orbswarm/orbswarm-svn/media/SWARMtalk/images/shellconstruction.JPG

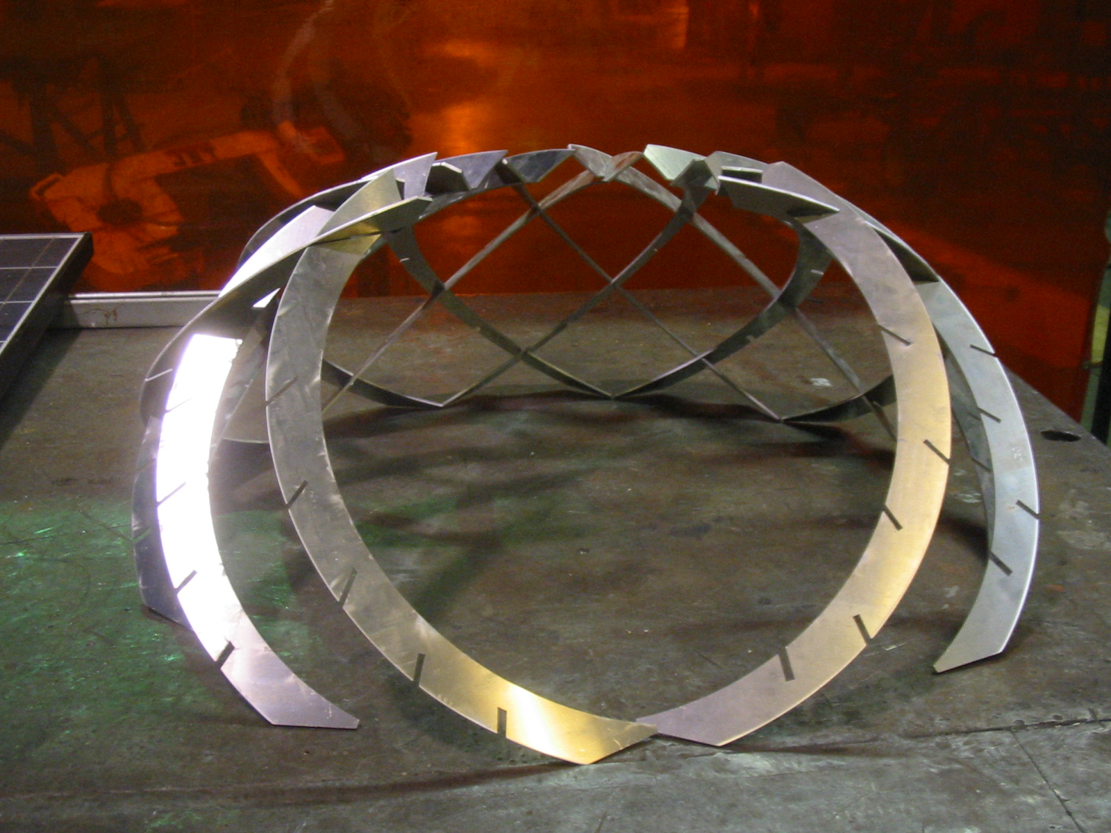
media/SWARMtalk/images/shellconstruction.JPG
