orbswarm/orbswarm-svn/media/SWARMtalk/images/chassis-left.JPG

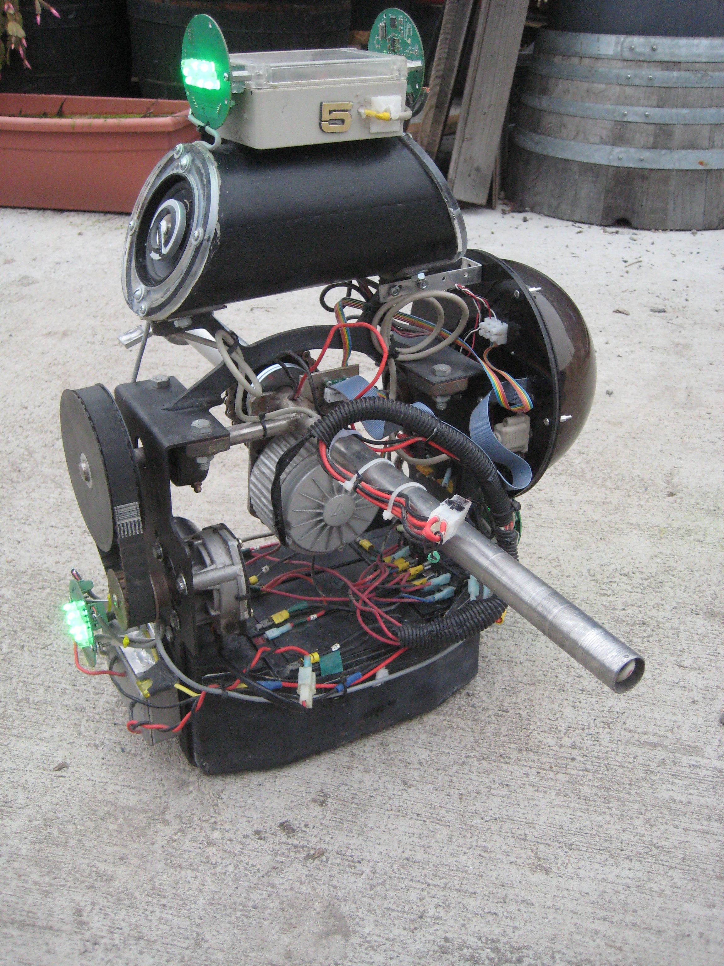
media/SWARMtalk/images/chassis-left.JPG
