orbswarm/orbswarm-svn/README.txt

An import of the Orbswarm subversion repository (http://svn.lee.org/swarm/)
into git, for archival purposes.

                                -- Michael Toren <mct@toren.net>
                                   Thu Oct 23 01:54:14 PDT 2014
