orbswarm/orbswarm-svn/media/readme.txt

This directory contains media files associated with the SWARM project:

SWARMtalk: an Open Office (Powerpoint-like) presentation on SWARM
thankyoucards: Thank-you cards sent out to SWARM supporters
