orbswarm/orbswarm-svn/media/SWARMtalk/readme.txt

In this directory: presentations and images about SWARM

swarm-talk.*: Short 5-slide presentation for Dorkbot
(odp is Open Office powerpoint replacement; I will convert to ppt and rename sometime)

SWARM-ignite.*: more complete 20-slide presentation of O'Reilly Ignite
ppt file is 20MB!

Jon Foote
