orbswarm/orbswarm-svn/media/thankyoucards/readme.txt

This are thank-you cards we sent out in Fall of 2007
It is in Open Office Presenter format: an open-source Powerpoint replacement.

You can get Open Office from here http://www.openoffice.org/

Jon Foote
