orbswarm/orbswarm-svn/Illuminator/DesignFileLocation.txt

All Illuminator design files are located in the PCB/Illuminator directory
