orbswarm/orbswarm-svn/remote/punchlist.txt

For remotes:

Test macro button on all remotes
Test turbo switch and code

To add to remote code:

+ new light modes: hue bloom and brightness modulate (spin)
+ transmit LED
+ set max speed and other modes serially over Zigbee?
