orbswarm/orbswarm-svn/power/OrbRunandChargeCon.pdf

2008/08/12 | OrbRunandChargeCon.odg SWARM
Orb Run & Charge
| Connectors

Notes:
Drawings not to scale
See schematic for wiring details

4

5

6

1

2

3

Red Wire &
Jumper to 2

Black Wire

NC

Run Plug (Fakey)
Male Molex Connector

4

5

6

1

2

3

Jumper to 1

NC

Jumper to 3

Charging Plug
Male Molex Connector

Jumper from 4

NC

Jumper from 6

NC

Red Jumper from 4

NC

Pin View | Pin View
