orbswarm/orbswarm-svn/power/OrbPowerConandBattID.pdf

2008/08/12 | OrbPowerConandBattID.odg SWARM
Orb Power Connector &
Battery Identification

Female Molex Connector
on Orb

(Wire B: 24V for Motor)

(Wire A: Charge Enable)

(Wire D: +12V)

SPU
Dome

Steering
Motor

Batteries in Battery Tray

Notes:
Drawings not to scale
See schematic for wiring details Relays are located above battery 5

5 1

2

3

4

K3

K2

K1

+ | - | + | -

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
(Wire C: +24V)

(Wire F:COM)

(Wire E: +12V for Electr.)

Socket View

Relays
