orbswarm/orbswarm-svn/media/hbroboticsTalk/kalman_estimator.pdf

## Kalman Filters for Robotics:

Getting the Most from your Sensors

Michael Prados
mpradosNOSPAM@gmail.com

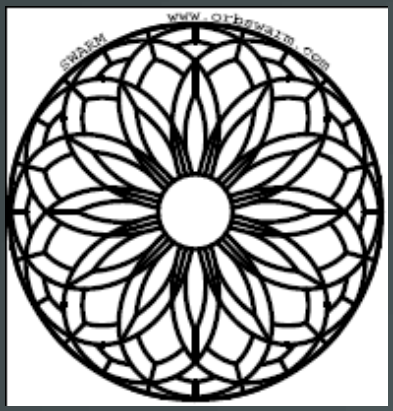
[picture p8: figure]

The SWARM Project
http://orbswarm.com

## What's Wrong With Me?

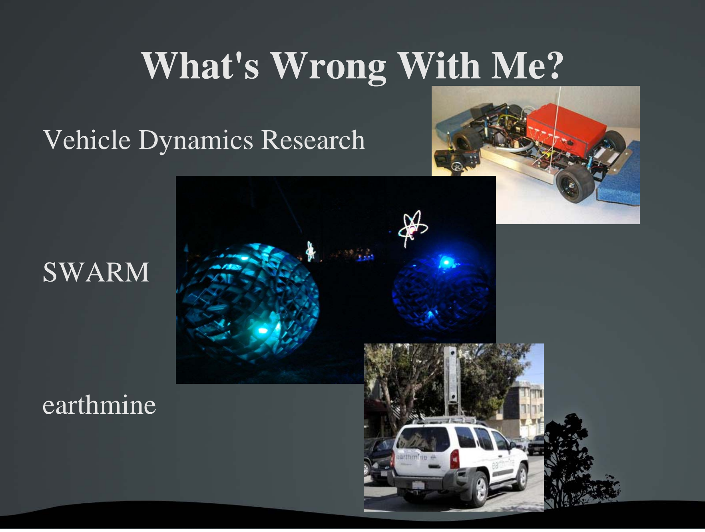
[picture p9: page 2]

Vehicle Dynamics Research

SWARM

earthmine

## SWARM – Positional Robotic Art

- Six Spherical Robots
- 760mm (30in) Diameter, 40kg (90lbs) each
- Consumer Grade GPS- 3m accuracy
- Sparkfun 5-DOF IMU
- ADXL330 3-DOF Accelerometer
- IDG300 2-DOF Rate Gyro
- Wheel Encoder, Kinematic Model
- All Open Source!

## Some Positional Sensors for Robotics

Sensors are a robot's window to the world!
- Inertial sensors
- Accelerometers
- Rate Gyros
- Electrolytic Tilt Sensors
- Position Sensors
- GPS
- Wheel Encoders
- Sonar

## Problems with Positional Sensors

- Inertial sensors – DC Bias, Noise
- Position Sensors
- GPS – outages, low frequency, noise
- Wheel Encoders – relative position, slip
- Sonar – limited range, noise

## What is a Kalman Filter?

(aka Kalman Estimator, Kalman Observer)
- A Kalman filter is an optimal observer
- It will trade off the relative strengths of your sensors, in order to provide an optimal estimate of your system states
- Always applied to a state space model of a system
- Must derive a system model, but can often be simple
- Either discrete time or continuous
- Usually must go to discrete time for implementation

## Octave and Matlab

- Matlab is an expensive commercial product for matrix algebra and numerical processing
- Great estimation and control system support
- Octave is a very similar, free open source alternative
- Almost as good
- Easier to share

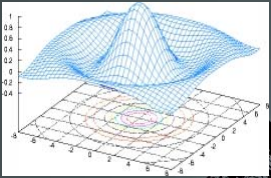
[picture p10: figure]

## What is a State Space Model?

- A model of a dynamic system,
using a system of differential equations
- In general:
- An example:

x˙ =Ax

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
[⁰0 10

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
[countencoder]=[0

k ]

[
v
x

]

## Small Angle Approximation

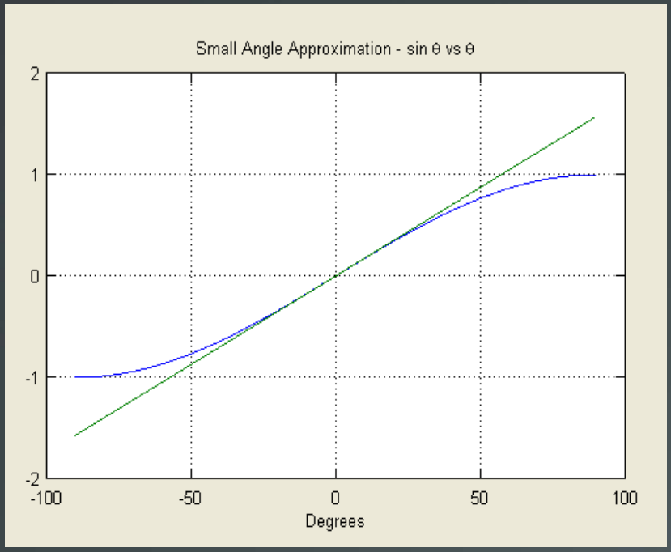
[picture p11: figure]

- Pretty good up to +/- 30 degrees
- Remember to implement using radians!

## Continuous vs Discrete

- Continuous time is a mathematically elegant representation using derivatives
- Relatively hard to code!
- Discrete time representation tells you directly how to get the next step from the current one
- For most systems, octave will do the conversion! discrete_sys = c2d(continuous_sys, T);

x
k
1

=
f
x
k

## The Observer

- For a system-
- We estimate the states like this-

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
## Inverted Pendulum

- Inverted pendulum model
- Rate gyro, and accelerometer tilt sensor

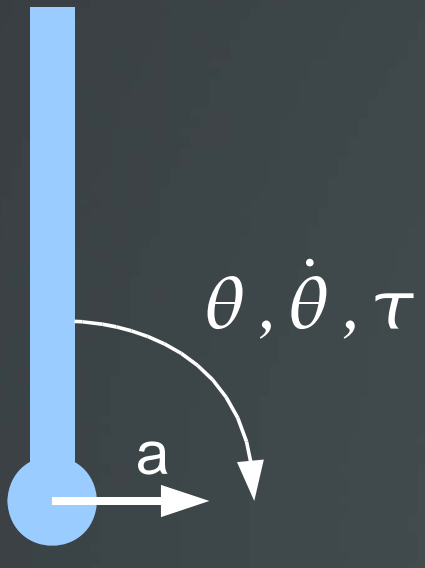
[picture p12: figure]

[
¨

˙]
=

[⁰0 10

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
In Octave...

- Create system
with A,B,C,D
- Use c2d
- Set QW, RV
- Invoke dkalman

### Presto, optimal observer!

### [¨˙]=[⁰0 10][˙][¹/I m 0 ]W

[a ]=[¹0 0 g ][˙]V

A | B

C

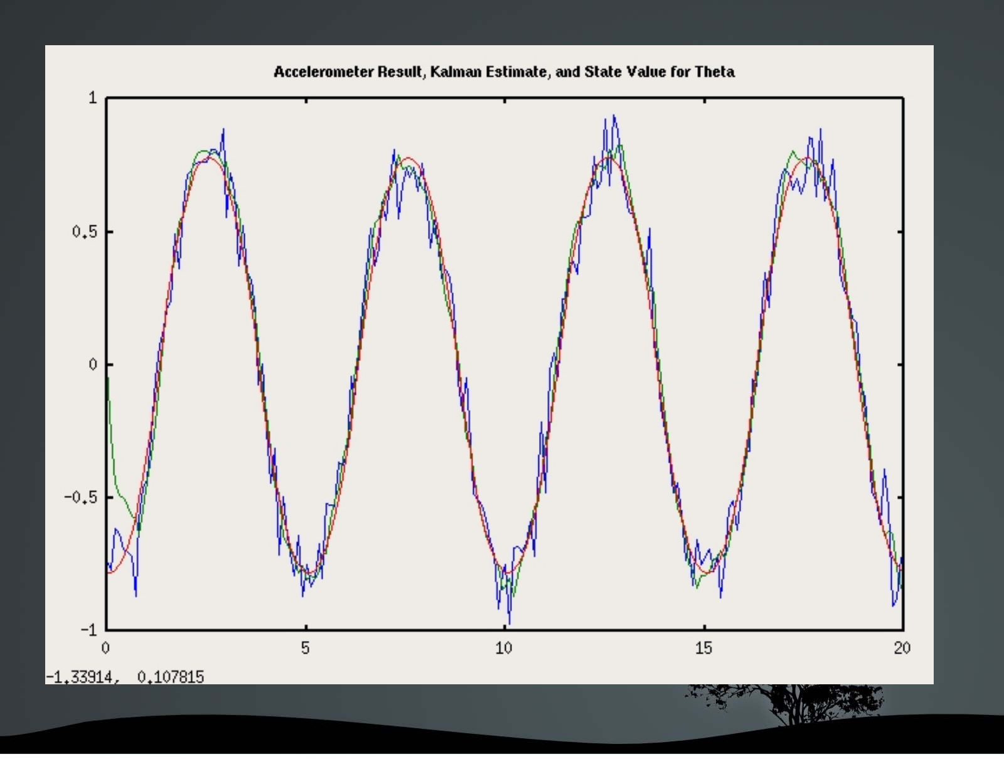
[picture p13: page 14]
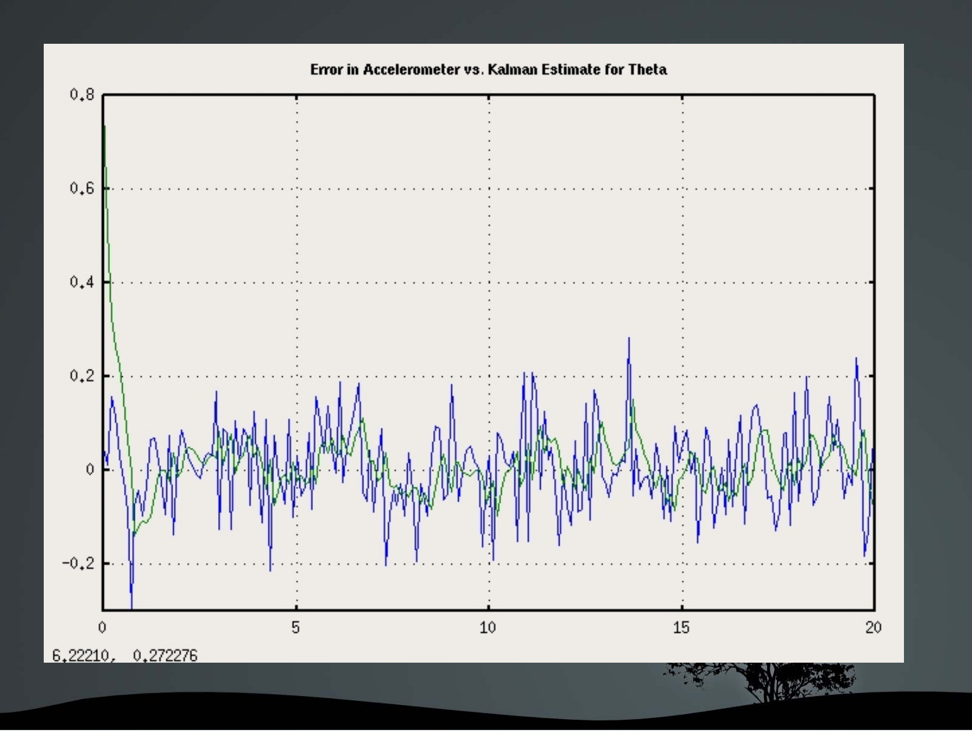
[picture p14: page 15]

## Limitations of the Kalman Filter

- For Good Performance
- No strong nonlinearities
- Definitely no trig with greater than +/- 90 degree motion!
- Zero-mean noise – No DC offset
- Necessary conditions to be optimal, but often less important-
- Noise has gaussian distribution
- Noise is white
- Noise is not auto-correlated

## DC Offset

- Common for inertial sensors
- Rate Gyro's and accelerometers
- Need to debias
- Add state to system-
[ ¨˙ bias˙ gyro]=[⁰⁰⁰ ¹⁰¹ 000][ ˙ biasgyro][¹/I m 00 ]W

[a ]=[¹00 0 g 0][ ˙ biasgyro]V

## Extended Kalman Filter

- Necessary for systems with strong nonlinearity
- Large angle motion- certainly greater that 180 degrees
- Squares, cubes, exponentials

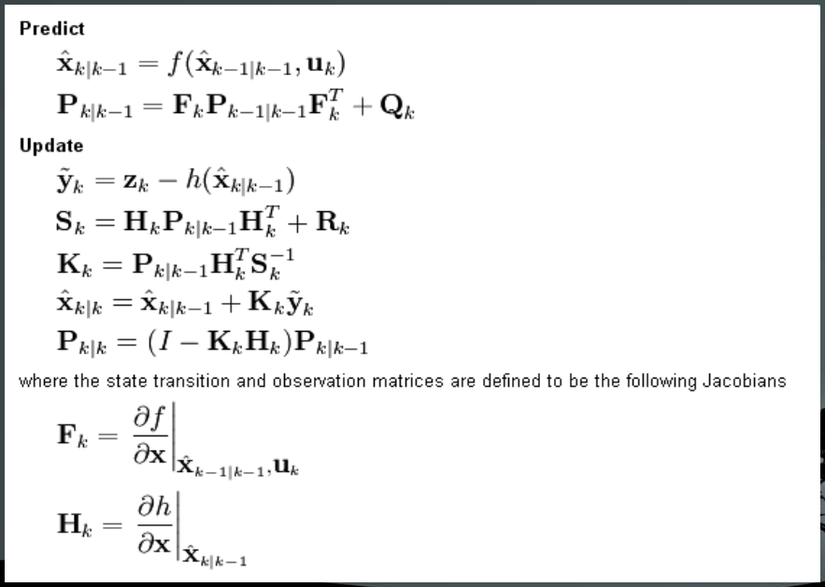
[picture p15: figure]

## SWARM Extended Kalman Filter

- 13 states
- 10 sensors
- Kinematic model – too big for slide.
- Work in progress! | info@orbswarm.com
v,v, ˙ | ˙ ,, ,, x ,y,
xab ,yab ,zab , xrb ,zrb

x

a ,y

| a ,z a , x r ,z r , xgps ,y gps ,gps ,v gps ,

## Implementation

- Translation to C code
- Easier with some matrix manipulation libraries
- Fixed vs floating point
- Usually possible in fixed point, but often quite laborious
- For more than 2-4 states, probably worth floating point
- Emulation – 8 bit micro, ARM
- FPU – x86, PPC, some ARM (caution!)
- DSP – great platform, steep learning curve

## Where to Go

Good Optimization and Control Texts:
- Design of Feedback Control Systems
- Stefani, Shahian, Savant, Hostetter – Oxford University Press
- Digital Control of Dynamic Systems
- Franklin, Powell, and Workman – Addison Wesley
More advanced:
- Applied Optimal Estimation
- Gelb – M.I.T. Press
- Optimal Control and Estimation
- Stengel – Dover Publications

## Thanks!

?
