orbswarm/orbswarm-svn/pcb/aggregator/netlist.txt

Netlist

Exported from swarm-agg1.sch at  6/19/2007 05:56:52a

EAGLE Version 4.16r1 Copyright (c) 1988-2006 CadSoft

Net      Part     Pad      Pin        Sheet

GND      C1       2        2          1
         C10      2        2          1
         C11      2        2          1
         C12      2        2          1
         C13      2        2          1
         C14      2        2          1
         C15      2        2          1
         C19      2        2          1
         C2       2        2          1
         C20      2        2          1
         C24      2        2          1
         C25      2        2          1
         C27      2        2          1
         C3       2        2          1
         C4       2        2          1
         C5       2        2          1
         C6       2        2          1
         C7       2        2          1
         C8       2        2          1
         C9       2        2          1
         IC3      GND      GND        1
         J1       1        1          1
         J2       2        S          1
         J3       1        1          1
         J3       5        5          1
         J4       6        6          1
         U1       11       GND        1
         U1       32       GND1       1
         U1       62       GND2       1
         U1       81       GND3       1
         U1       99       AGND       1
         U2       15       GND        1
         U3       15       GND        1
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
         U1       10       VCC        1
         U1       31       VCC1       1
         U1       61       VCC2       1
         U1       80       VCC3       1
         U2       16       VCC        1
         U3       16       VCC        1
         XB1      1        VCC        1
