orbswarm/orbswarm-svn/media/SWARMtalk/swarm-talk.odp

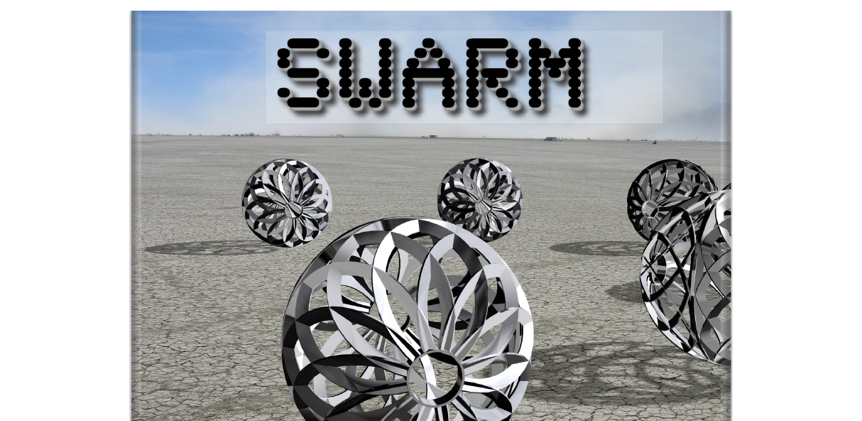
[picture p16: figure]

## Slide 2

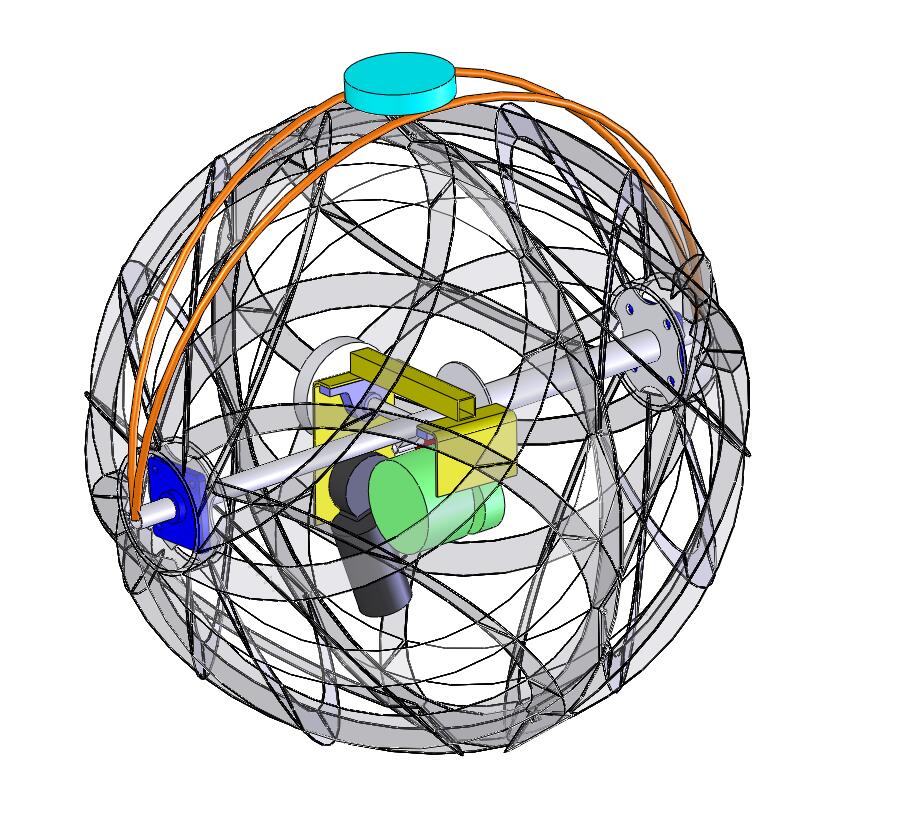
[picture p17: figure]
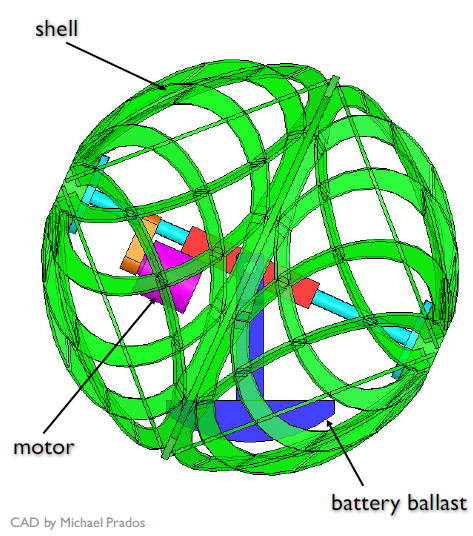
[picture p18: figure]

## Slide 3

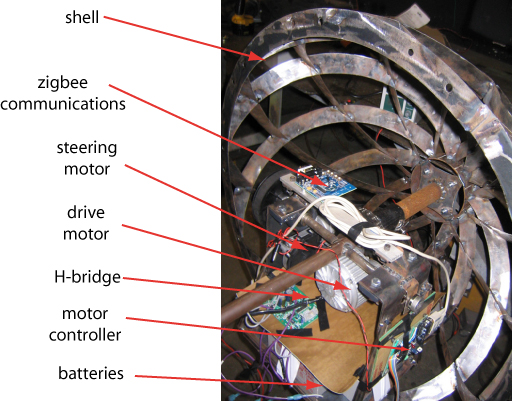
[picture p19: figure]
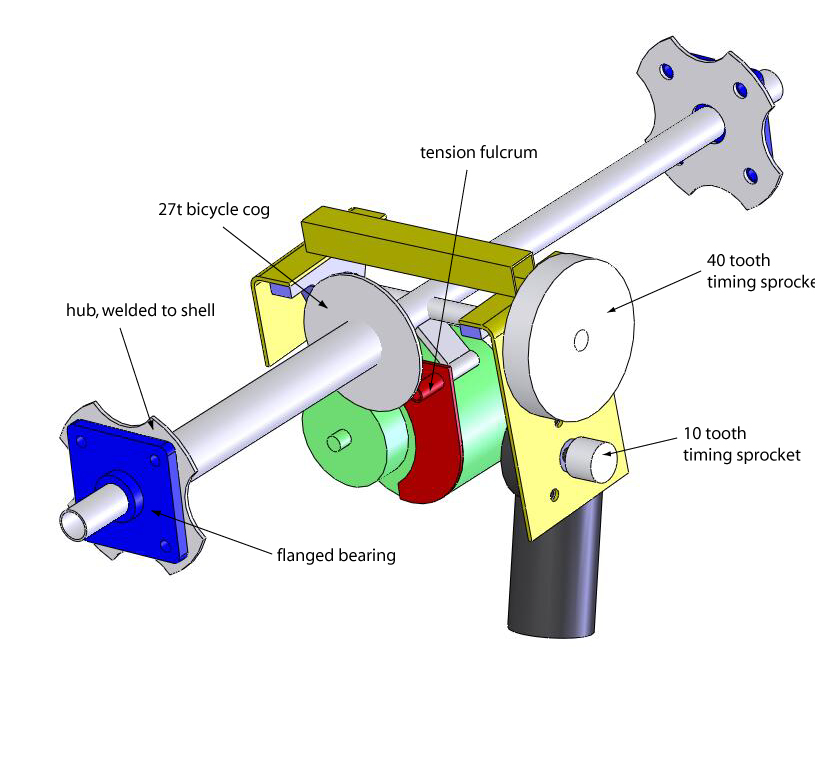
[picture p20: figure]

## Slide 4

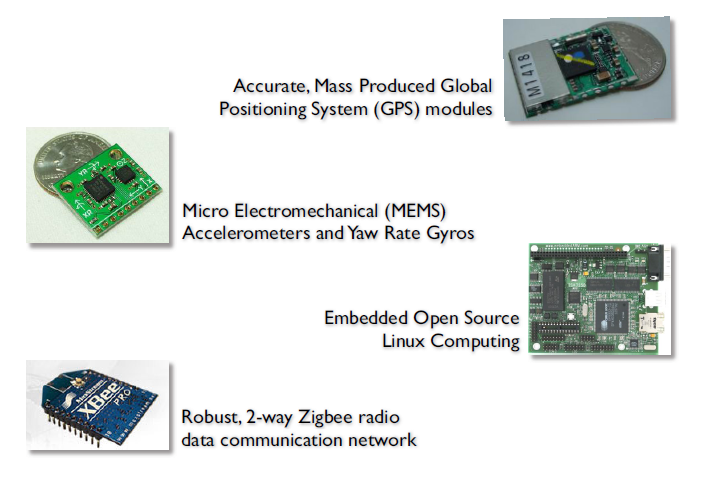
[picture p21: figure]

## Slide 5

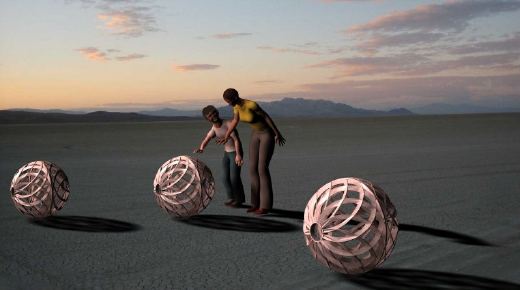
[picture p22: figure]

## Slide 6

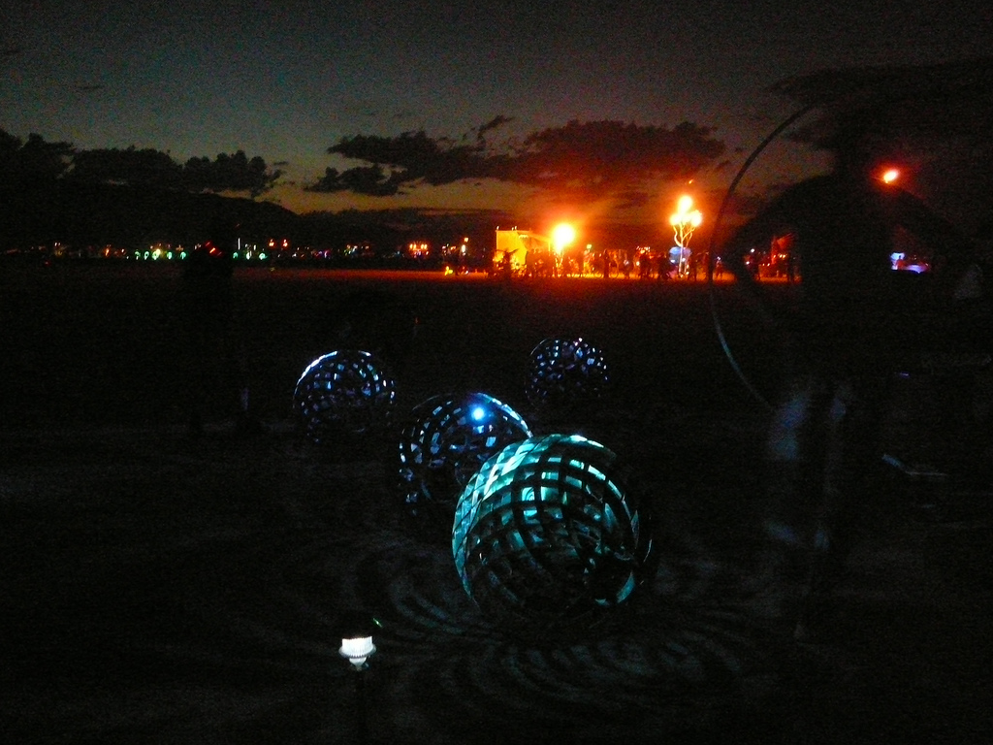
[picture p23: figure]
