orbswarm/orbswarm-svn/media/thankyoucards/thankyou.pdf

# SWARM thanks you

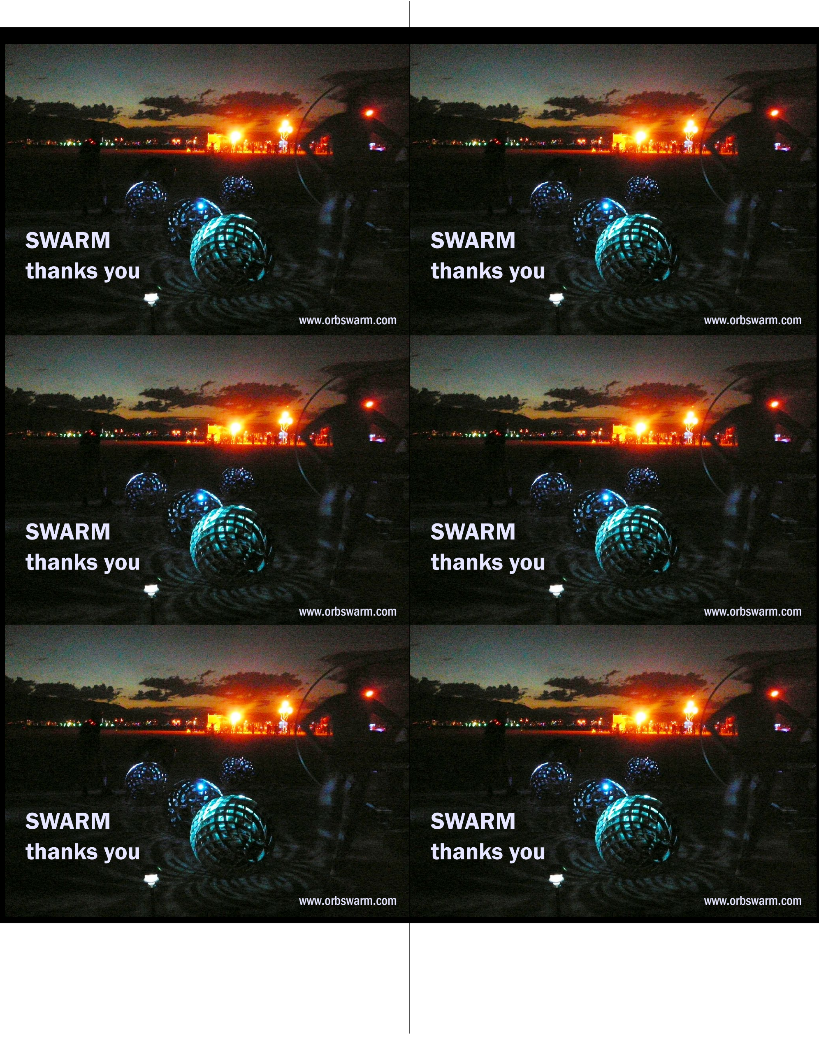
[picture p24: page 1]

www.orbswarm.com

www.orbswarm.com

# SWARM thanks you

www.orbswarm.com

# SWARM thanks you

www.orbswarm.com

# SWARM thanks you

www.orbswarm.com

# SWARM thanks you

www.orbswarm.com

# SWARM thanks you
