orbswarm/orbswarm-svn/media/cards/SWARM_businesscard.jpg

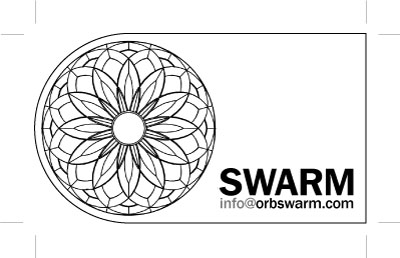
media/cards/SWARM_businesscard.jpg
