orbswarm/orbswarm-svn/media/cards/SWARM_personalcard.jpg

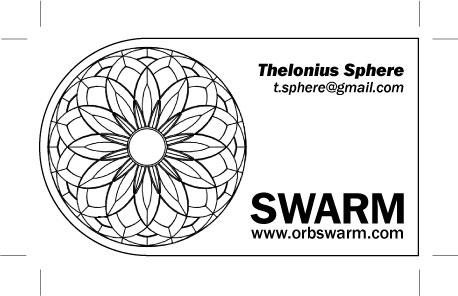
media/cards/SWARM_personalcard.jpg
