orbswarm/orbswarm-svn/media/stickers/SWARM_sticker_design_600px.jpg

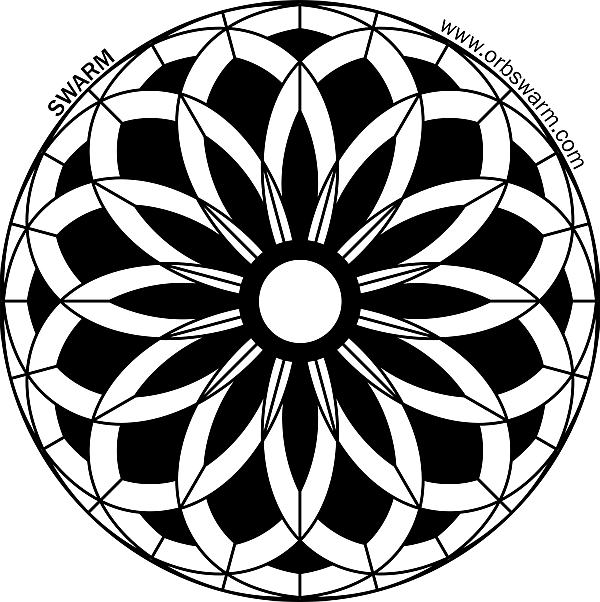
media/stickers/SWARM_sticker_design_600px.jpg
