orbswarm/orbswarm-svn/media/SWARMtalk/images/2007man.jpg

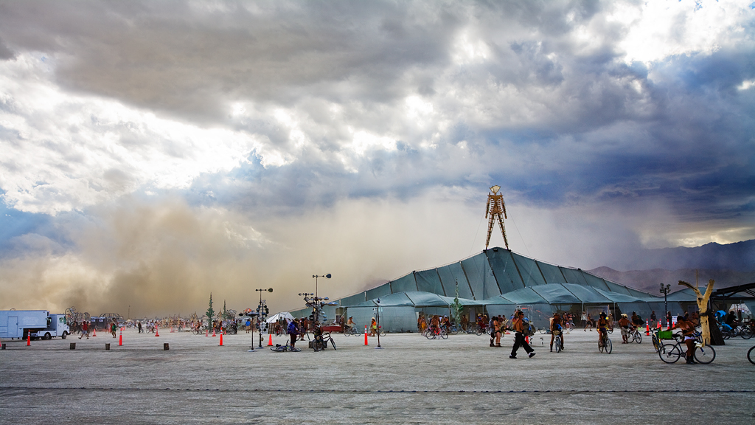
media/SWARMtalk/images/2007man.jpg
