orbswarm/orbswarm-svn/media/SWARMtalk/images/Burningcam-picture-49.jpg

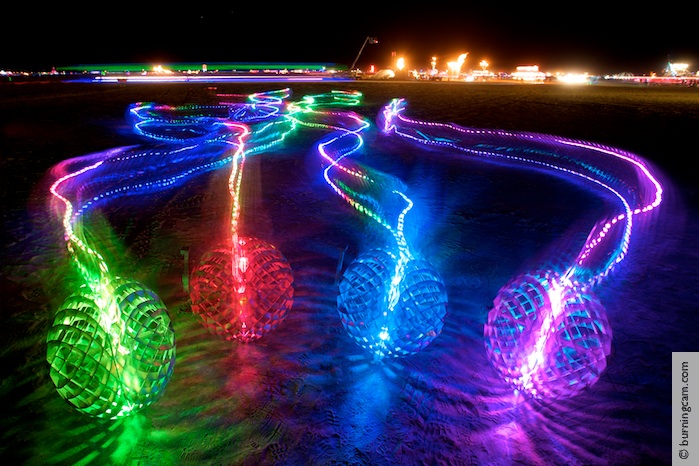
media/SWARMtalk/images/Burningcam-picture-49.jpg
