orbswarm/orbswarm-svn/media/SWARMtalk/images/California-Academy-Nightlife.jpg

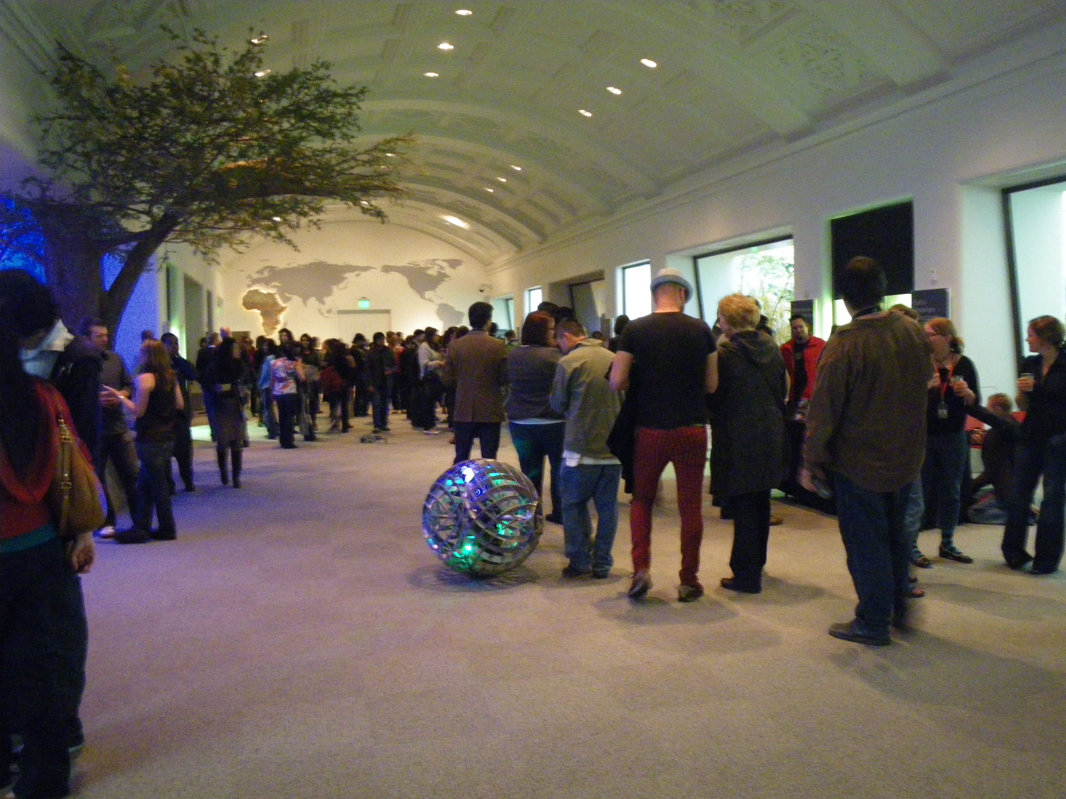
media/SWARMtalk/images/California-Academy-Nightlife.jpg
