orbswarm/orbswarm-svn/media/SWARMtalk/images/chassis-right.JPG

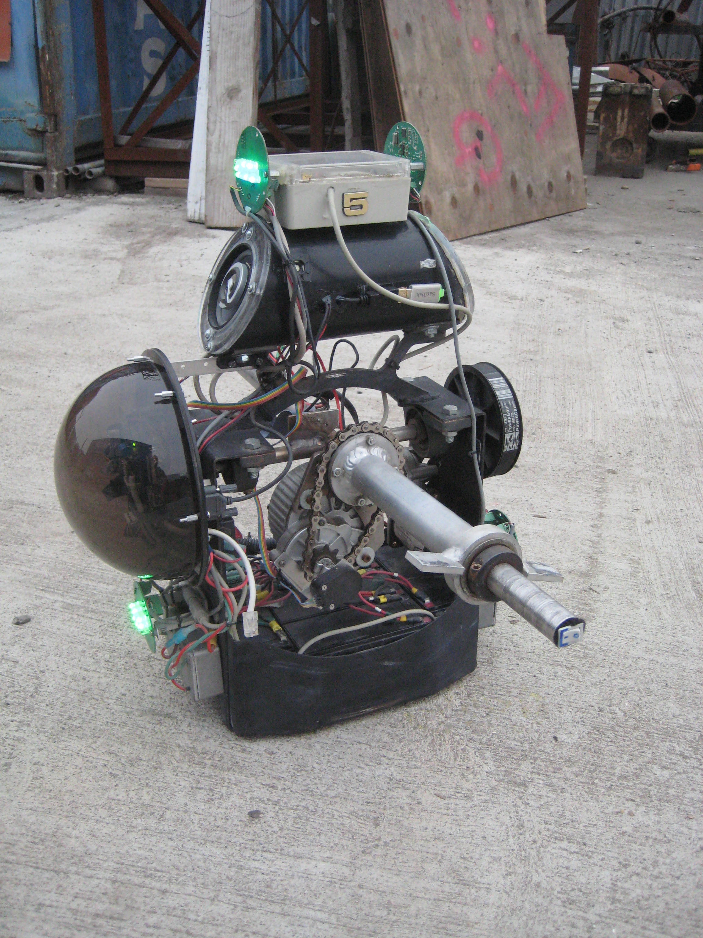
media/SWARMtalk/images/chassis-right.JPG
