orbswarm/orbswarm-svn/media/SWARMtalk/images/dust+man.jpg

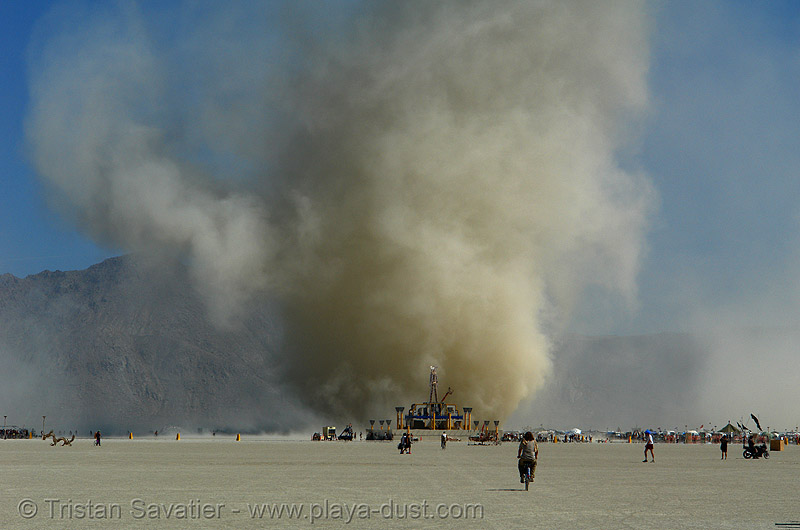
media/SWARMtalk/images/dust+man.jpg
