orbswarm/orbswarm-svn/media/SWARMtalk/images/Frederic_Larson_Crash_and_Burn.png

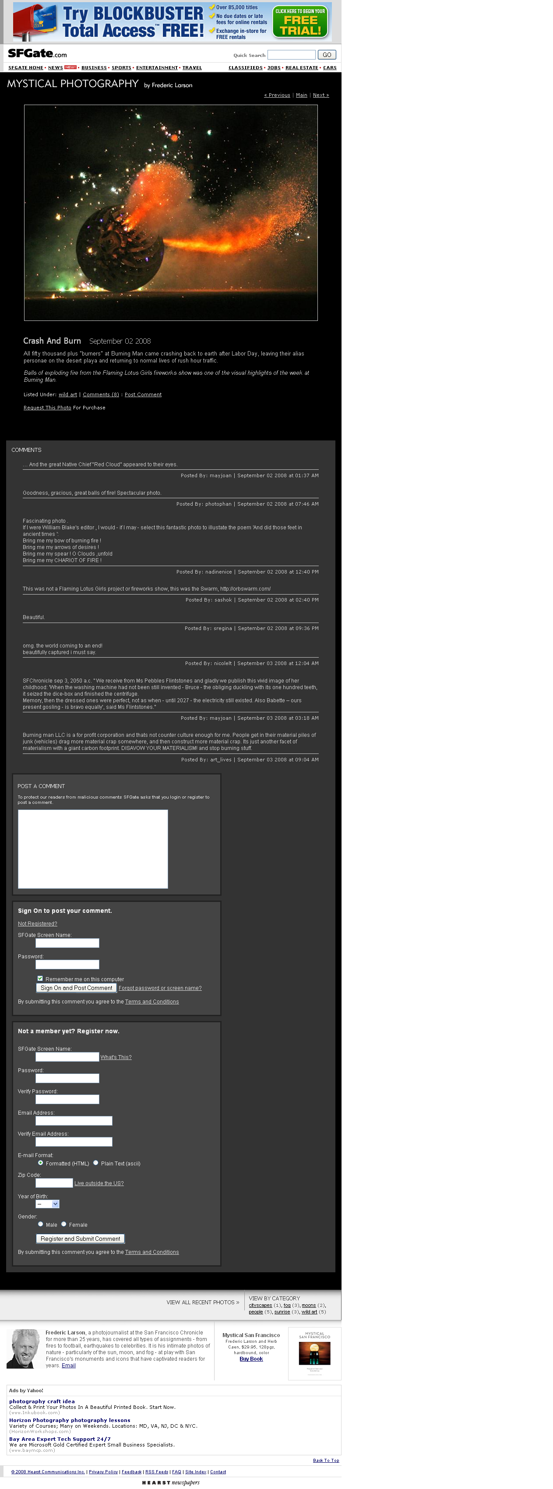
media/SWARMtalk/images/Frederic_Larson_Crash_and_Burn.png
