orbswarm/orbswarm-svn/media/SWARMtalk/images/GlamourLee+erik.JPG

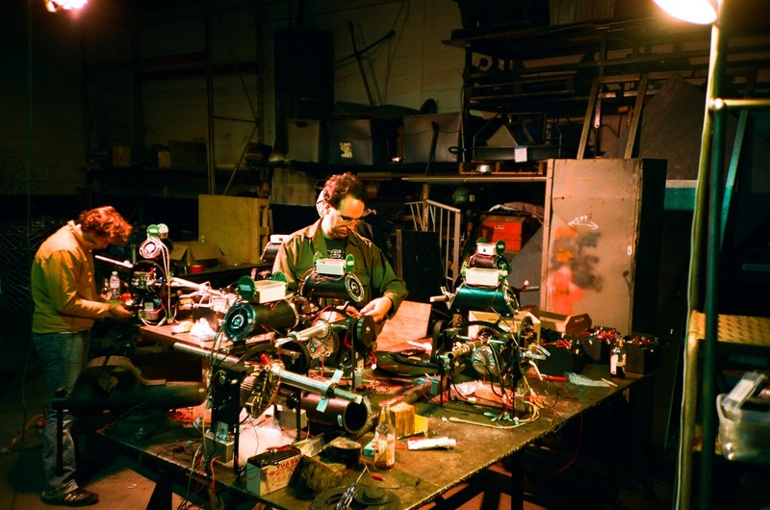
media/SWARMtalk/images/GlamourLee+erik.JPG
