orbswarm/orbswarm-svn/media/SWARMtalk/images/img_9218.jpg

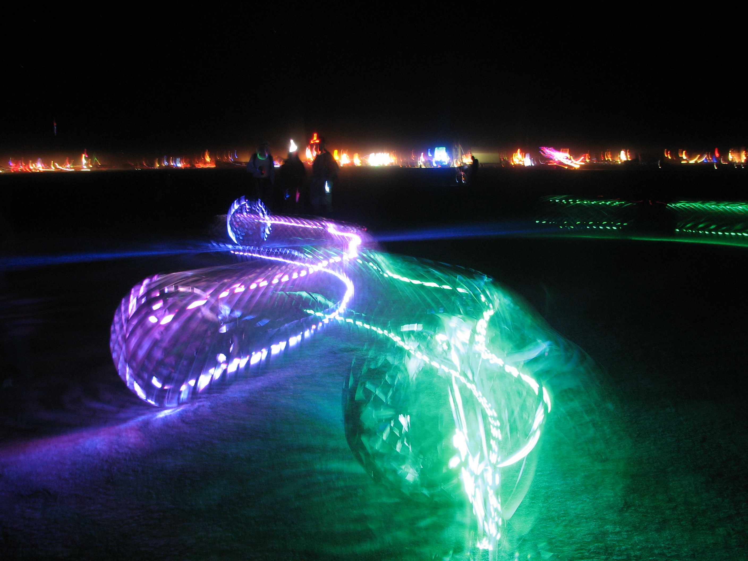
media/SWARMtalk/images/img_9218.jpg
