orbswarm/orbswarm-svn/media/SWARMtalk/images/Mechanical_annot.jpg

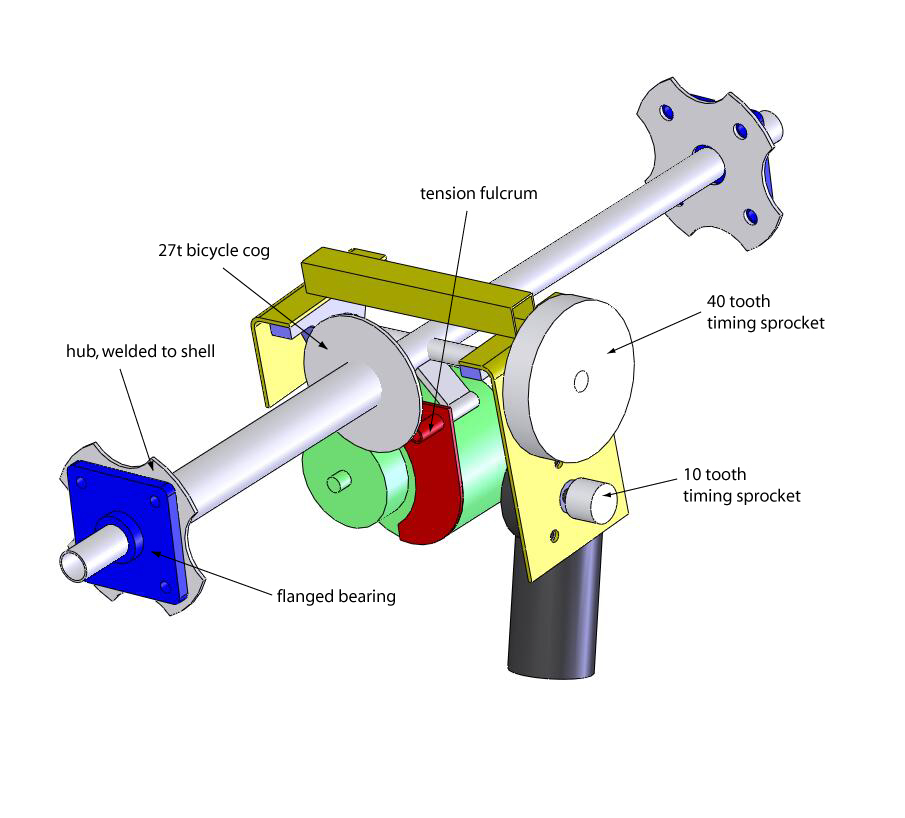
media/SWARMtalk/images/Mechanical_annot.jpg
