orbswarm/orbswarm-svn/media/SWARMtalk/images/mothership-night.jpg

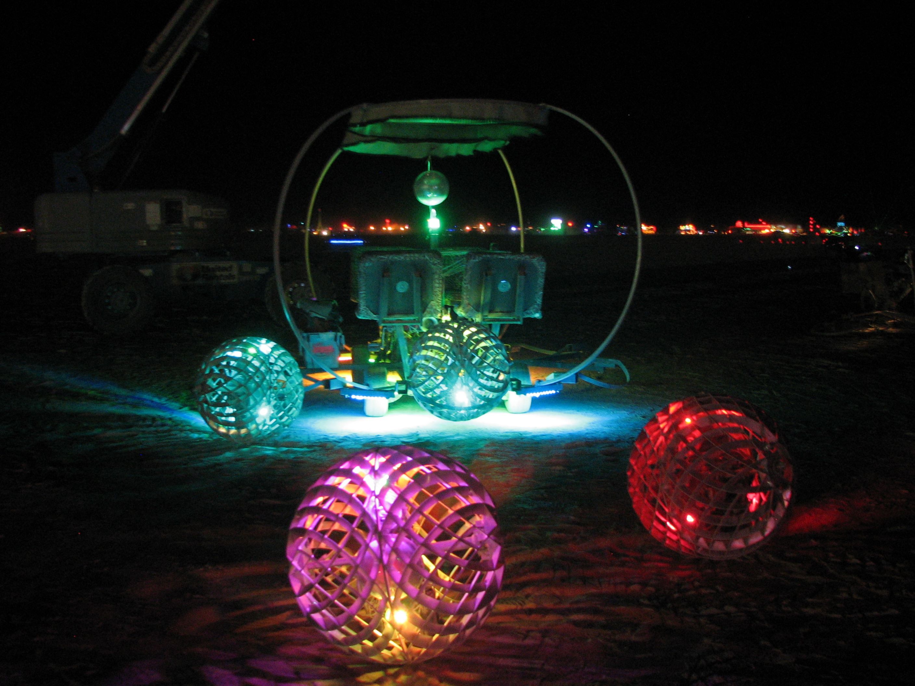
media/SWARMtalk/images/mothership-night.jpg
