orbswarm/orbswarm-svn/media/SWARMtalk/images/orbs2.jpg

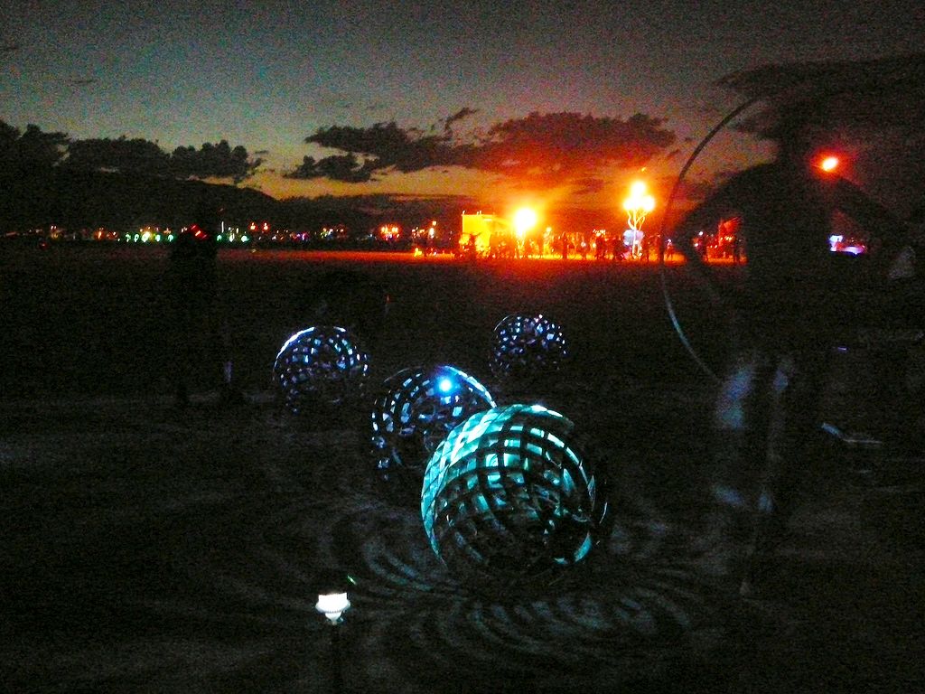
media/SWARMtalk/images/orbs2.jpg
