orbswarm/orbswarm-svn/media/SWARMtalk/images/OrbsAtSomArts.jpg

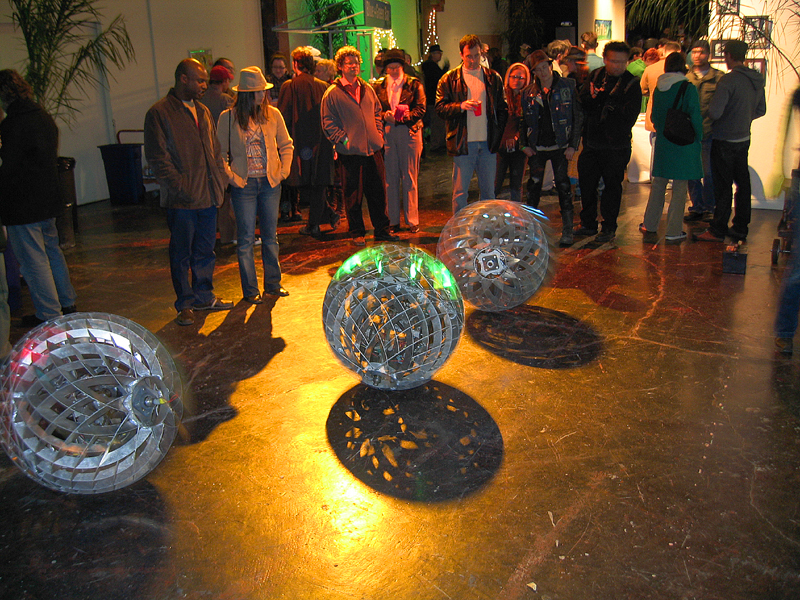
media/SWARMtalk/images/OrbsAtSomArts.jpg
