orbswarm/orbswarm-svn/media/SWARMtalk/images/playa-night.jpg

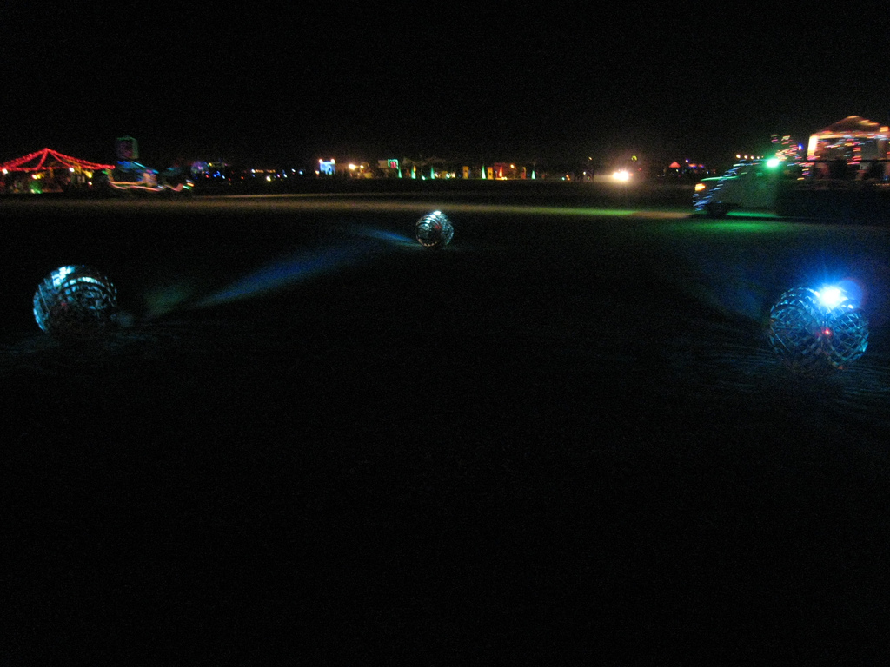
media/SWARMtalk/images/playa-night.jpg
