orbswarm/orbswarm-svn/media/SWARMtalk/images/playaline.JPG

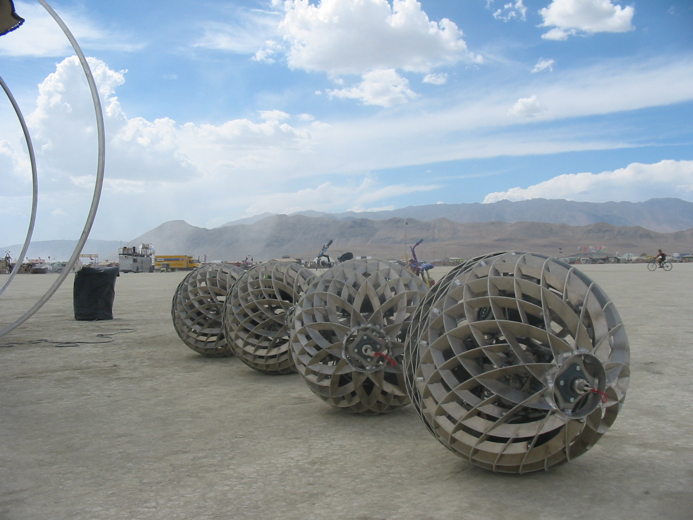
media/SWARMtalk/images/playaline.JPG
