orbswarm/orbswarm-svn/media/SWARMtalk/images/playavacuum.jpg

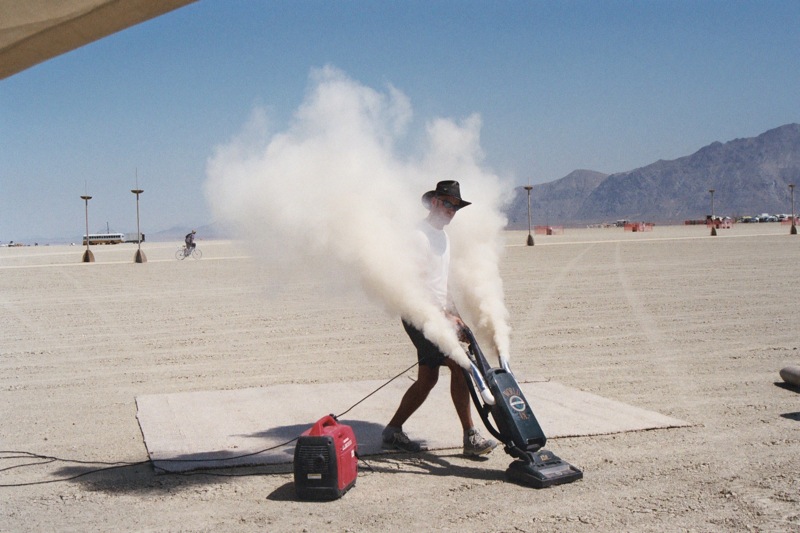
media/SWARMtalk/images/playavacuum.jpg
