orbswarm/orbswarm-svn/media/SWARMtalk/images/shell.JPG

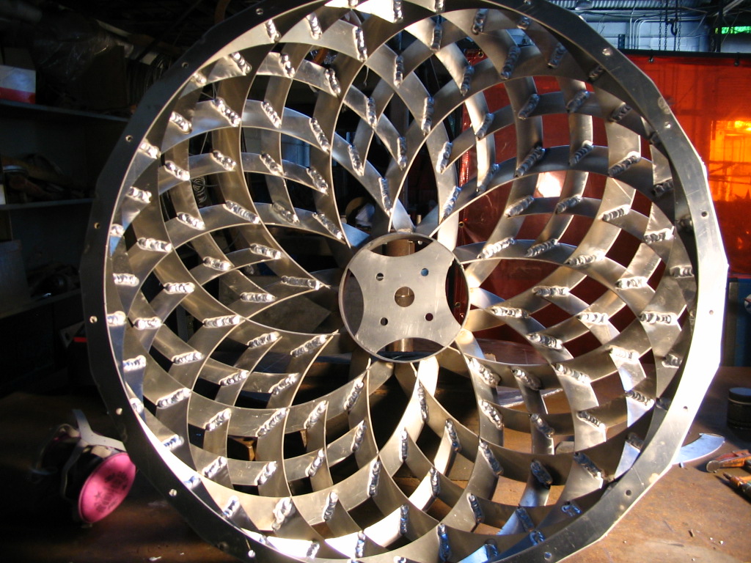
media/SWARMtalk/images/shell.JPG
