orbswarm/orbswarm-svn/media/SWARMtalk/images/shellrender45.png

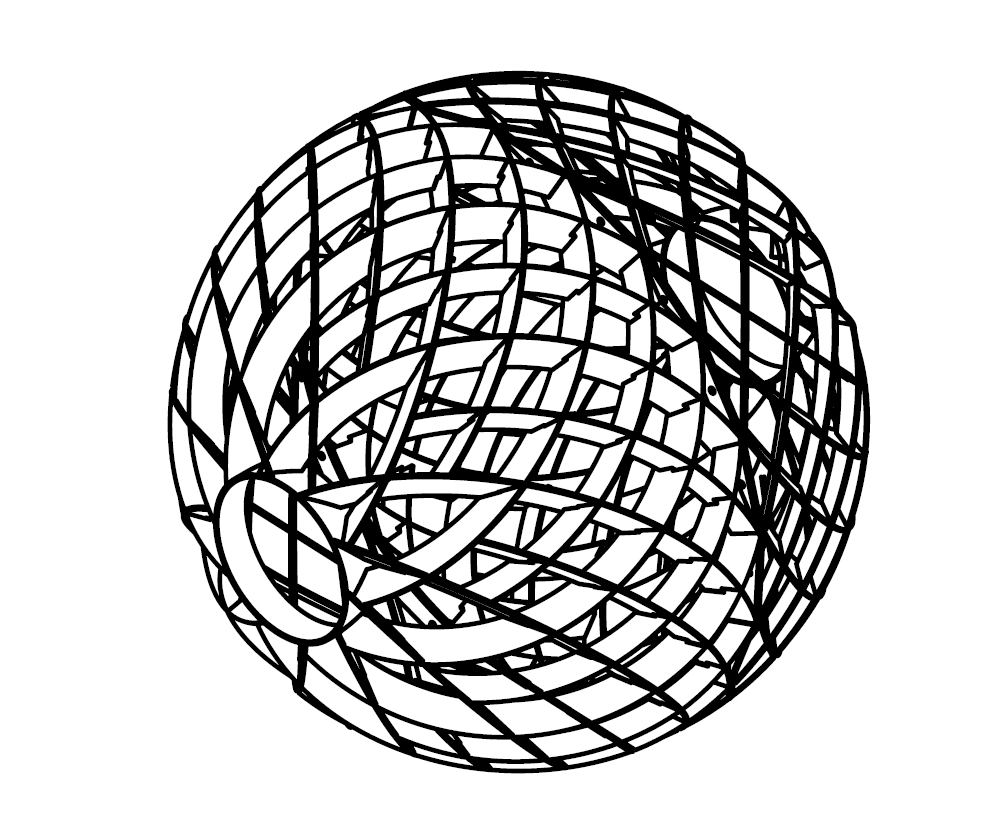
media/SWARMtalk/images/shellrender45.png
