orbswarm/orbswarm-svn/media/SWARMtalk/images/shellrender90.png

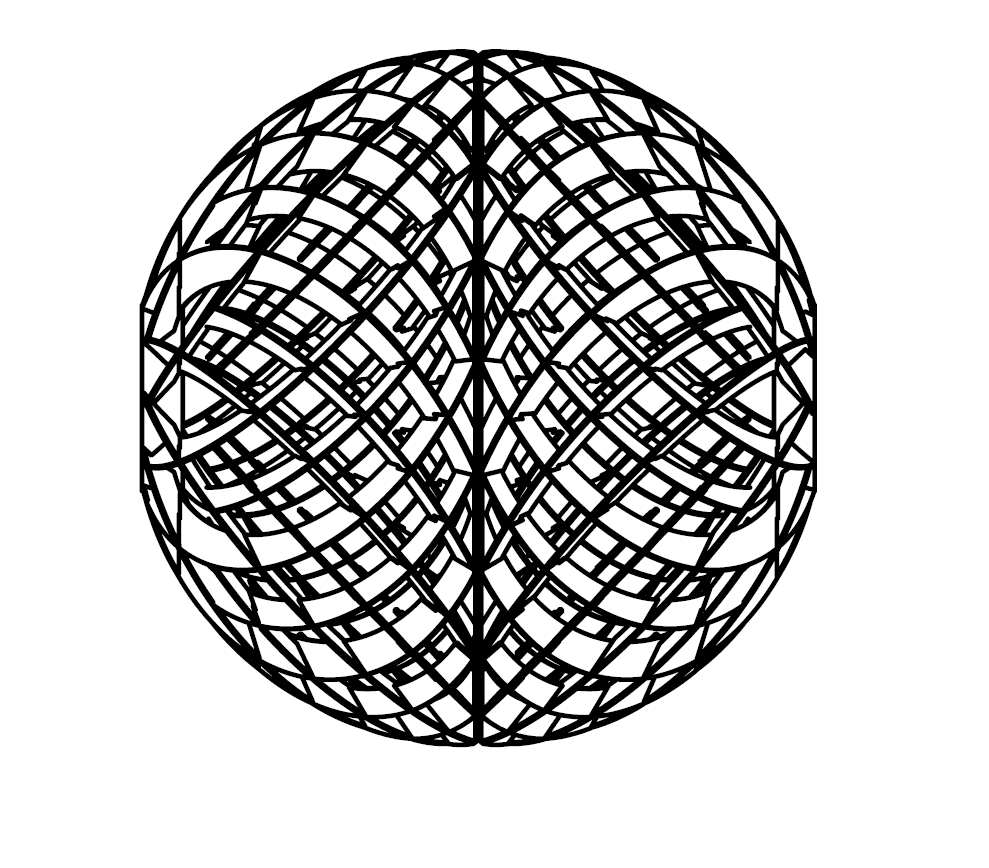
media/SWARMtalk/images/shellrender90.png
