orbswarm/orbswarm-svn/media/SWARMtalk/images/shopfloor.JPG

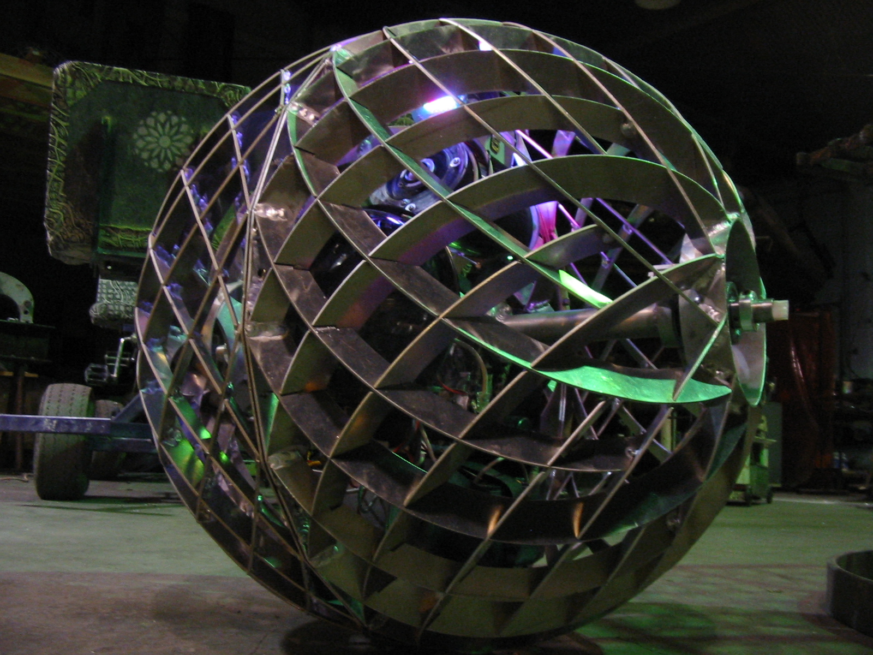
media/SWARMtalk/images/shopfloor.JPG
