orbswarm/orbswarm-svn/media/SWARMtalk/images/soccer.jpg

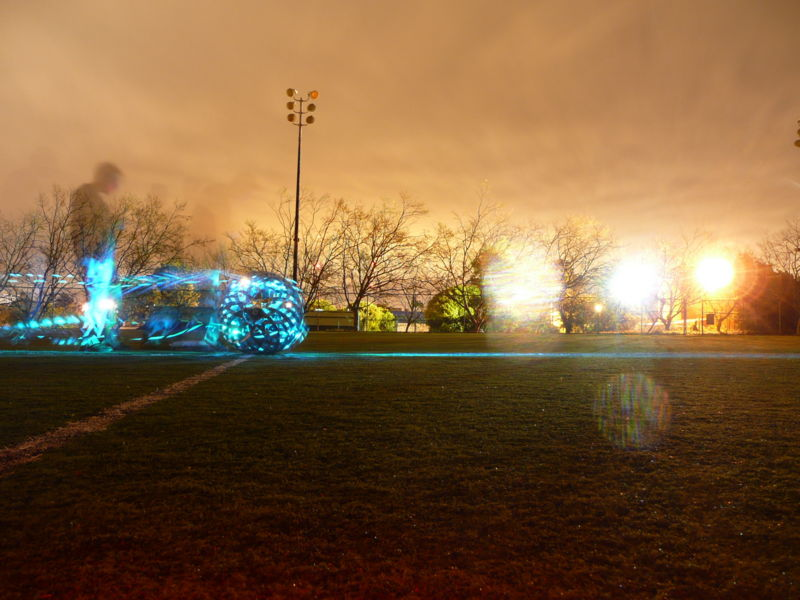
media/SWARMtalk/images/soccer.jpg
