orbswarm/orbswarm-svn/media/SWARMtalk/images/Temple.jpg

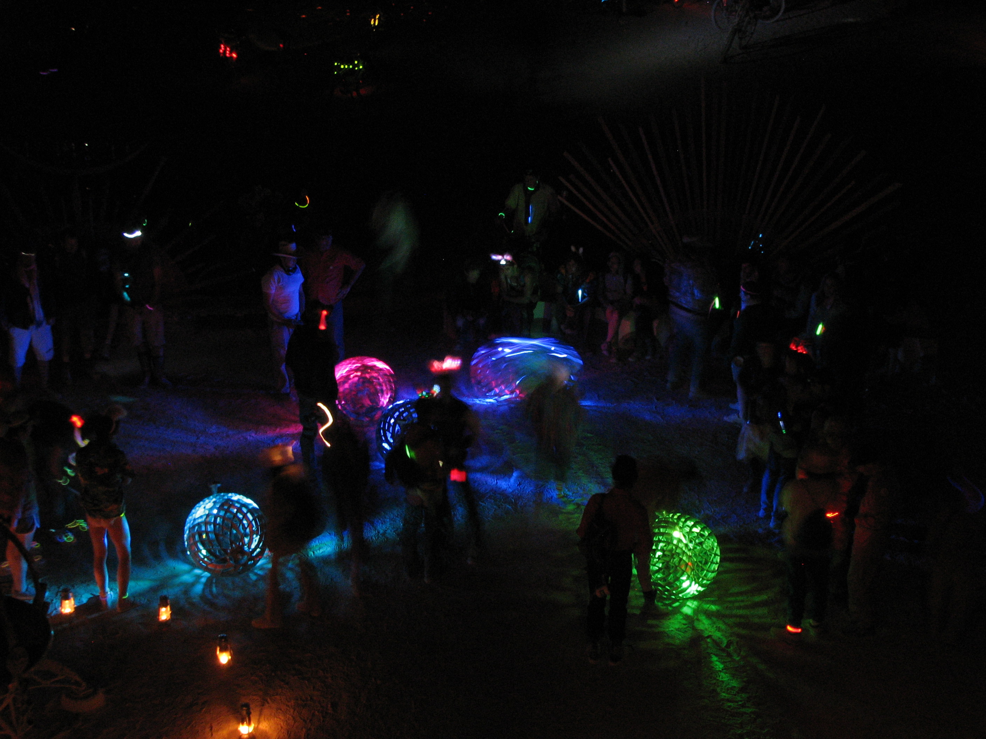
media/SWARMtalk/images/Temple.jpg
