orbswarm/orbswarm-svn/media/SWARMtalk/images/tshirt.jpg

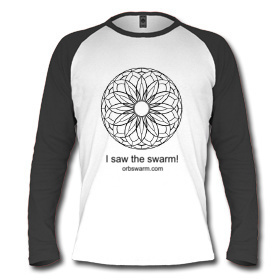
media/SWARMtalk/images/tshirt.jpg
