orbswarm/orbswarm-svn/mothernode/java/resources/documents/orbmodel.png

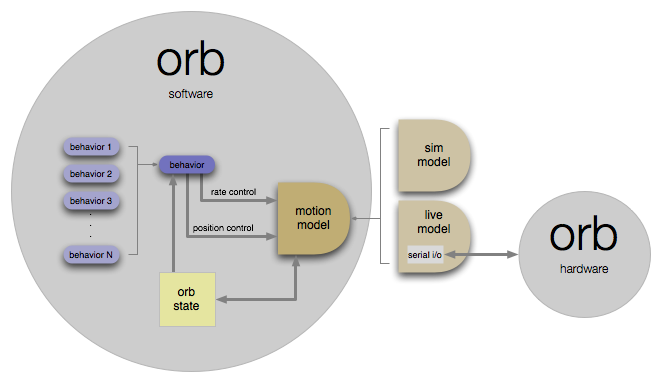
mothernode/java/resources/documents/orbmodel.png
