orbswarm/orbswarm-svn/power/OrbPowerConandBattID.jpg

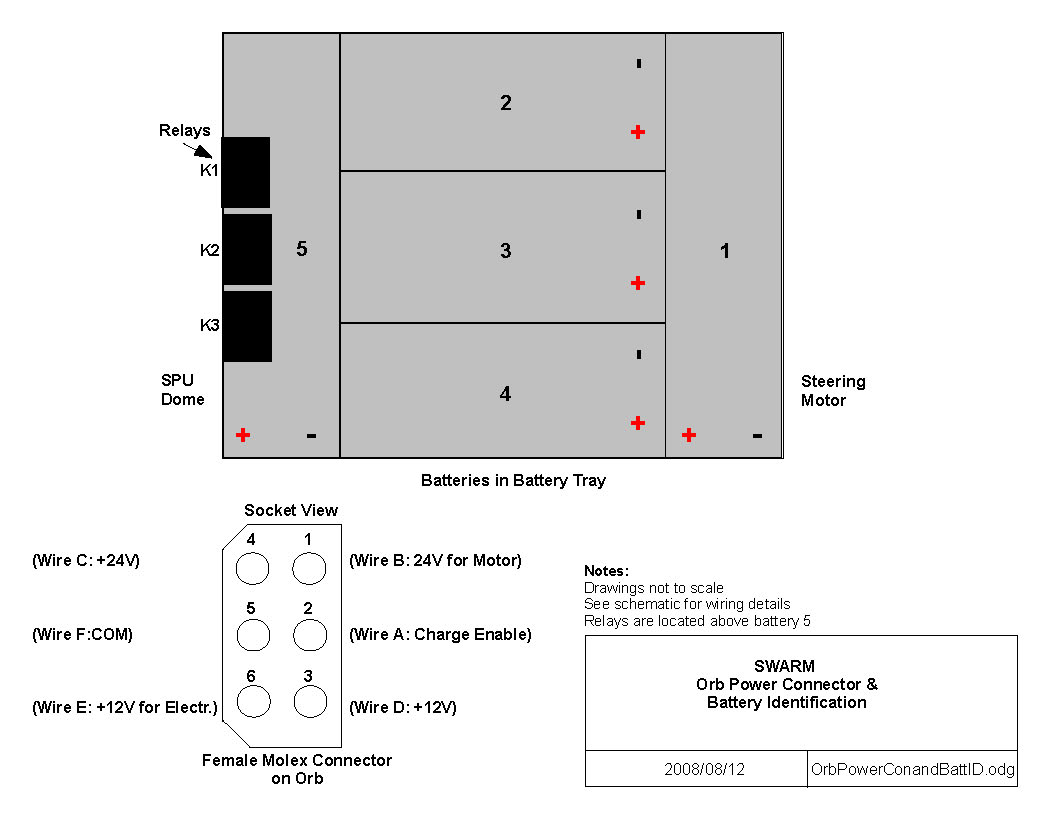
power/OrbPowerConandBattID.jpg
