orbswarm/orbswarm-svn/power/OrbRunandChargeCon.jpg

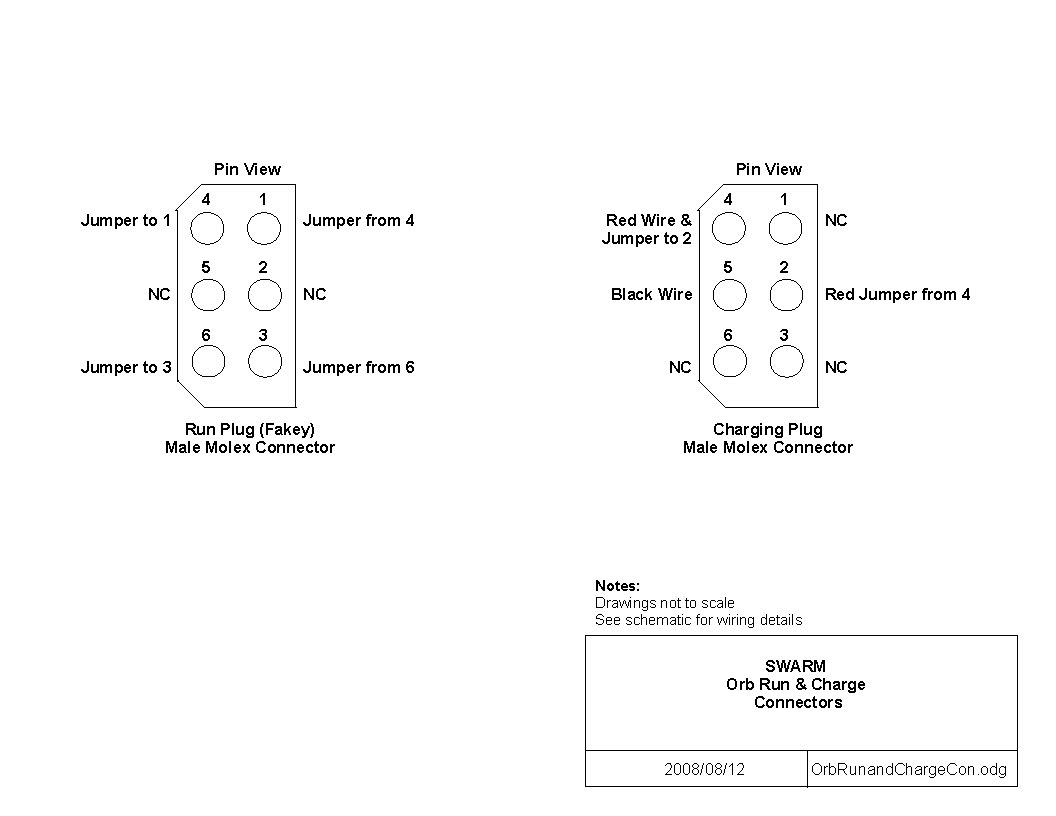
power/OrbRunandChargeCon.jpg
