orbswarm/orbswarm-svn/spu/data/20080727/kalmanoverhead.jpg

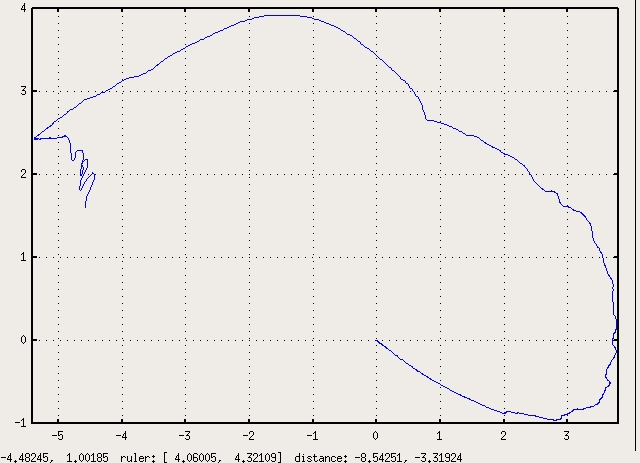
spu/data/20080727/kalmanoverhead.jpg
