orbswarm/orbswarm-svn/spu/data/20080729/circle_newgps/overhead_cmyk.jpg

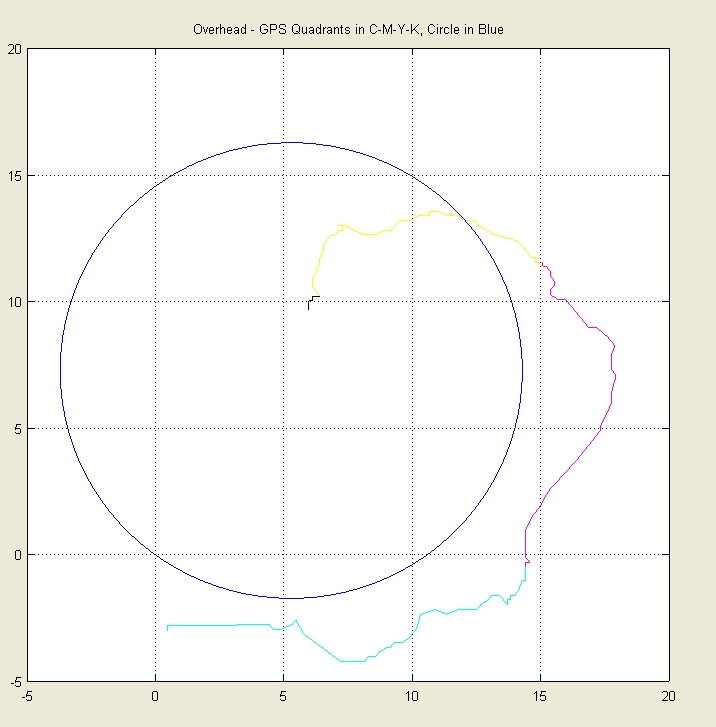
spu/data/20080729/circle_newgps/overhead_cmyk.jpg
