orbswarm/orbswarm-svn/spu/data/20080729/circle_newgps/speed.jpg

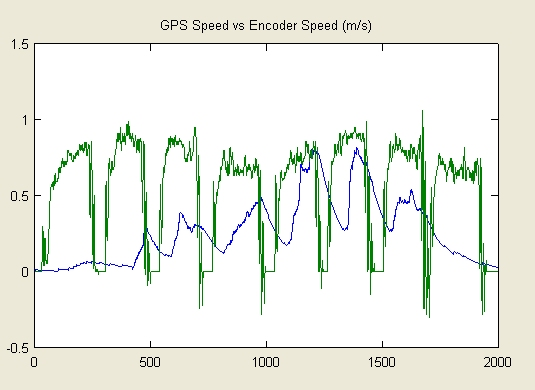
spu/data/20080729/circle_newgps/speed.jpg
