orbswarm/orbswarm-svn/spu/data/20080729/circle_oldgps/speed.jpg

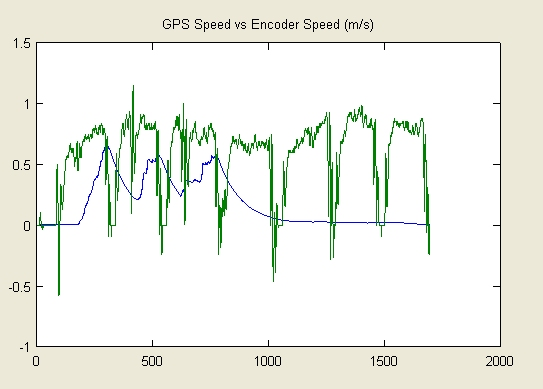
spu/data/20080729/circle_oldgps/speed.jpg
