orbswarm/orbswarm-svn/spu/data/20080815/auto4/overhead.jpg

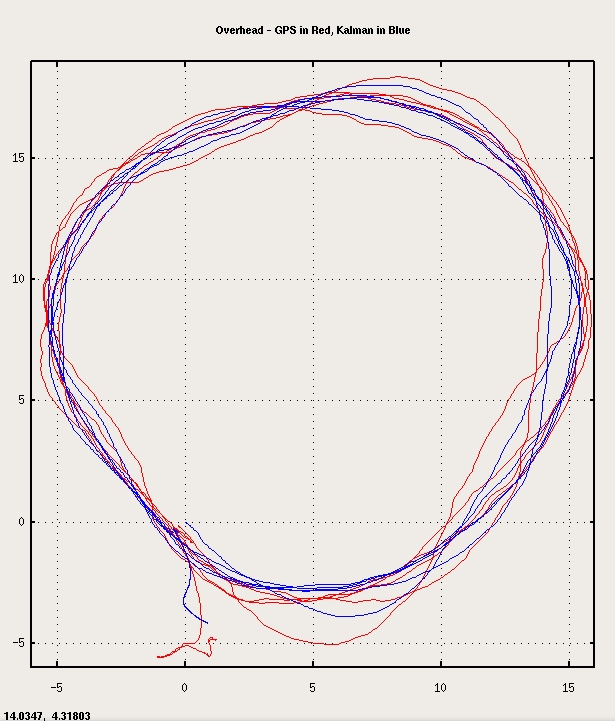
spu/data/20080815/auto4/overhead.jpg
