orbswarm/orbswarm-svn/spu/data/20080817/synchrocircle/overhead.jpg

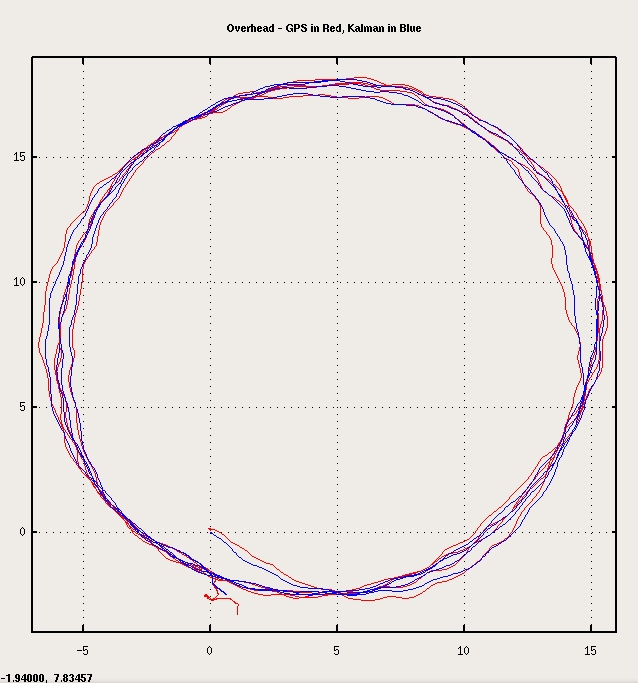
spu/data/20080817/synchrocircle/overhead.jpg
