orbswarm/orbswarm-svn/spu/data/20080826/circle1/overhead.jpg

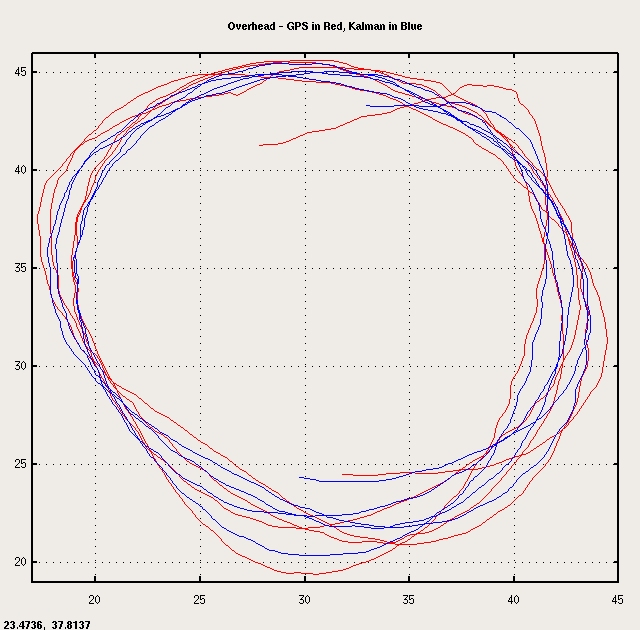
spu/data/20080826/circle1/overhead.jpg
