orbswarm/orbswarm-svn/Illuminator/RevABOM/OrbIlluminatorBOM.xls

Orb Illuminator | BOM
Electronic Parts |  |  |  |  |  | For
 |  |  |  |  |  | 4 boards
Item | Quantity | Reference | Part Desc. | Source | Source P/N | Order | Price ea. | Tot. Price | Notes
1 | 1 | C1 | CAP, CER, 0.1uF, 25V, 1206 | Digikey | PCC104BCT-ND | 10 | $0.040 | $0.396
2 | 1 | C2 | CAP TANT 10UF 35V 20% SMD | Digikey | 718-1046-1-ND | 4 | $0.440 | $1.760
3 | 1 | C3 | CAP TANT 100UF 16V 10% SMD | Digikey | 718-1057-1-ND | 4 | $0.700 | $2.800
4 | 5 | C4:C7,C10 | CAP 1UF 25V CERAMIC X7R 1206 | Digikey | PCC1893CT-ND | 20 | $0.250 | $5.000
5 | 2 | C8,C9 | CAP CERAMIC 18PF 50V NP0 1206 | Digikey | 399-1195-1-ND | 10 | $0.171 | $1.710
6 | 6 | D1:D6 | RED LED 1300MCD 30DEG 660NM | SuperBrightLEDs | RL5-R1330 | 24 | $0.490 | $11.760
7 | 6 | D7:D12 | GRN LED 7500MCD 32DEG 525NM | SuperBrightLEDs | RL5-G7532 | 24 | $0.390 | $9.360
8 | 6 | D13:D18 | BLU LED 4600MCD 30DEG 472NM | SuperBrightLEDs | RL5-B4630 | 24 | $0.660 | $15.840
9 | 4 | J1,J2 | 2-POS PCB TERM. BLOCK 5MM GRN | All Electronics | TER-202 | 16 | $0.450 | $7.200
10 | 3 | Q1:Q3 | MOSFET N-CH 30V 1.2A SOT-23 | Digikey | IRLML2803PBFCT-ND | 10 | $0.670 | $6.700
11 | 1 | R1 | RES 10K OHM 1/4W 5% 1206 SMD | Digikey | 311-10KECT-ND | 10 | $0.078 | $0.780
12 | 2 | R2,R4 | RES 270 OHM 1/4W 5% 1206 SMD | Digikey | 311-270ERCT-ND | 10 | $0.078 | $0.780 | For 12v supply
13 | 1 | R3 | RES 560 OHM 1/2W 5% 2010 SMD | Digikey | 541-560WCT-ND | 4 | $0.120 | $0.480 | For 24v supply
14 | 4 | R5,R7,R8,R10 | RES 82 OHM 1/4W 5% 1206 SMD | Digikey | 541-82ECT-ND | 20 | $0.039 | $0.780 | For 12v supply
15 | 3 | R6,R9,R11 | RES 150 OHM 1/4W 5% 1206 SMD | Digikey | 541-150ECT-ND | 20 | $0.039 | $0.780 | For 24v supply
16 | 1 | SW1 | SWITCH TACT 160GF H=3.4MM SMT | Digikey | EG2530CT-ND | 4 | $0.810 | $3.240 | Optional
17 | 1 | U1 | IC MCU AVR 2K FLASH 20SOIC | Digikey | ATTINY2313-20SU-ND | 4 | $2.150 | $8.600
18 | 1 | U2 | IC DUAL EIA-232 DRVR/RCVR 16SOIC | Digikey | 296-6936-5-ND | 4 | $0.900 | $3.600
19 | 1 | U3 | IC VOLT REG 5V 100MA SOT-89 | Digikey | 296-11118-1-ND | 4 | $0.480 | $1.920
20 | 1 | Y1 | CRYSTAL 7.3728MHZ 18PF FUND SMD | Digikey | 535-9088-1-ND | 4 | $1.100 | $4.400
21 |  |  |  |  |  |  |  | $0.000
22 |  |  |  |  |  |  |  | $0.000
 |  |  |  |  |  |  |  | $0.000
*** |  |  |  |  |  |  |  | $0.000
 |  |  |  |  |  |  |  | $0.000
 |  |  |  |  |  | Section | Total: | $87.886
 |  |  |  |  |  | Section | Total: | $0.000
