orbswarm/orbswarm-svn/pcb/SoundModule/rev2/BOM.xls

Item | RefDes | Description | Mfgr Part Number | Supplier | Catalog Number | Qty | Qty for 8 boards | Qty on-hand | Qty needed | Ordered 8-7-2007 | Still needed
1 | C1, C2 | 18 pF 50 V C0G Radial | RPE5C1H180J2K1Z03B | Digikey | 490-3698-ND | 2 | 16 | 9 | 7 | 8 | -1
2 | C3, C4, C7, C8, C9 | 1 uF 25 V X7R Radial | FK24X7R1E105K | Digikey | 445-2857-ND | 5 | 40 | 25 | 15 | 15 | 0
3 | C5 | 10 uF 35 V Mini Alum Elect | ECE-A1VKA100 | Digikey | P818-ND | 1 | 8 | 9 | -1 |  | -1
4 | C6 | 100 uF 16 V Mini Alum Elect | ECE-A1CKA101 | Digikey | P833-ND | 1 | 8 | 9 | -1 |  | -1
5 | R1, R2 | 1 K 1/4W |  |  |  | 2 | 16 | 16 | 0 |  | 0
6 | R3 | 10 K 1/4W |  | Digikey | 10KQBK-ND | 1 | 8 | 0 | 8 | 10 | -2
7 | IC2 | 78M05 | uA78M05CKCs | Digikey | 296-14000-5-ND (http://rocky.digikey.com/scripts/ProductInfo.dll?Site=US&V=296&M=UA78M05CKCS) | 1 | 8 | 0 | 8 | 8 | 0
8 | IC3 | RS232 Translator | ST232CN | Digikey | 497-3017-5-ND | 1 | 8 | 4 | 4 | 4 | 0
9 | IC4 | AVR ATTiny2313 | ATTINY2313-20PU | Digikey | ATTINY2313-20PU-ND | 1 | 8 | 9 | -1 |  | -1
10 | X1, X2, X3, X4, X5 | Screw Terminal Block |  | All Electronics | TER-202 | 5 | 40 | 40 | 0 |  | 0
11 | Q1 | 7.3728 MHz Crystal | HC49US7.3728MABJ-UB | Digikey | 300-8481-ND | 1 | 8 | 4 | 4 | 5 | -1
12 | SV1 | ISP Header |  | Digikey | A26525-40-ND | 0.125 | 1 | 0 | 1 | 1 | 0
13 | Other | 6-pin 2mm Header Receptacle for MP3 |  | Digikey | S5752-06-ND | 1 | 8 | 0 | 8 | 8 | 0
