orbswarm/orbswarm-svn/Illuminator/RevDBOM/OrbIlluminatorBOMRevD.xls

Orb Illuminator | BOM
Electronic Parts |  |  |  |  |  | RevD
 |  |  |  |  |  | Order
Item | Quantity | Reference | Part Desc. | Source | Source P/N | Order | Price ea. | Tot. Price | Notes
1 | 1 | C1 | CAP, CER, 0.1uF, 25V, 1206 | Digikey | PCC104BCT-ND | 20 | $0.040 | $0.792
2 | 1 | C2 | CAP TANT 10UF 35V 20% SMD | Digikey | 718-1046-1-ND | 12 | $0.440 | $5.280
3 | 1 | C3 | CAP TANT 100UF 16V 10% SMD | Digikey | 718-1057-1-ND | 12 | $0.700 | $8.400
4 | 5 | C4:C7,C10 | CAP 1UF 25V CERAMIC X7R 1206 | Digikey | PCC1893CT-ND | 70 | $0.250 | $17.500
5 | 2 | C8,C9 | CAP CERAMIC 18PF 50V NP0 1206 | Digikey | 399-1195-1-ND | 30 | $0.171 | $5.130
6 | 6 | D1:D6 | RED LED 8000MCD 30DEG 660NM | SuperBrightLEDs | RL5-R8030 | 72 | $0.540 | $38.880
7 | 6 | D7:D12 | GRN LED 7500MCD 32DEG 525NM | SuperBrightLEDs | RL5-G7532 | 72 | $0.490 | $35.280
8 | 6 | D13:D18 | BLU LED 4600MCD 30DEG 472NM | SuperBrightLEDs | RL5-B4630 | 72 | $0.660 | $47.520
9 | 1 | D19 | DIODE SCHOTTKY 50V 3A SMB | Digikey | B350B-FDICT-ND | 12 | $1.170 | $14.040
10 | 1 | D20 | LED GREEN CLEAR 1206 SMD | Digikey | 160-1169-1-ND | 12 | $0.070 | $0.840
11 | 2 | J1,J2 | CONN TERM BLOCK 2.54MM 4POS | Digikey | 277-1275-ND | 24 | $1.960 | $47.040 | Smaller Part 9/07
12 | 3 | Q1:Q3 | MOSFET N-CH 30V 1.2A SOT-23 | Digikey | IRLML2803PBFCT-ND | 40 | $0.670 | $26.800
13 | 1 | R1 | RES 10K OHM 1/4W 5% 1206 SMD | Digikey | 311-10KECT-ND | 20 | $0.078 | $1.560
14 | 2 | R2,R4 | RES 270 OHM 1/4W 5% 1206 SMD | Digikey | 311-270ERCT-ND | 0 | $0.078 | $0.000 | For 12v supply
15 | 1 | R3 | RES 560 OHM 1/2W 5% 2010 SMD | Digikey | 541-560WCT-ND | 20 | $0.120 | $2.400 | For 24v supply
16 | 4 | R5,R7,R8,R10 | RES 82 OHM 1/4W 5% 1206 SMD | Digikey | 541-82ECT-ND | 0 | $0.039 | $0.000 | For 12v supply
17 | 3 | R6,R9,R11 | RES 150 OHM 1/4W 5% 1206 SMD | Digikey | 541-150ECT-ND | 40 | $0.039 | $1.560 | For 24v supply
18 | 1 | R12 | RES 220 OHM 1/4W 5% 1206 SMD | Digikey | P220ECT-ND | 20 | $0.094 | $1.880
19 | 1 | SW1 | SWITCH TACT 160GF H=3.4MM SMT | Digikey | EG2530CT-ND | 0 | $0.810 | $0.000 | Optional
20 | 1 | U1 | IC AVR MCU 8K 16MHZ 5V 32TQFP | Digikey | ATMEGA8-16AU-ND | 12 | $3.550 | $42.600
21 | 1 | U2 | IC DUAL EIA-232 DRVR/RCVR 16SOIC | Digikey | 296-6936-5-ND | 12 | $0.900 | $10.800
22 | 1 | U3 | IC VOLT REG 5V 100MA SOT-89 | Digikey | 296-11118-1-ND | 12 | $0.480 | $5.760
23 | 1 | Y1 | CRYSTAL 7.3728MHZ 18PF FUND SMD | Digikey | 300-8538-1-ND | 12 | $0.780 | $9.360
 |  |  |  |  |  |  |  | $0.000
 |  |  |  |  |  |  |  | $0.000
 |  |  |  |  |  |  |  | $0.000
 |  |  |  |  |  |  |  | $0.000
 |  |  |  |  |  |  |  | $0.000
 |  |  | Note: Ceramic caps and resistors are |  |  | Section | Total: | $323.422
 |  |  | sold in quantities of ten. Odd quantities
 |  |  | have been rounded up to the nearest
 |  |  | ten.
 |  |  |  |  |  | Section | Total: | $0.000
