orbswarm/orbswarm-svn/mechanical/v0_7/battery_module.SLDASM

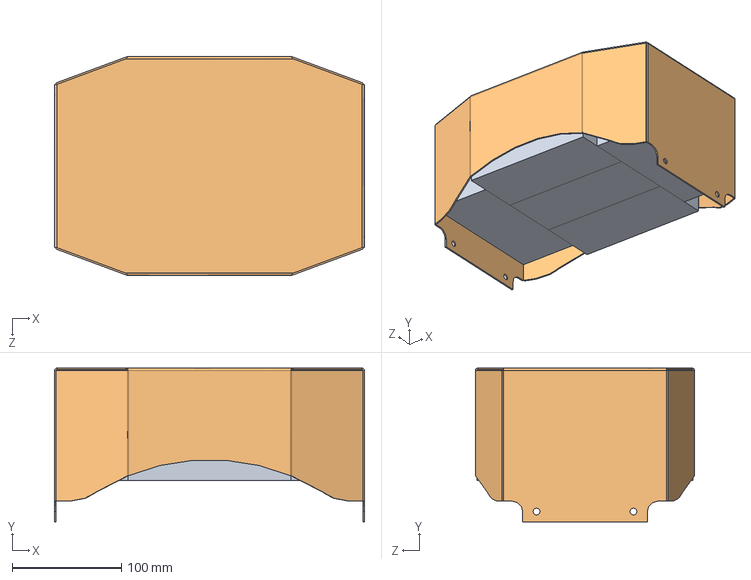
[picture p60: CAD file, 2007-09-23]
mechanical/v0_7/battery_module.SLDASM
284.4 x 141.2 x 201.2 mm
battery x 5
battery_tray
