orbswarm/orbswarm-svn/mechanical/v0_7/integrated.SLDASM

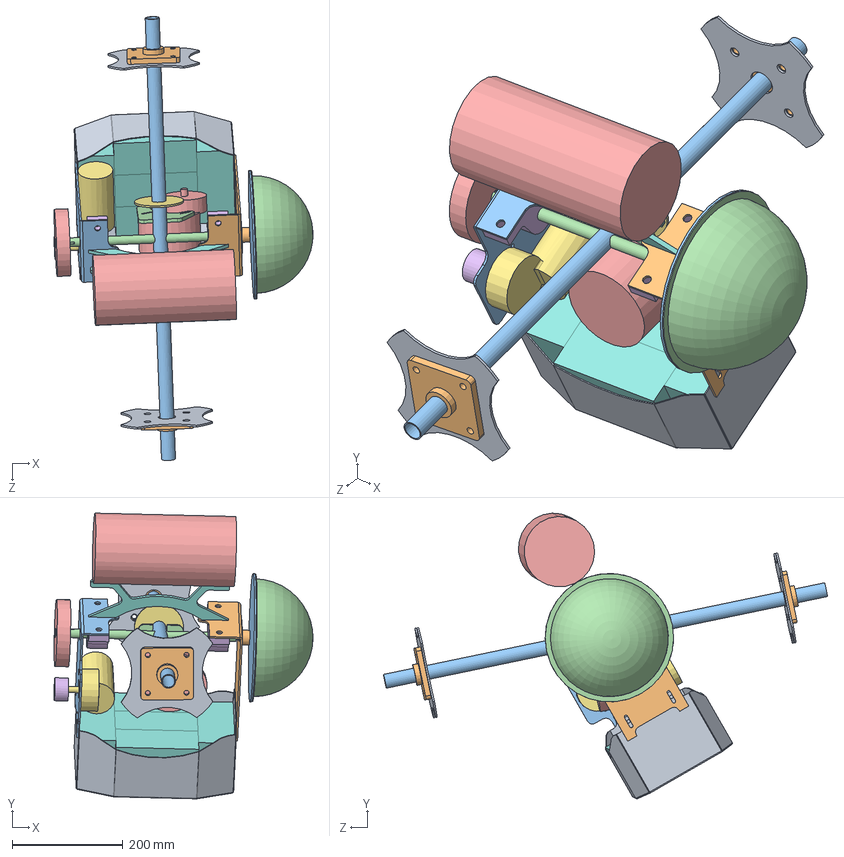
[picture p61: CAD file, 2007-09-23]
mechanical/v0_7/integrated.SLDASM
466.9 x 515.2 x 800.5 mm
hub_flange x 2
flange_bearing x 2
axle
small_axle
drive_motor
pillow_block x 2
steering_motor
battery x 5
battery_tray
tray_bracket
steering_bracket
motor_plate
tsprock_40
tsprock_10
cog_27t
crossmember
pot_holder
potentiometer
acetal
dome
speakertube
