orbswarm/orbswarm-svn/mechanical/v0_7/frame1.SLDASM

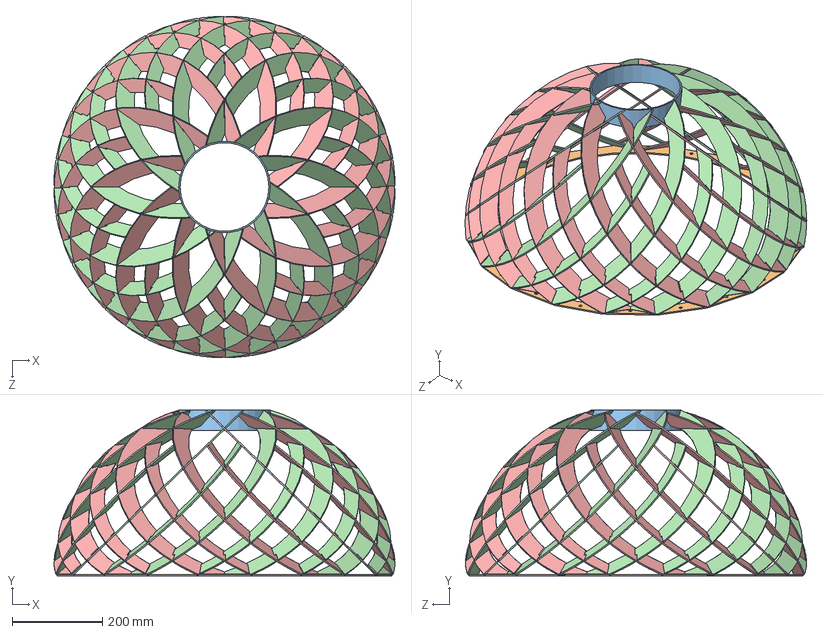
[picture p62: CAD file, 2007-08-01]
mechanical/v0_7/frame1.SLDASM
756.3 x 367.2 x 756.4 mm
rib
waist
axle_frame
inside_rib x 20
outside_rib x 20
