orbswarm/orbswarm-svn/mechanical/v0_7/whole_shell.SLDASM

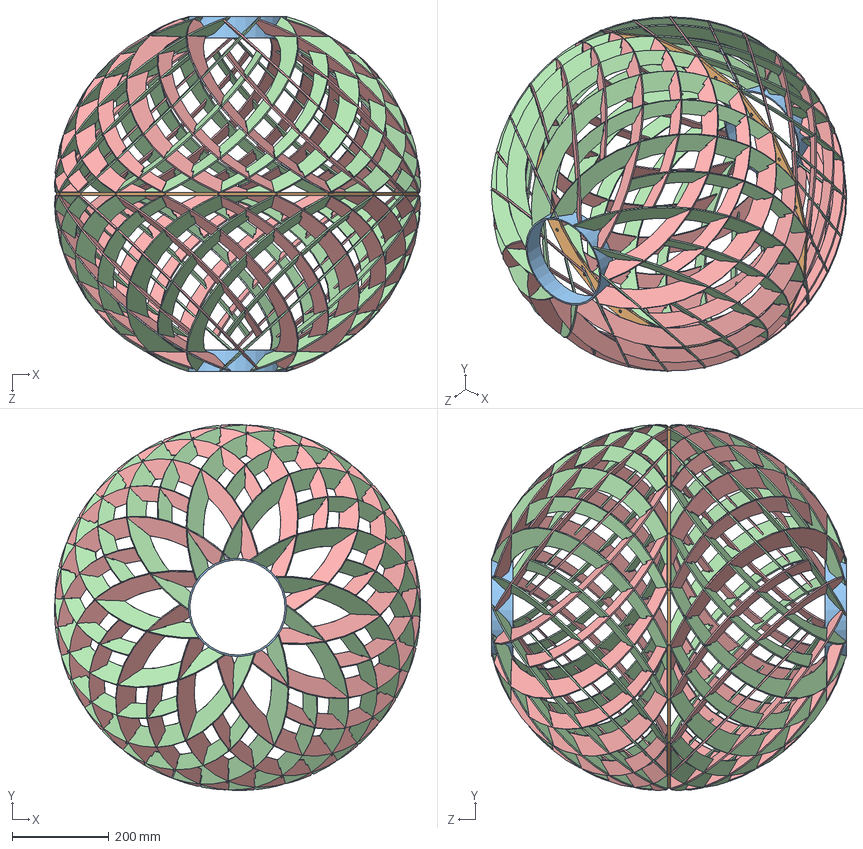
[picture p63: CAD file, 2007-08-01]
mechanical/v0_7/whole_shell.SLDASM
757.2 x 757.3 x 734.4 mm
rib x 2
waist x 2
axle_frame x 2
inside_rib x 40
outside_rib x 40
