orbswarm/orbswarm-svn/mechanical/v0_7/battery.SLDASM

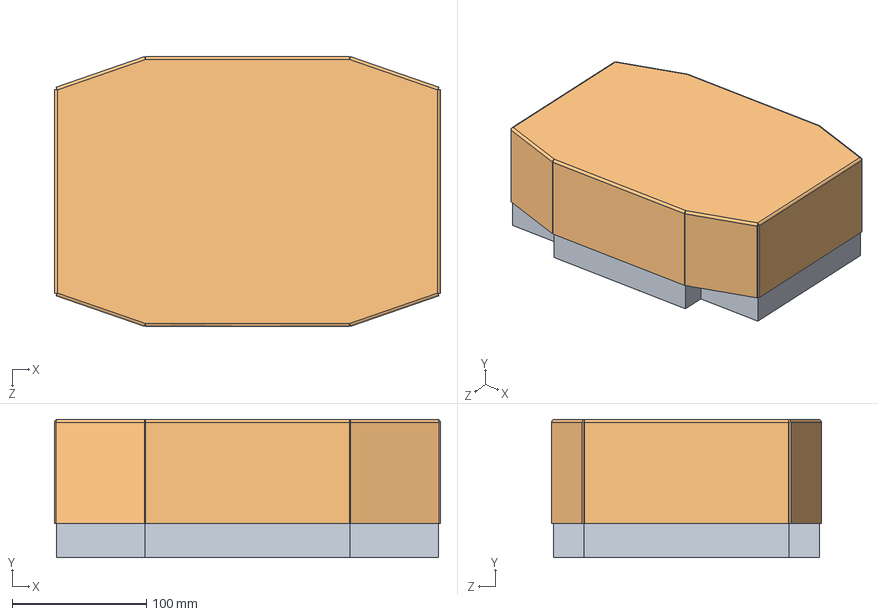
[picture p64: CAD file, 2007-08-01]
mechanical/v0_7/battery.SLDASM
287.5 x 103.1 x 201.2 mm
battery x 5
battery_tray
