orbswarm/orbswarm-svn/architecture/orb_architecture_20080122.dxf

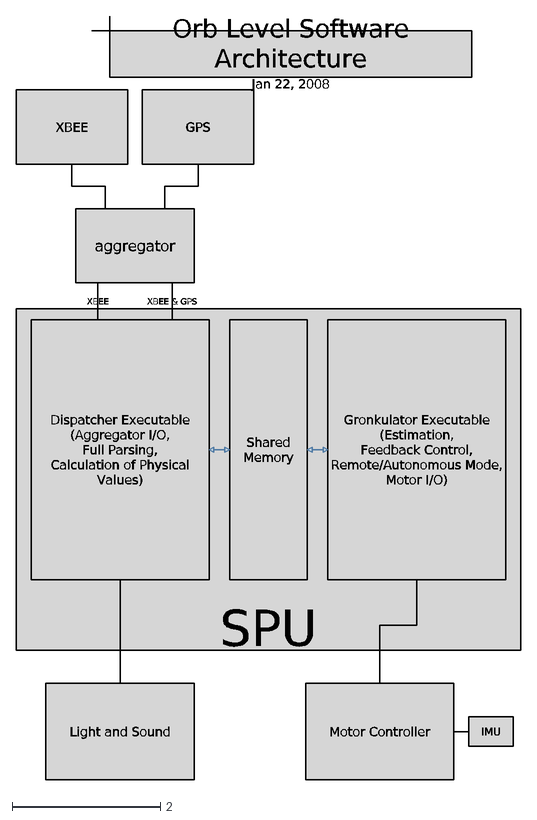
[picture p65: CAD file, 2008-01-23]
architecture/orb_architecture_20080122.dxf
SPU
aggregator
XBEE
GPS
IMU
Light and Sound
Orb Level Software Architecture Jan 22, 2008
XBEE & GPS
Dispatcher Executable (Aggregator I/O, Full Parsing, Calculation of Physical Values)
Motor Controller
Shared Memory
Gronkulator Executable (Estimation, Feedback Control, Remote/Autonomous Mode, Motor I/O)
