orbswarm/orbswarm-svn/mechanical/SPUbulkhead/SPUbulkhead.dxf

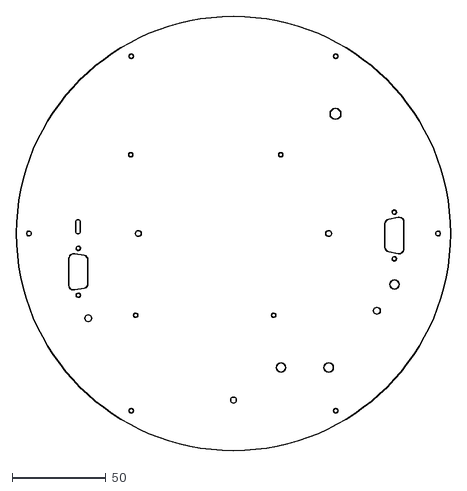
[picture p66: CAD file, 2007-08-16]
mechanical/SPUbulkhead/SPUbulkhead.dxf
231.8 x 231.8
