orbswarm/orbswarm-svn/mechanical/v0_7/battery_tray.SLDPRT

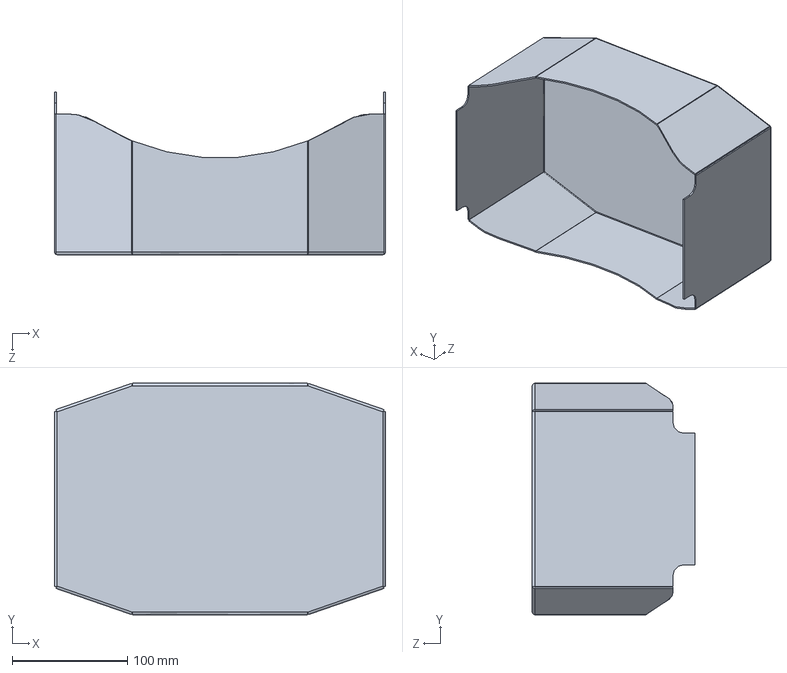
[picture p67: CAD file, 2007-09-23]
mechanical/v0_7/battery_tray.SLDPRT
287.5 x 201.2 x 141.2 mm
