orbswarm/orbswarm-svn/mechanical/SPUbulkhead/SPUbulkhead18x24.dxf

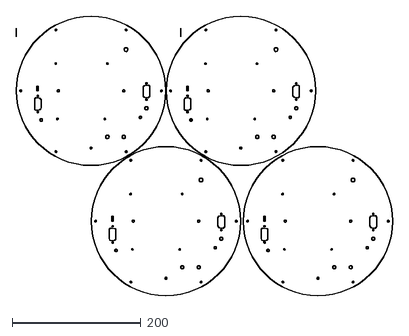
[picture p68: CAD file, 2007-08-16]
mechanical/SPUbulkhead/SPUbulkhead18x24.dxf
584.2 x 434.3
