orbswarm/orbswarm-svn/mechanical/v0_7/battery_tray_20070810.DXF

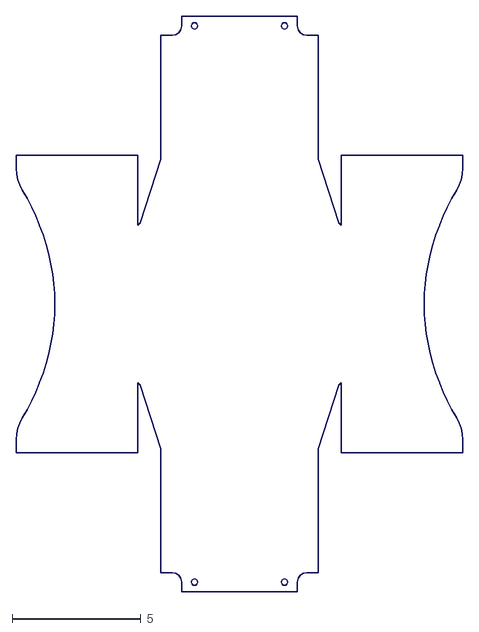
[picture p69: CAD file, 2007-09-23]
mechanical/v0_7/battery_tray_20070810.DXF
17.4 x 22.4
