orbswarm/orbswarm-svn/mechanical/v0_7/steering_bracket.SLDPRT

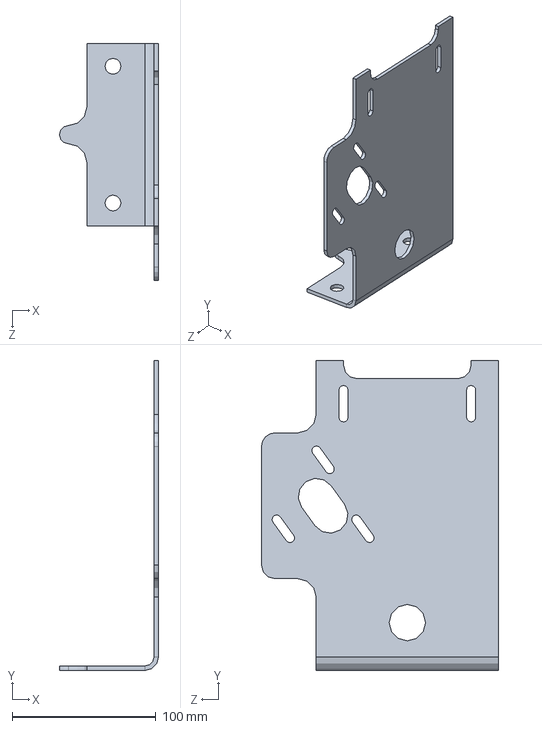
[picture p70: CAD file, 2007-08-07]
mechanical/v0_7/steering_bracket.SLDPRT
69.1 x 215.9 x 165.1 mm
