orbswarm/orbswarm-svn/mechanical/v0_7/speakertube.SLDPRT

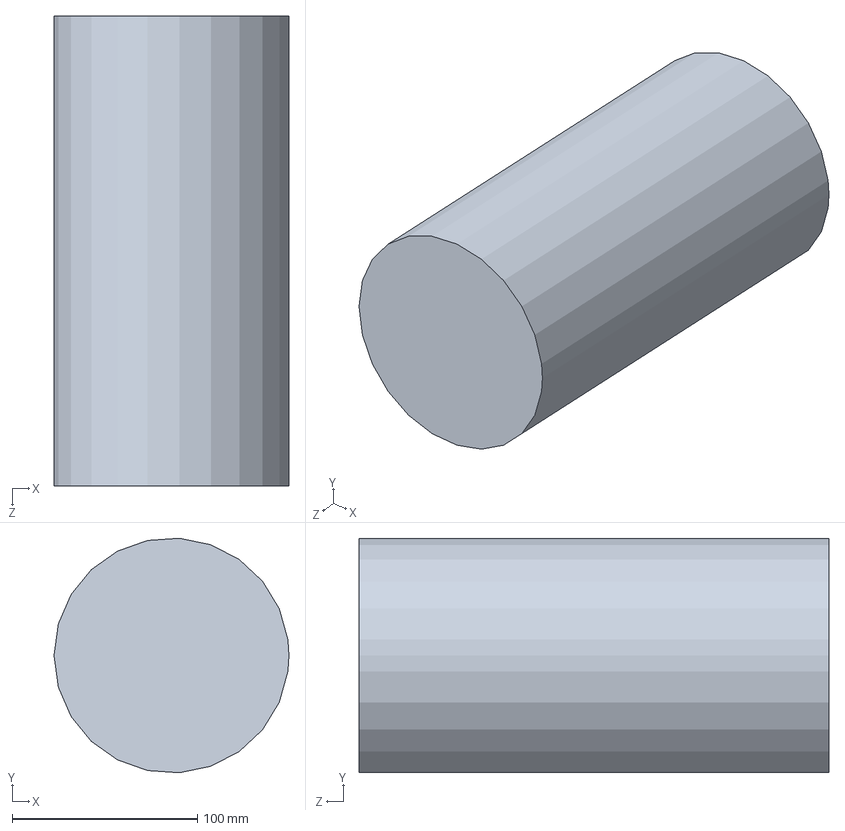
[picture p71: CAD file, 2007-08-07]
mechanical/v0_7/speakertube.SLDPRT
127.0 x 126.7 x 254.0 mm
