orbswarm/orbswarm-svn/mechanical/v0_7/tray_bracket.SLDPRT

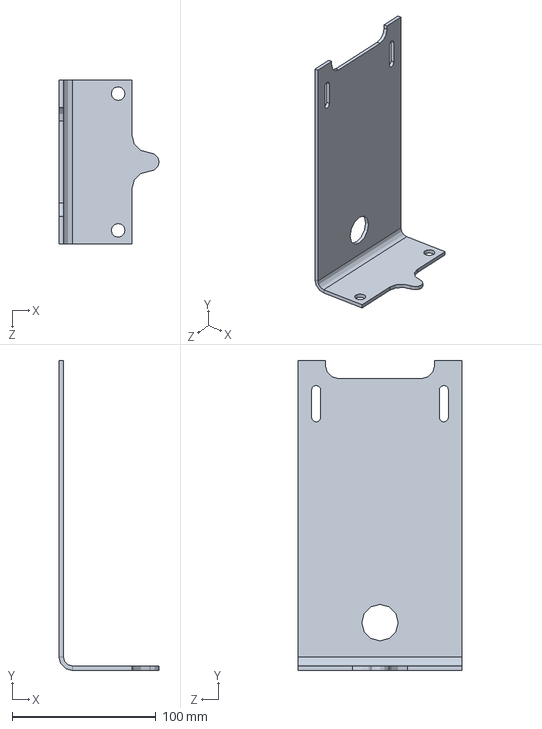
[picture p72: CAD file, 2007-08-07]
mechanical/v0_7/tray_bracket.SLDPRT
69.8 x 215.9 x 114.3 mm
