orbswarm/orbswarm-svn/mechanical/v0_7/small_axle.SLDPRT

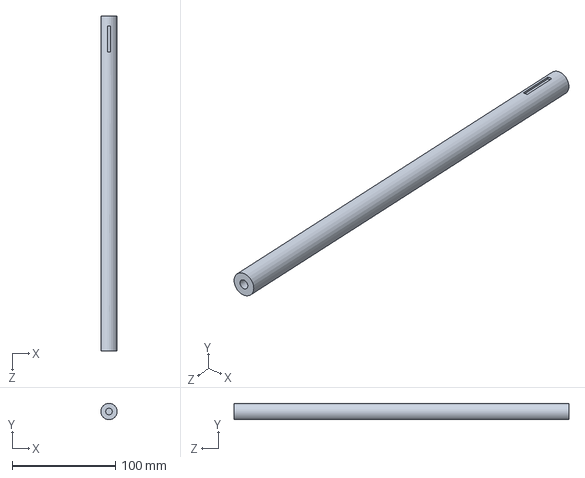
[picture p73: CAD file, 2007-08-07]
mechanical/v0_7/small_axle.SLDPRT
15.9 x 15.9 x 323.9 mm
