orbswarm/orbswarm-svn/mechanical/v0_7/shaft_extension.SLDPRT

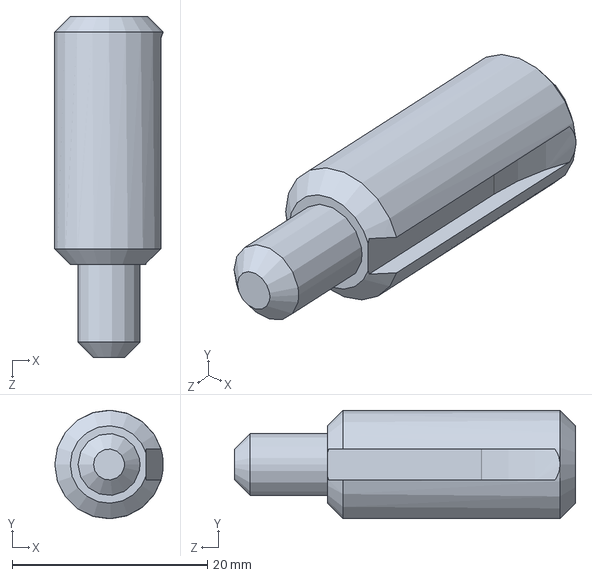
[picture p74: CAD file, 2007-08-07]
mechanical/v0_7/shaft_extension.SLDPRT
11.1 x 11.1 x 34.9 mm
