orbswarm/orbswarm-svn/mechanical/v0_7/motor_plate2.DXF

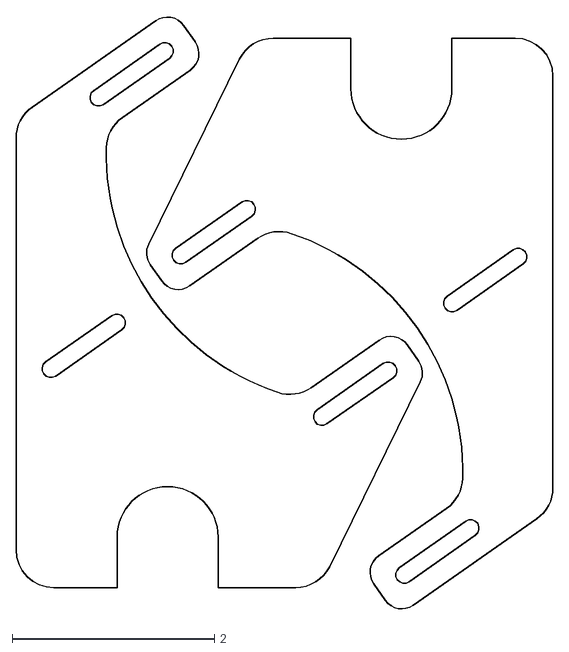
[picture p75: CAD file, 2007-08-02]
mechanical/v0_7/motor_plate2.DXF
5.31 x 5.89
