orbswarm/orbswarm-svn/mechanical/v0_7/potentiometer.SLDPRT

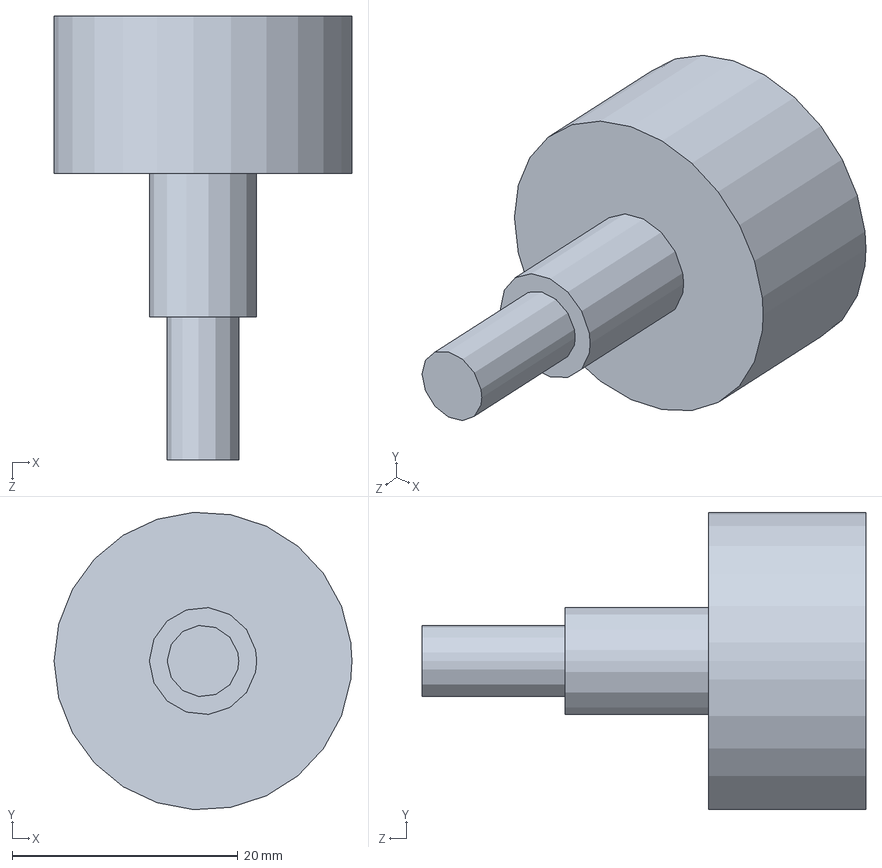
[picture p76: CAD file, 2007-08-02]
mechanical/v0_7/potentiometer.SLDPRT
26.4 x 26.4 x 39.4 mm
