orbswarm/orbswarm-svn/mechanical/v0_7/motor_plate.SLDPRT

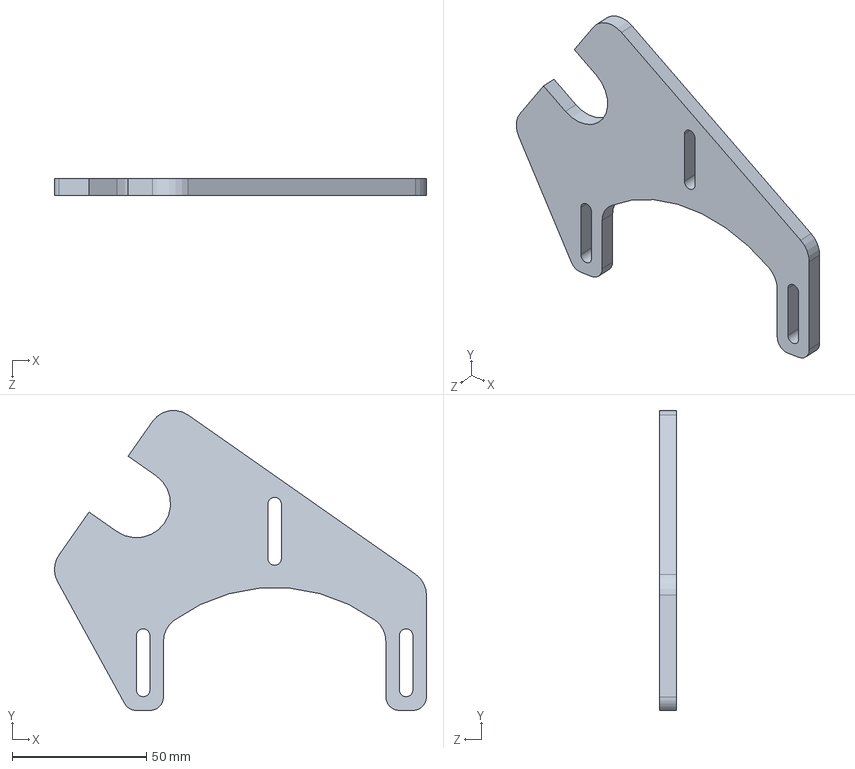
[picture p77: CAD file, 2007-08-02]
mechanical/v0_7/motor_plate.SLDPRT
138.6 x 111.8 x 6.35 mm
