orbswarm/orbswarm-svn/mechanical/v0_7/axle.SLDPRT

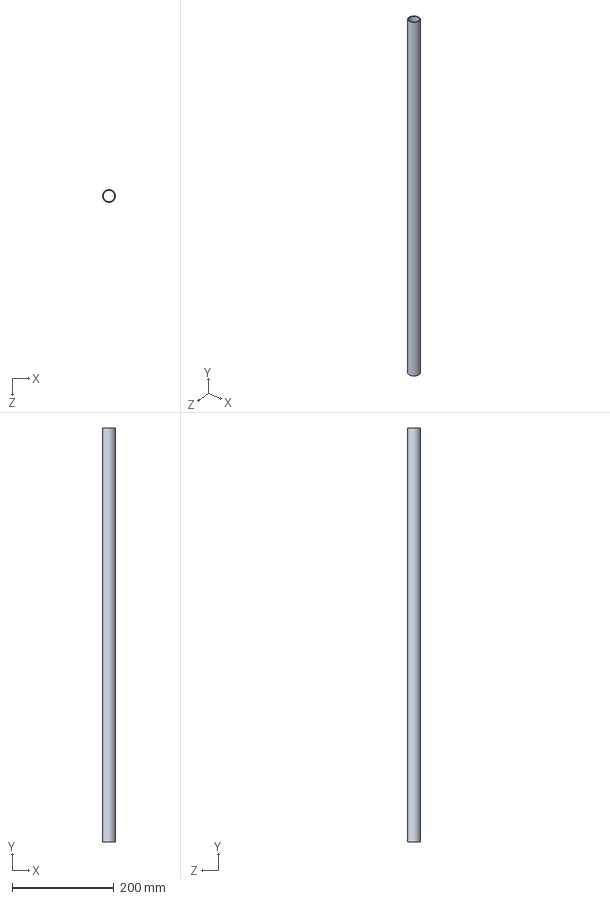
[picture p78: CAD file, 2007-08-01]
mechanical/v0_7/axle.SLDPRT
25.4 x 812.8 x 25.4 mm
