orbswarm/orbswarm-svn/mechanical/v0_7/battery_tray_20070726.DXF

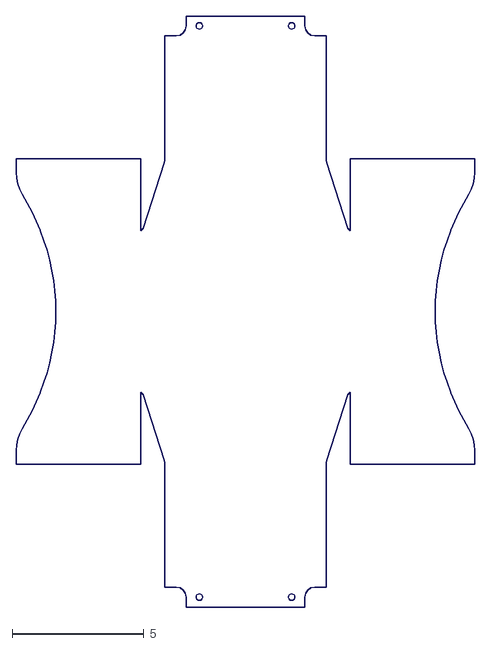
[picture p79: CAD file, 2007-08-01]
mechanical/v0_7/battery_tray_20070726.DXF
17.4 x 22.4
