orbswarm/orbswarm-svn/mechanical/v0_7/steering_motor.sldprt

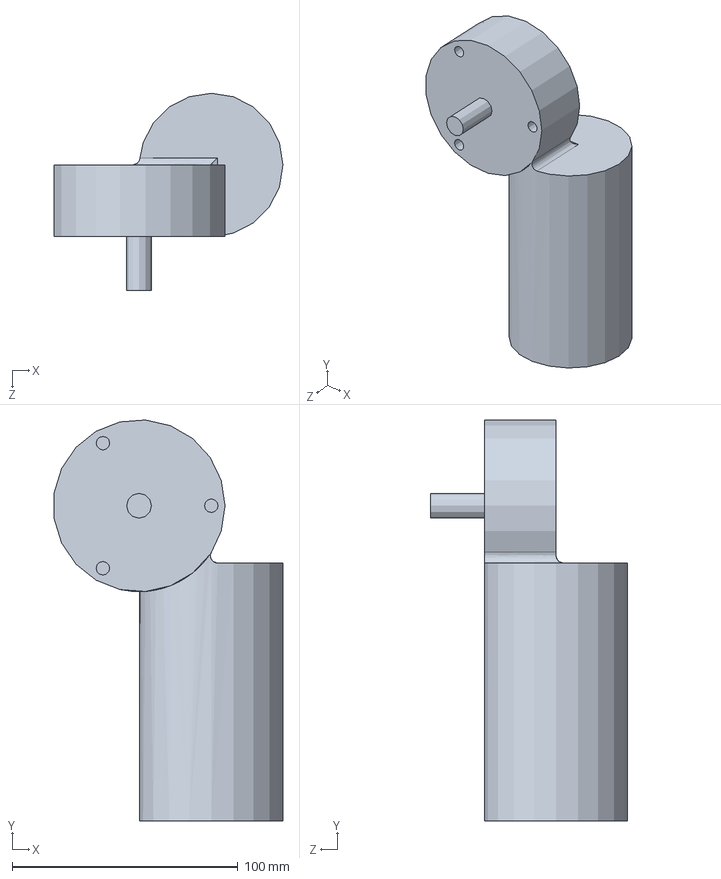
[picture p80: CAD file, 2007-08-01]
mechanical/v0_7/steering_motor.sldprt
101.4 x 177.7 x 87.5 mm
