orbswarm/orbswarm-svn/mechanical/v0_7/battery_tray_new.DXF

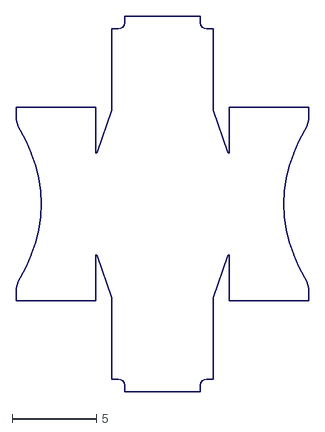
[picture p81: CAD file, 2007-08-01]
mechanical/v0_7/battery_tray_new.DXF
17.4 x 22.3
