orbswarm/orbswarm-svn/mechanical/v0_7/drive_motor.SLDPRT

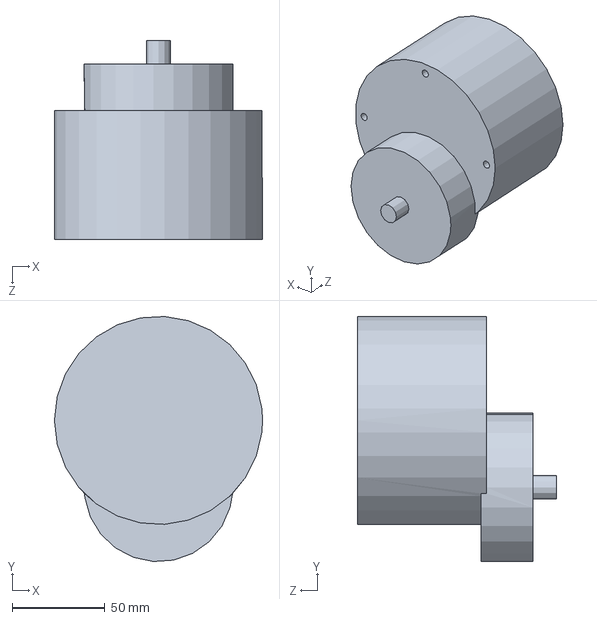
[picture p82: CAD file, 2007-08-01]
mechanical/v0_7/drive_motor.SLDPRT
112.0 x 131.8 x 107.2 mm
