orbswarm/orbswarm-svn/mechanical/v0_7/rib_sheet.DXF

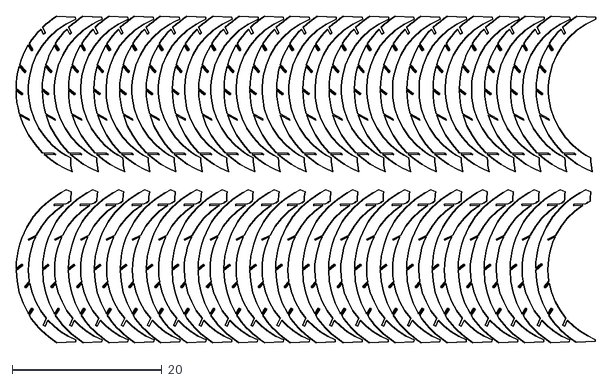
[picture p83: CAD file, 2007-08-01]
mechanical/v0_7/rib_sheet.DXF
77.5 x 43.6
