orbswarm/orbswarm-svn/mechanical/v0_7/outside_rib.sldprt

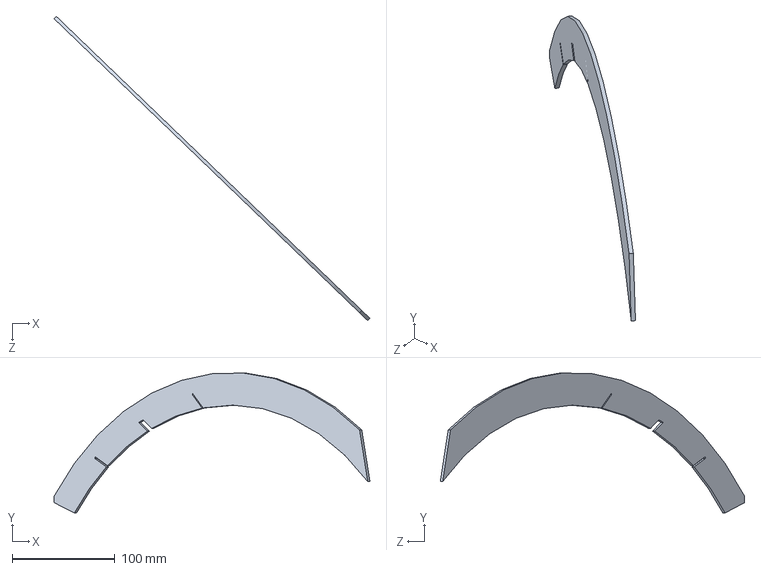
[picture p84: CAD file, 2007-08-01]
mechanical/v0_7/outside_rib.sldprt
308.2 x 136.4 x 296.9 mm
