orbswarm/orbswarm-svn/mechanical/v0_7/hub_flange.SLDPRT

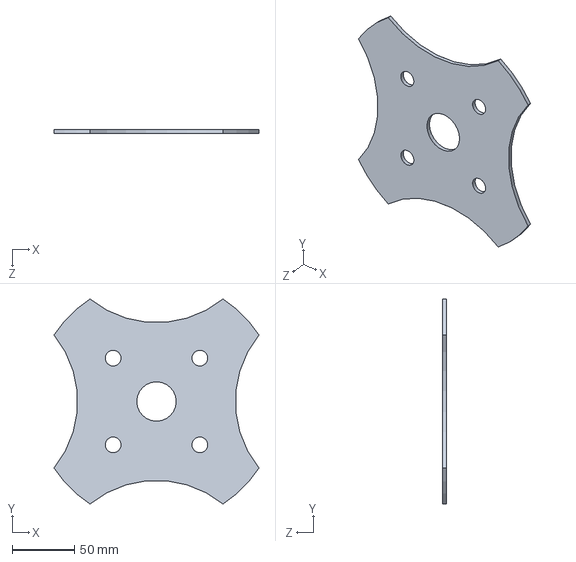
[picture p85: CAD file, 2007-08-01]
mechanical/v0_7/hub_flange.SLDPRT
165.1 x 165.1 x 3.17 mm
