orbswarm/orbswarm-svn/mechanical/v0_7/equator_sheet.DXF

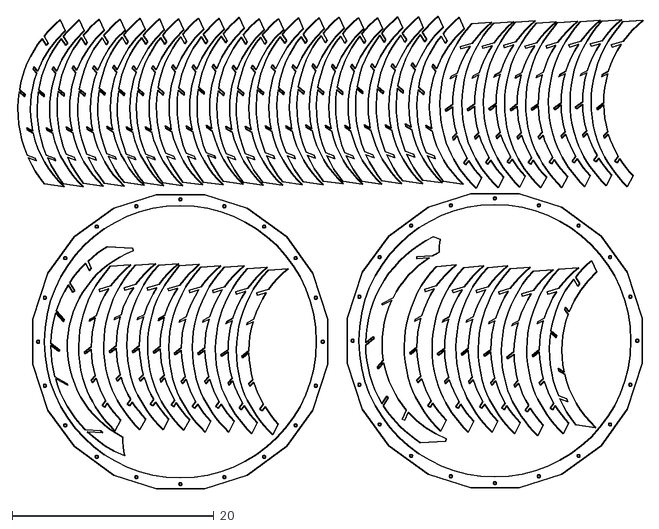
[picture p86: CAD file, 2007-08-01]
mechanical/v0_7/equator_sheet.DXF
62.2 x 46.9
