orbswarm/orbswarm-svn/(list of files, cad)

Other CAD files:
mechanical/v0_7/pot_holder.SLDPRT
mechanical/v0_7/crossmember.SLDPRT
mechanical/v0_7/acetal.SLDPRT
mechanical/v0_7/pillow_block.SLDPRT
mechanical/v0_7/dome.SLDPRT
mechanical/v0_7/sphere_outline.SLDPRT
mechanical/v0_7/bh_front.SLDPRT
mechanical/v0_7/inside_rib.sldprt
mechanical/v0_7/intersect2.SLDPRT
mechanical/v0_7/tsprock_40.SLDPRT
mechanical/v0_7/tsprock_10.SLDPRT
mechanical/v0_7/bh_back.SLDPRT
mechanical/v0_7/waist_one.sldprt
mechanical/v0_7/linkage_test.SLDPRT
mechanical/v0_7/rib.SLDPRT
mechanical/v0_7/bh_pod.SLDPRT
mechanical/v0_7/waist.SLDPRT
mechanical/v0_7/motor_bearing.SLDPRT
mechanical/v0_7/flange_bearing.SLDPRT
mechanical/v0_7/axle_frame.SLDPRT
mechanical/v0_7/waist_two.sldprt
mechanical/v0_7/cog_27t.SLDPRT
mechanical/v0_7/wedge.SLDPRT
mechanical/v0_7/driveshaft.SLDPRT
mechanical/v0_7/battery.SLDPRT
mechanical/v0_7/battery_tray.DXF
mechanical/v0_7/battery_tray.SLDDRW
mechanical/v0_7/crossmember.DXF
mechanical/v0_7/crossmember.SLDDRW
mechanical/v0_7/equator_sheet.SLDDRW
mechanical/v0_7/hub_flange.DXF
mechanical/v0_7/hub_flange.SLDDRW
mechanical/v0_7/inside_rib.DXF
mechanical/v0_7/inside_rib.SLDDRW
mechanical/v0_7/motor_plate.DXF
mechanical/v0_7/motor_plate.SLDDRW
mechanical/v0_7/motor_plate2.SLDDRW
mechanical/v0_7/outside_rib.DXF
mechanical/v0_7/outside_rib.SLDDRW
mechanical/v0_7/rib_sheet.SLDDRW
mechanical/v0_7/shaft_extension.SLDDRW
mechanical/v0_7/steering_bracket.DXF
mechanical/v0_7/steering_bracket.SLDDRW
mechanical/v0_7/steering_bracket_dim.SLDDRW
mechanical/v0_7/tray_bracket.DXF
mechanical/v0_7/tray_bracket.SLDDRW
mechanical/v0_7/tray_bracket_dim.SLDDRW
media/blender/litshell.blend
