orbswarm/orbswarm-svn/media/SWARMtalk/images/Maker-faire-kids.jpg

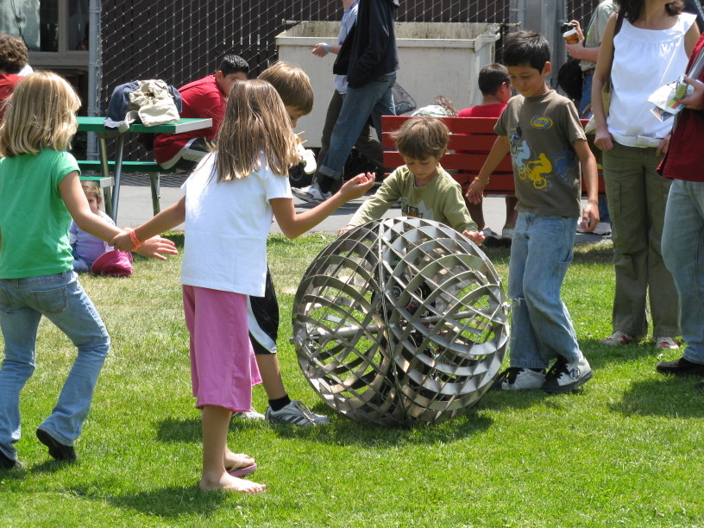
media/SWARMtalk/images/Maker-faire-kids.jpg
