orbswarm/orbswarm-svn/remote/assembly/annotated-back.jpg

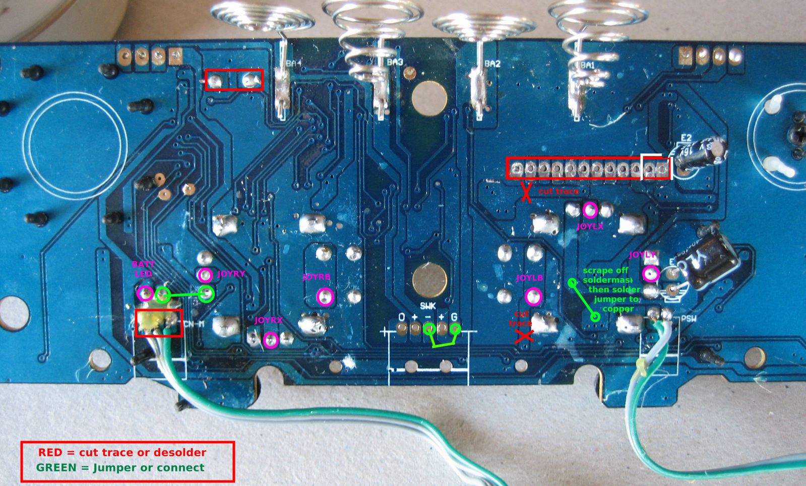
remote/assembly/annotated-back.jpg
