orbswarm/orbswarm-svn/remote/assembly/annotated-front.jpg

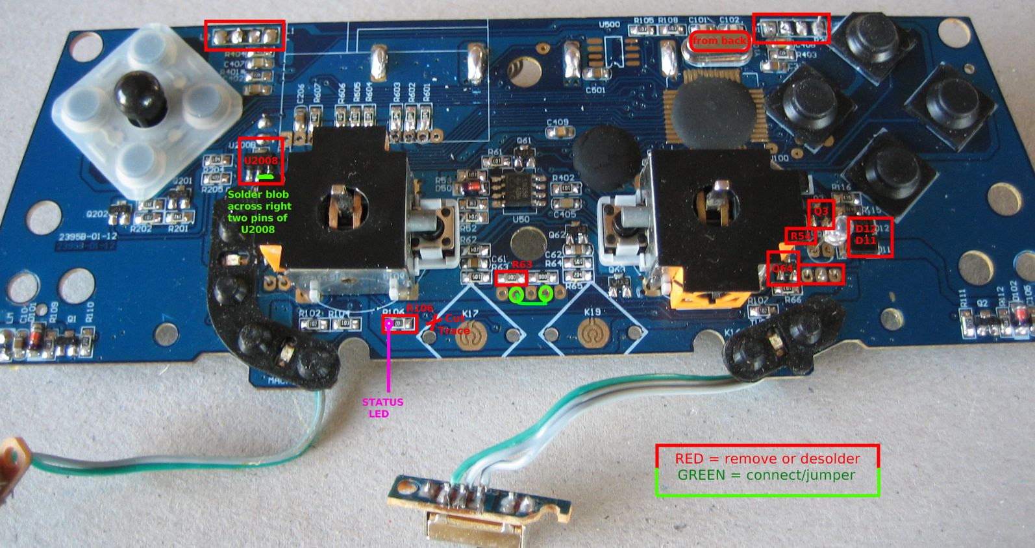
remote/assembly/annotated-front.jpg
