orbswarm/orbswarm-svn/remote/assembly/board_wires.JPG

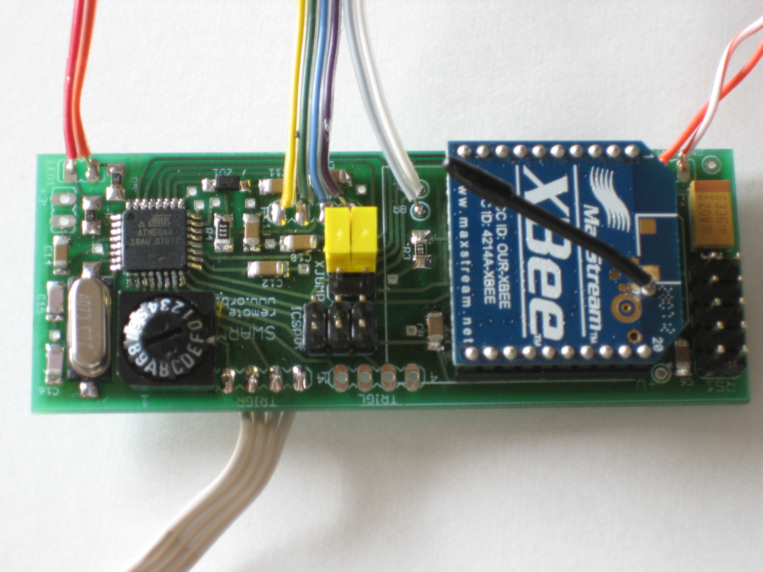
remote/assembly/board_wires.JPG
