orbswarm/orbswarm-svn/remote/assembly/underwires.jpg

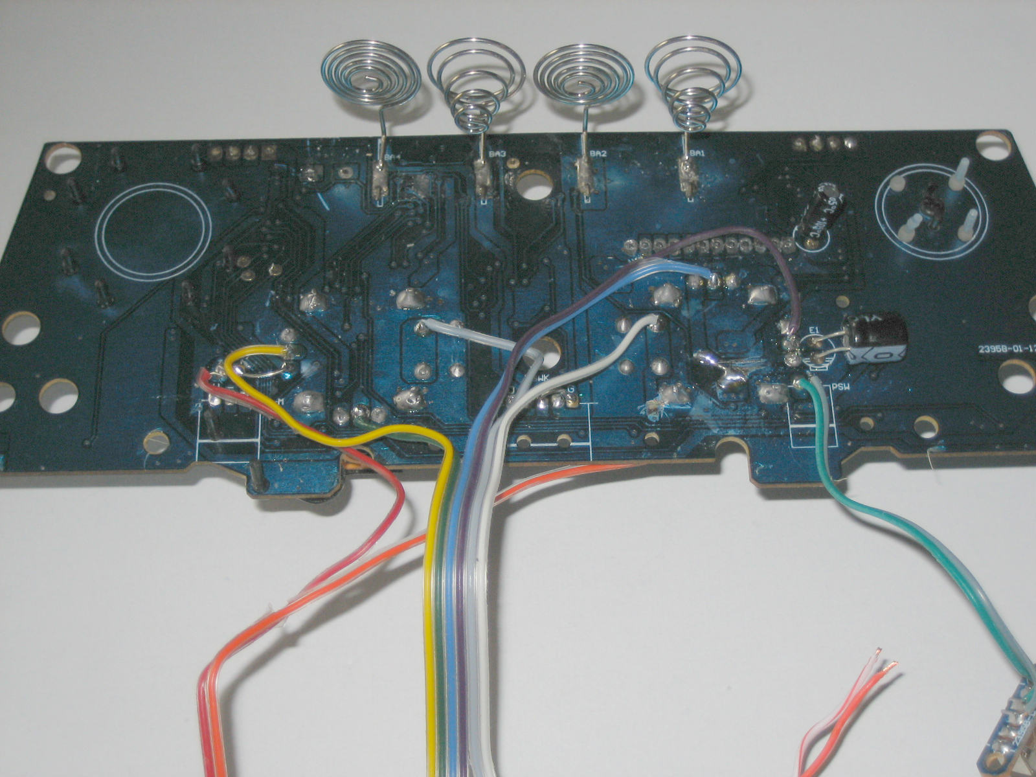
remote/assembly/underwires.jpg
