orbswarm/orbswarm-svn/mothernode/java/resources/test-results/19-oct-2008/swarmcon17614.png

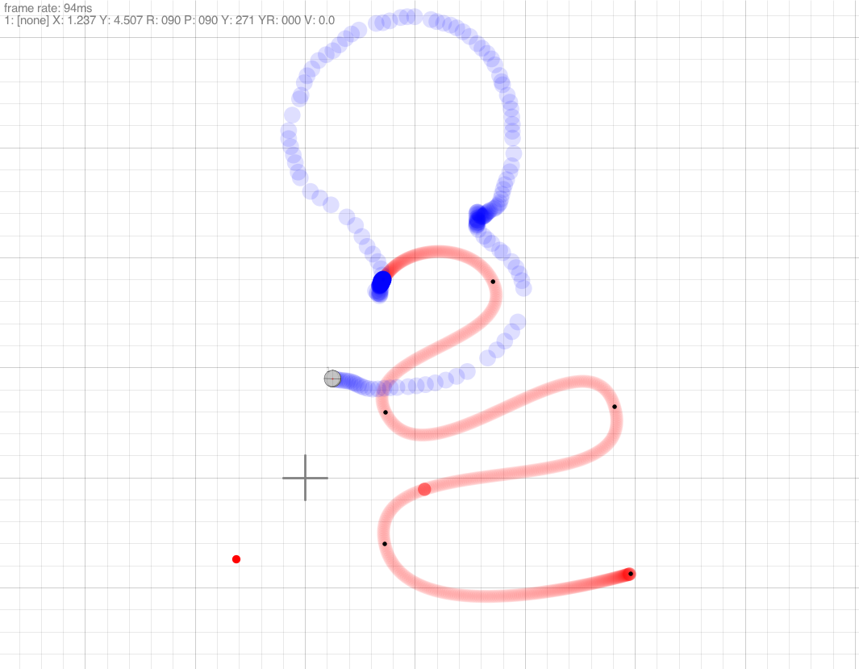
mothernode/java/resources/test-results/19-oct-2008/swarmcon17614.png
