orbswarm/orbswarm-svn/mothernode/java/resources/test-results/19-oct-2008/swarmcon35898.png

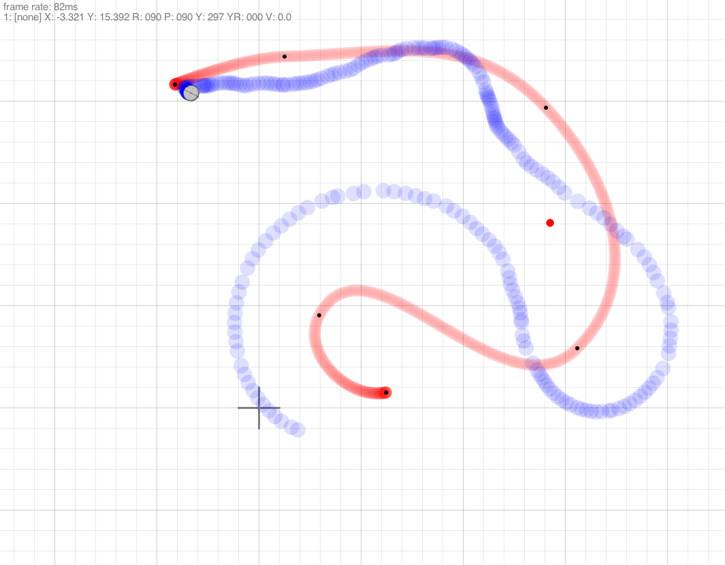
mothernode/java/resources/test-results/19-oct-2008/swarmcon35898.png
