orbswarm/orbswarm-svn/architecture/orb_architecture_20080122.pdf

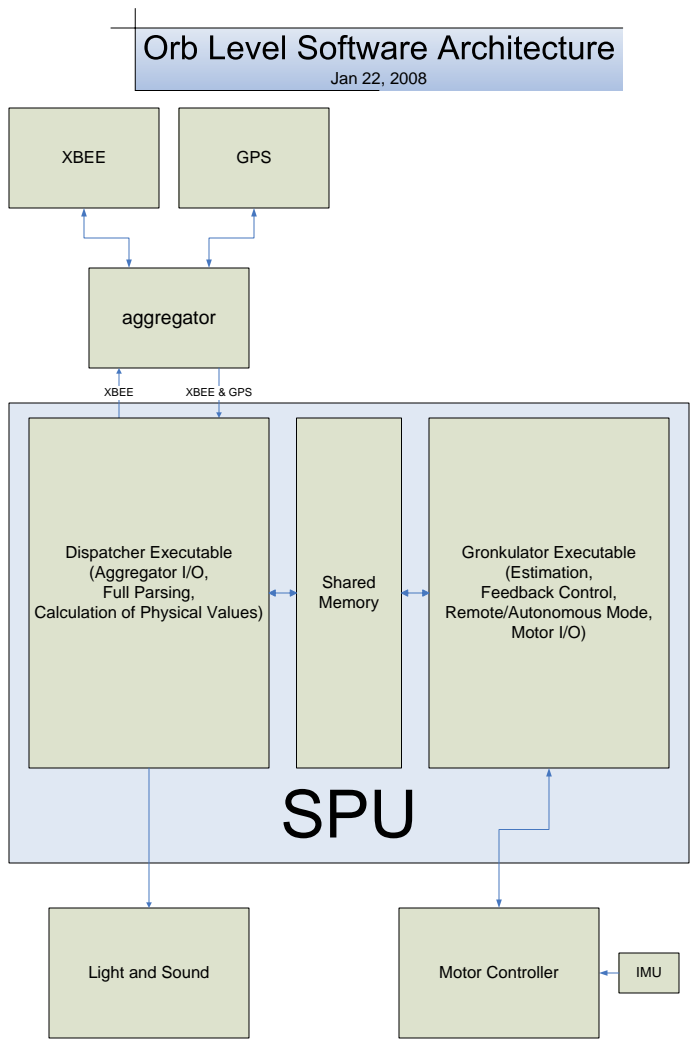
[picture p134: page 1]
aggregator; XBEE; GPS; Light and Sound; IMU; Jan 22, 2008; XBEE & GPS; Dispatcher Executable (Aggregator I/O, Full Parsing,; Motor Controller; Shared Memory; Motor I/O)

Gronkulator Executable
(Estimation,
Feedback Control,
Remote/Autonomous Mode,

Calculation of Physical Values)
