orbswarm/orbswarm-svn/pcb/remote/remote-schematic.pdf

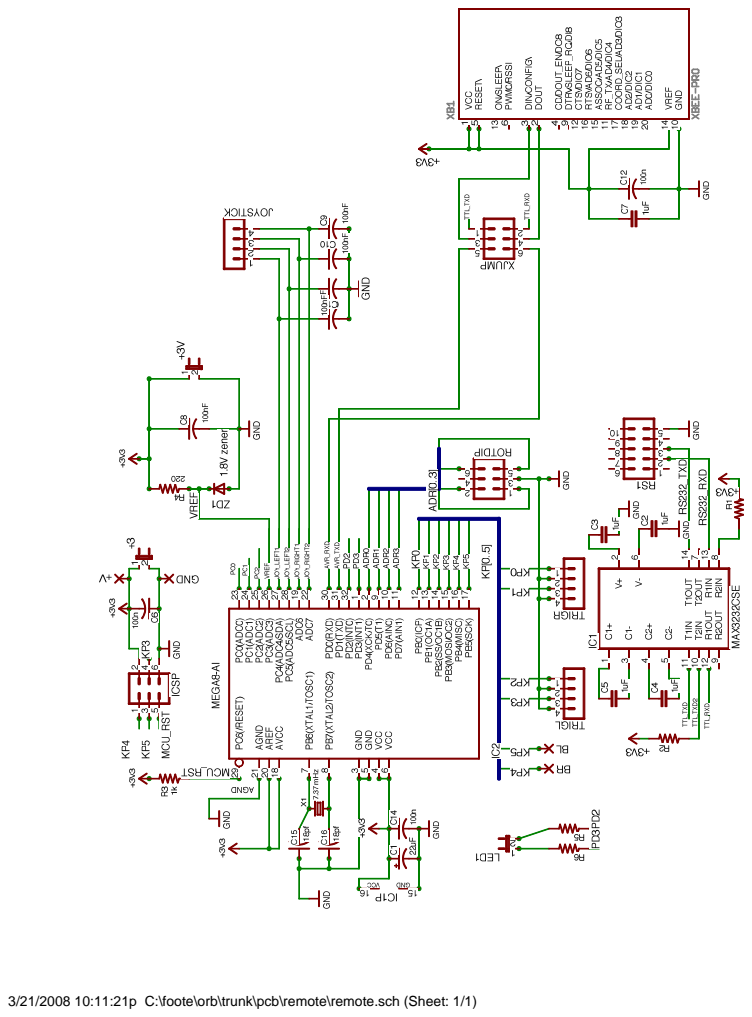
[picture p135: page 1]

3/21/2008 10:11:21p C:\foote\orb\trunk\pcb\remote\remote.sch (Sheet: 1/1)
