orbswarm/orbswarm-svn/mechanical/SPUbulkhead/SPUbulkhead.pdf

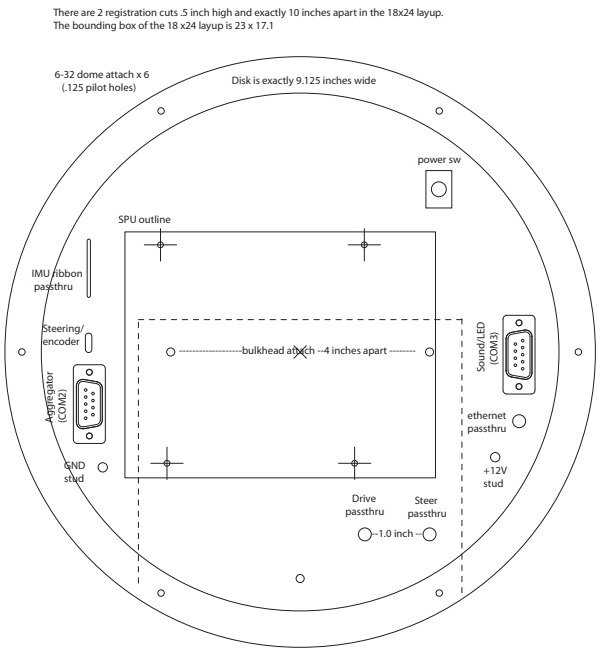
[picture p136: page 1]
6-32 dome attach x 6 (.125 pilot holes); gre; ator; Steer passthru; Drive passthru; ethernet passthru; SPU outline; GND stud; +12V stud; IMU ribbon passthru; Steering/ encoder; power sw; --1.0 inch --

There are 2 registration cuts .5 inch high and exactly 10 inches apart in the 18x24 layup.
The bounding box of the 18 x24 layup is 23 x 17.1

Disk is exactly 9.125 inches wide

-------------------bulkhead attach --4 inches apart --------
