orbswarm/orbswarm-svn/motorControl/prototype/MCU_Schematic.pdf

## 2x5 Header - Motor H-Bridge

## (SCK) PB5

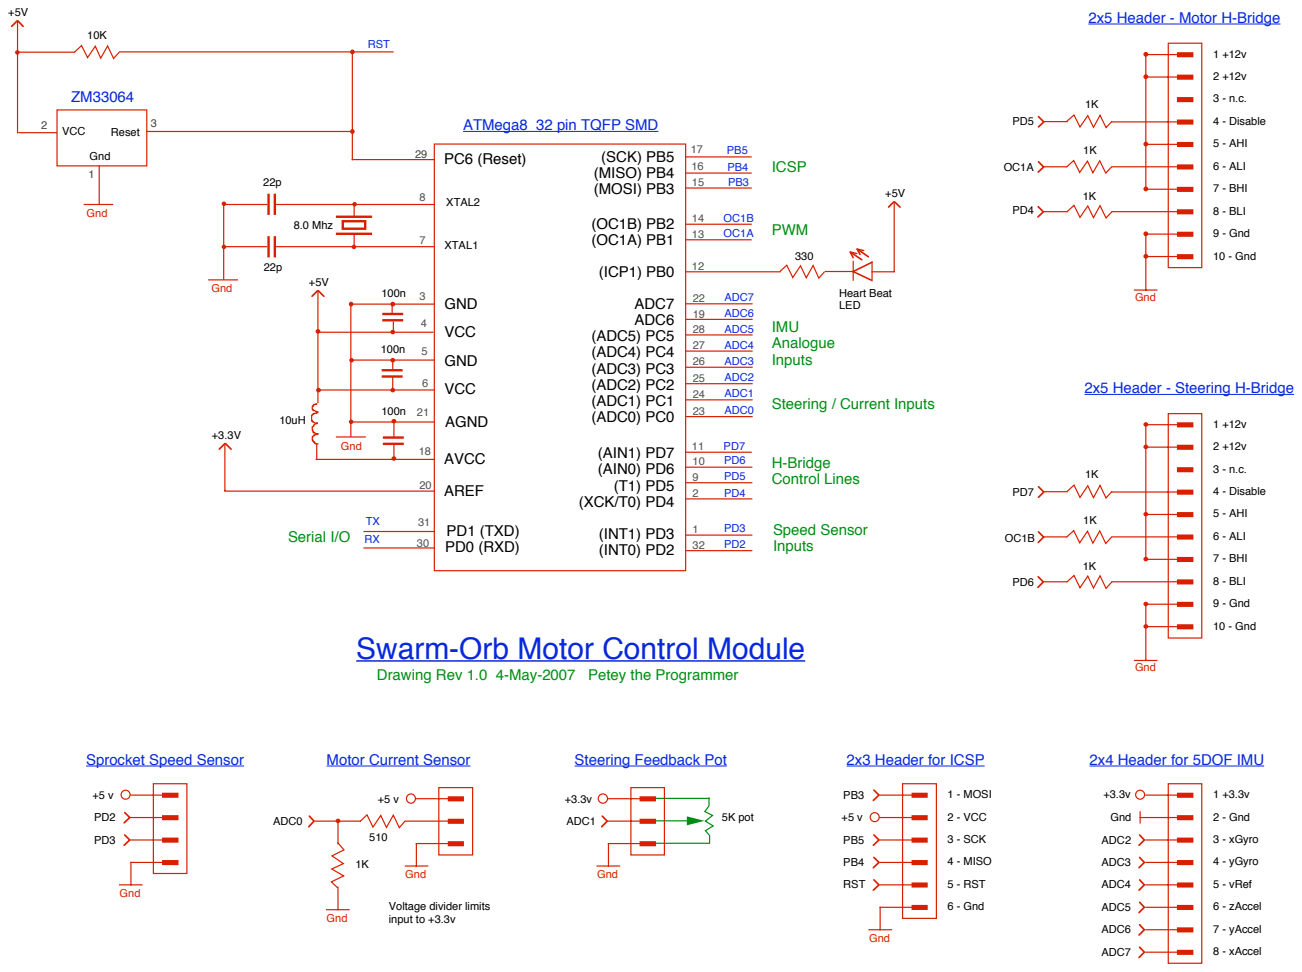
[picture p137: page 1]
4 - Disable; 5 - AHI; 6 - ALI; 7 - BHI; 8 - BLI; 9 - Gnd; 10 - Gnd; Gnd; 2 - Gnd; 3 - xGyro; 4 - yGyro; 5 - vRef; 6 - zAccel; 7 - yAccel; 8 - xAccel; ADC2; ADC3; ADC4; ADC5; ADC6; ADC7; 1 - MOSI; 2 - VCC; 3 - SCK; 4 - MISO; 5 - RST; 6 - Gnd; RST; ADC1; 5K pot; ADC0; (MISO) PB4 (MOSI) PB3; ADC7 ADC6 (ADC5) PC5 (ADC4) PC4 (ADC3) PC3 (ADC2) PC2 (ADC1) PC1 (ADC0) PC0; (AIN1) PD7 (AIN0) PD6 (T1) PD5 (XCK/T0) PD4; (INT1) PD3 (INT0) PD2; PC6 (Reset); AVCC; AREF; GND; VCC; 8.0 Mhz; XTAL2; XTAL1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

ATMega8 32 pin TQFP SMD

2x5 Header - Steering H-Bridge

Steering / Current Inputs

Swarm-Orb Motor Control Module

Drawing Rev 1.0 4-May-2007 Petey the Programmer

Sprocket Speed Sensor

Motor Current Sensor

Steering Feedback Pot

2x3 Header for ICSP

2x4 Header for 5DOF IMU

Voltage divider limits
input to +3.3v
