orbswarm/orbswarm-svn/pcb/power/OrbPower.pdf

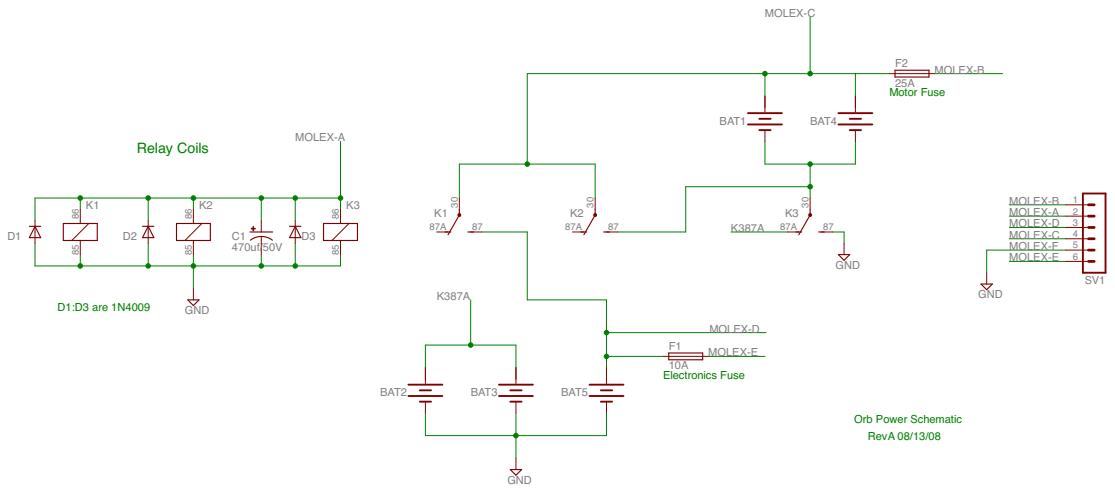
[picture p138: page 1]

Orb Power Schematic RevA 08/13/08
