orbswarm/orbswarm-svn/pcb/daughterboard/V2rev0/dboardv2sch.pdf

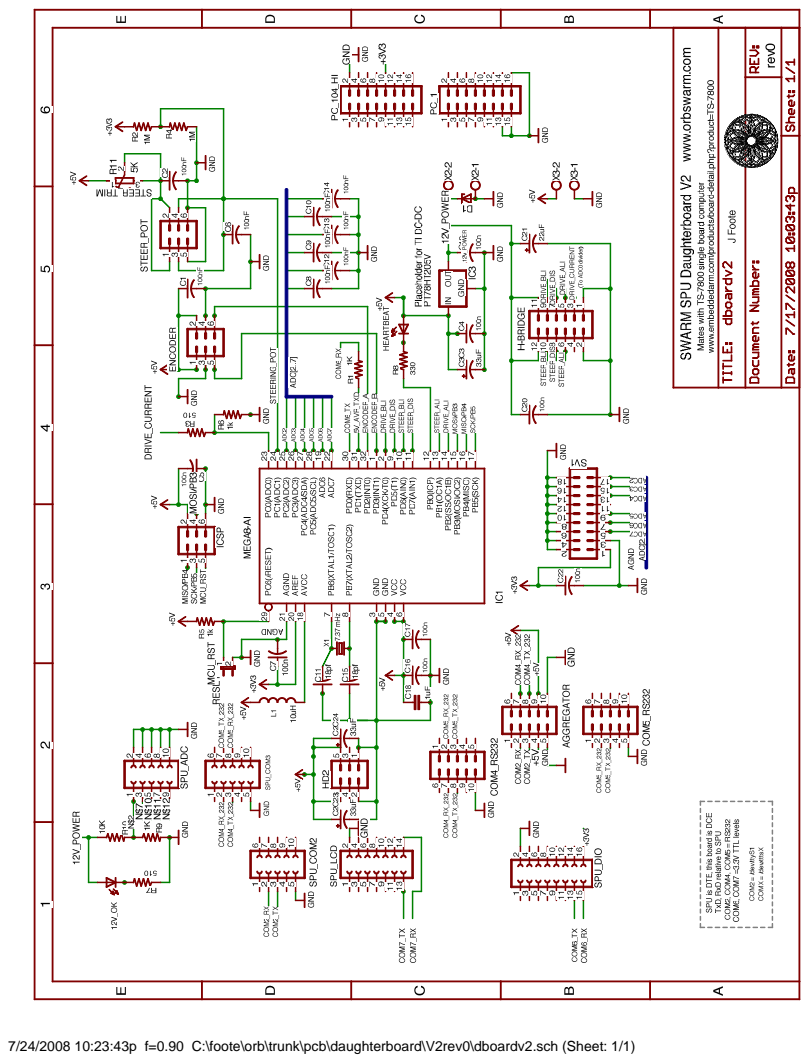
[picture p139: page 1]

7/24/2008 10:23:43p f=0.90 C:\foote\orb\trunk\pcb\daughterboard\V2rev0\dboardv2.sch (Sheet: 1/1)
