orbswarm/orbswarm-svn/pcb/SoundModule/rev2/SoundModule.pdf

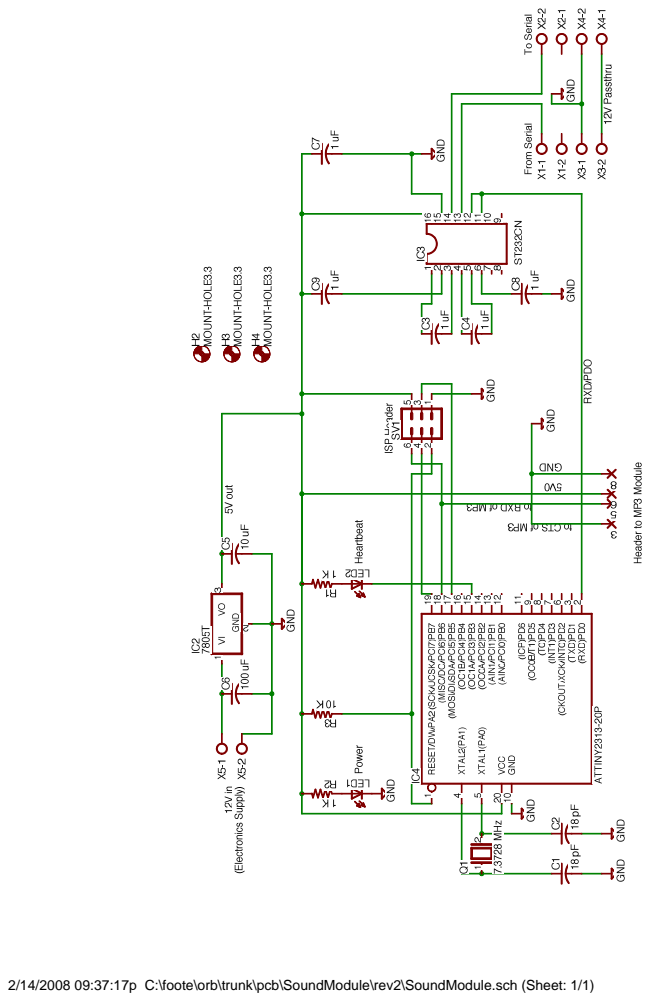
[picture p140: page 1]

2/14/2008 09:37:17p C:\foote\orb\trunk\pcb\SoundModule\rev2\SoundModule.sch (Sheet: 1/1)
