orbswarm/orbswarm-svn/mothernode/java/resources/documents/information_flow.pdf

XBEE | aggregator AVR | GPS
| Sunday, May 13, 2007

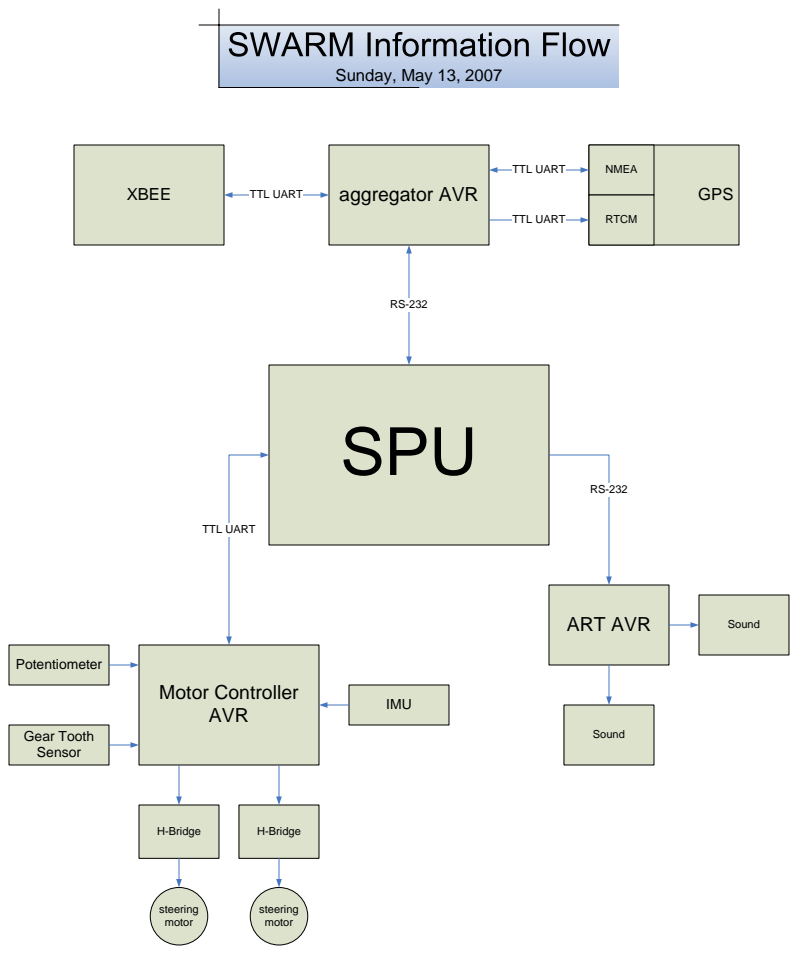
[picture p141: page 1]
NMEA; RTCM; Motor Controller AVR; TTL UART; H-Bridge; Potentiometer; Gear Tooth Sensor; IMU; steering motor; ART AVR; Sound
