orbswarm/orbswarm-svn/pcb/aggregator/agg-schematicpdf.pdf

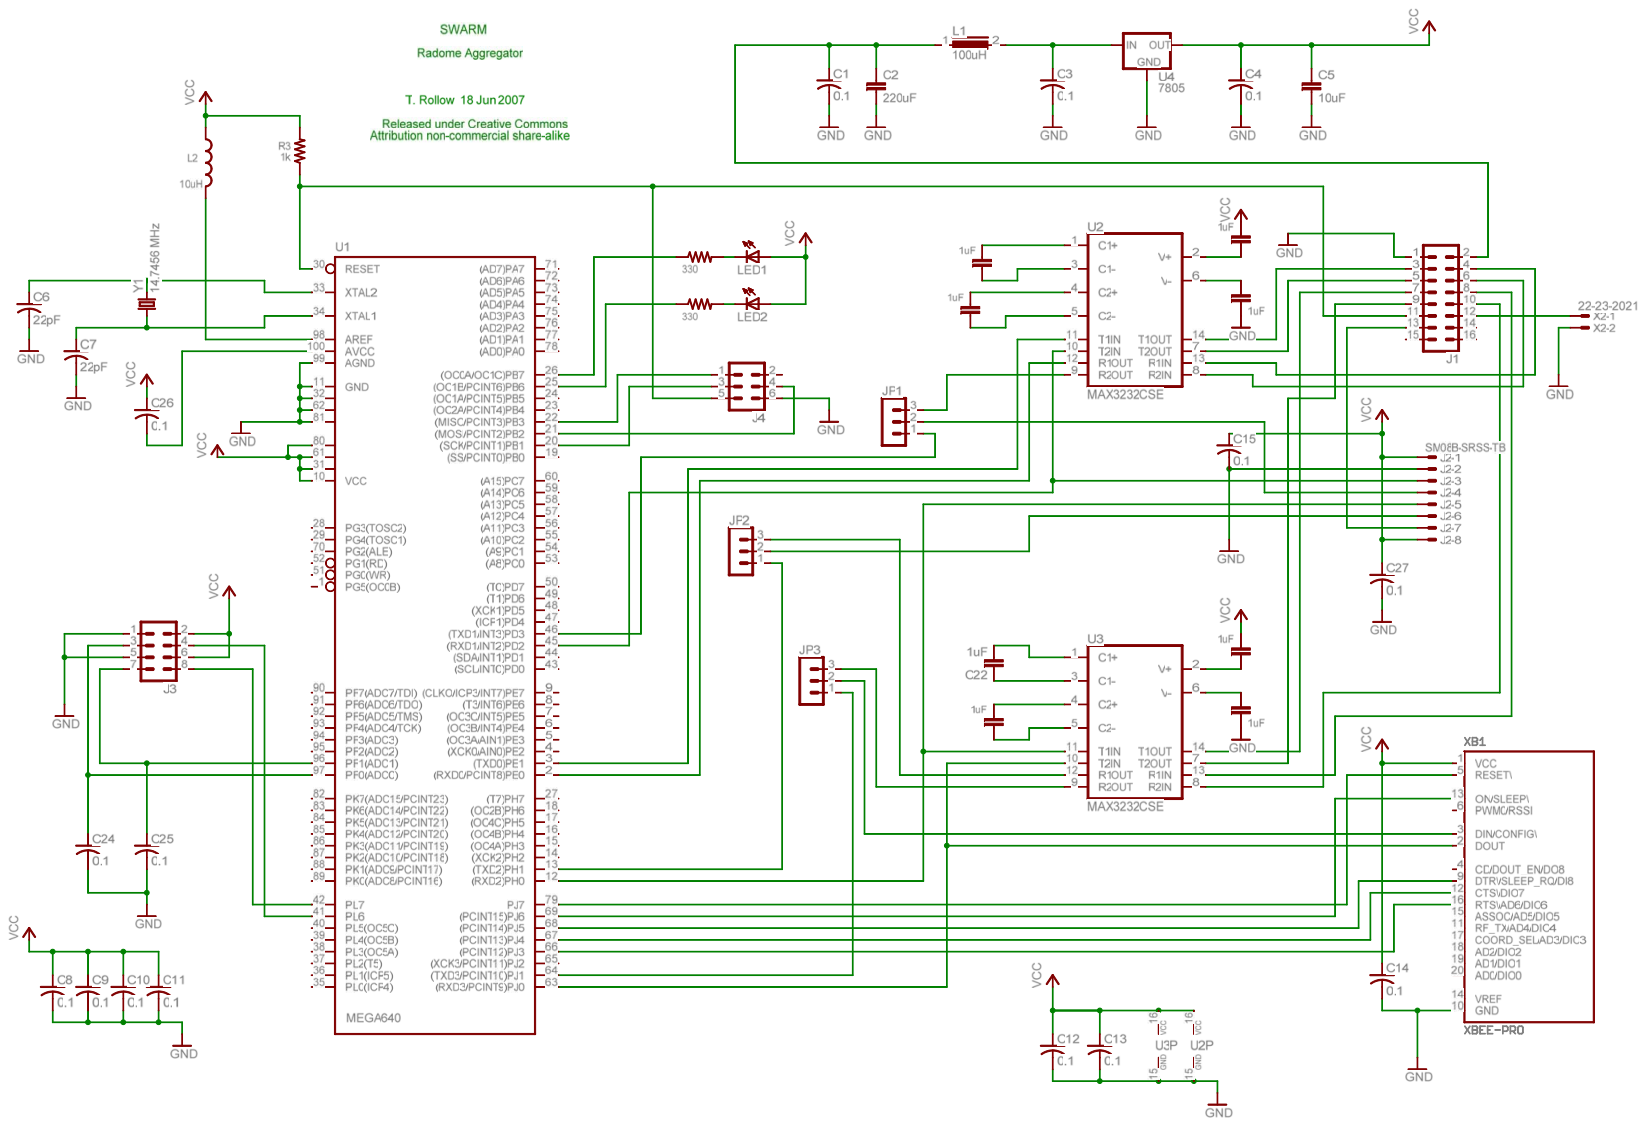
[picture p142: page 1]
