orbswarm/orbswarm-svn/pcb/Illuminator/RevE/ORBSWARM.pdf

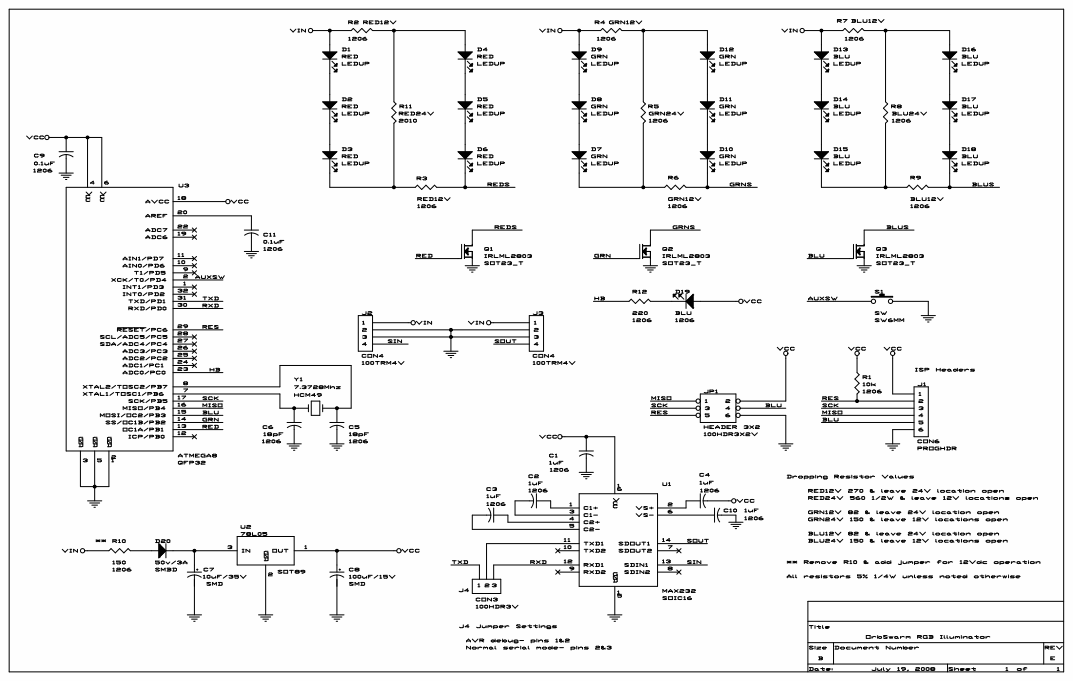
[picture p143: page 1]
