orbswarm/orbswarm-svn/pcb/daughterboard/rev1/daughterboard.pdf

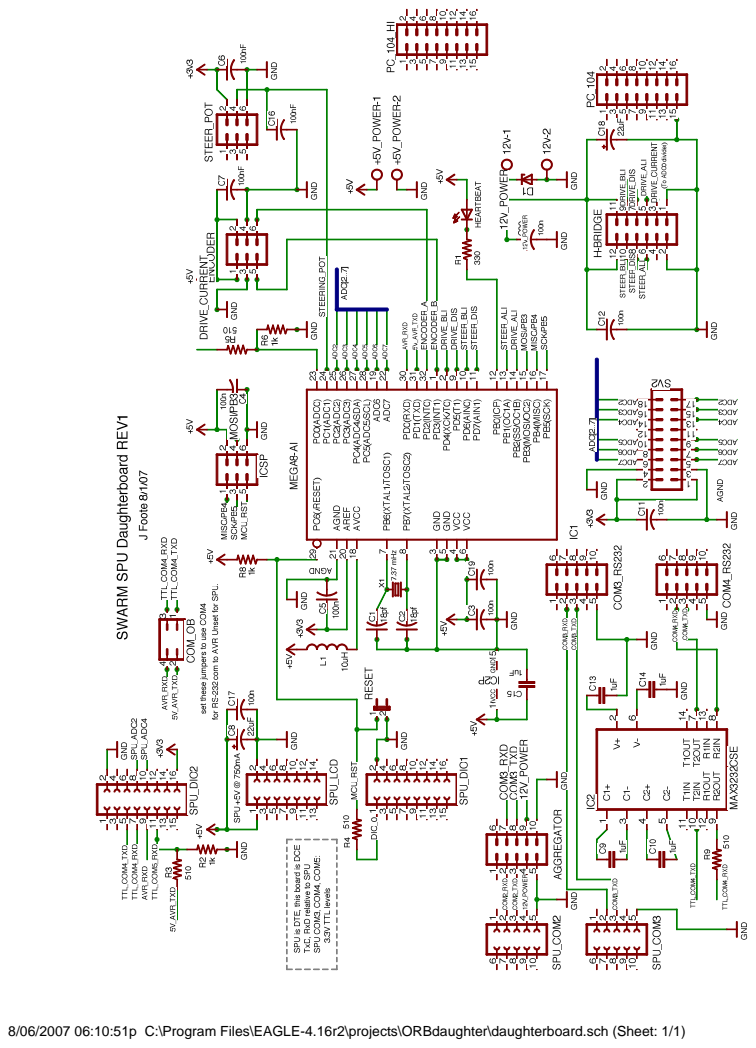
[picture p144: page 1]

8/06/2007 06:10:51p C:\Program Files\EAGLE-4.16r2\projects\ORBdaughter\daughterboard.sch (Sheet: 1/1)
