orbswarm/orbswarm-svn/pcb/aggregator/gerber-plots/drp.pdf

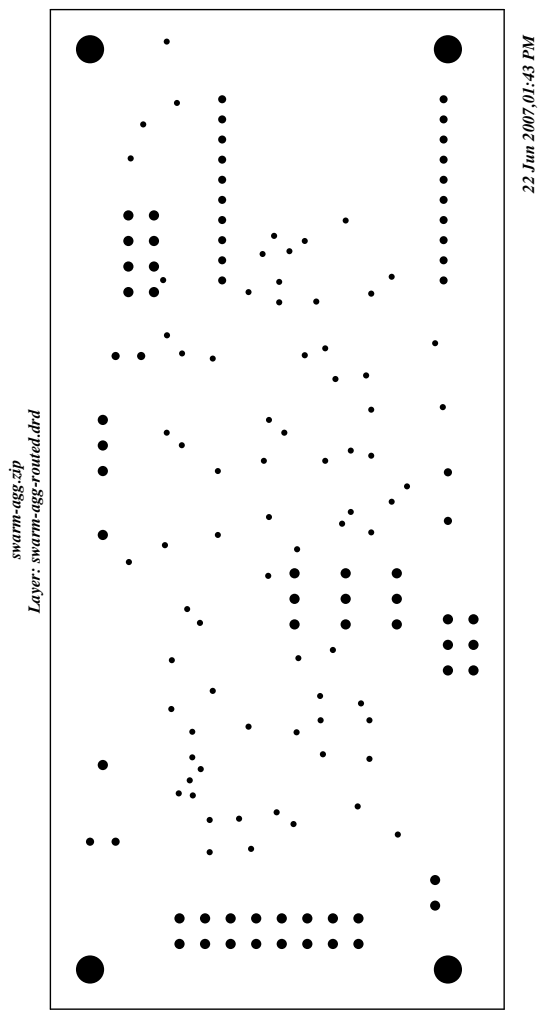
[picture p145: page 1]
22 Jun 2007,01:43 PM

Layer: swarm-agg-routed.drd

swarm-agg.zip
