orbswarm/orbswarm-svn/pcb/aggregator/gerber-plots/l1.pdf

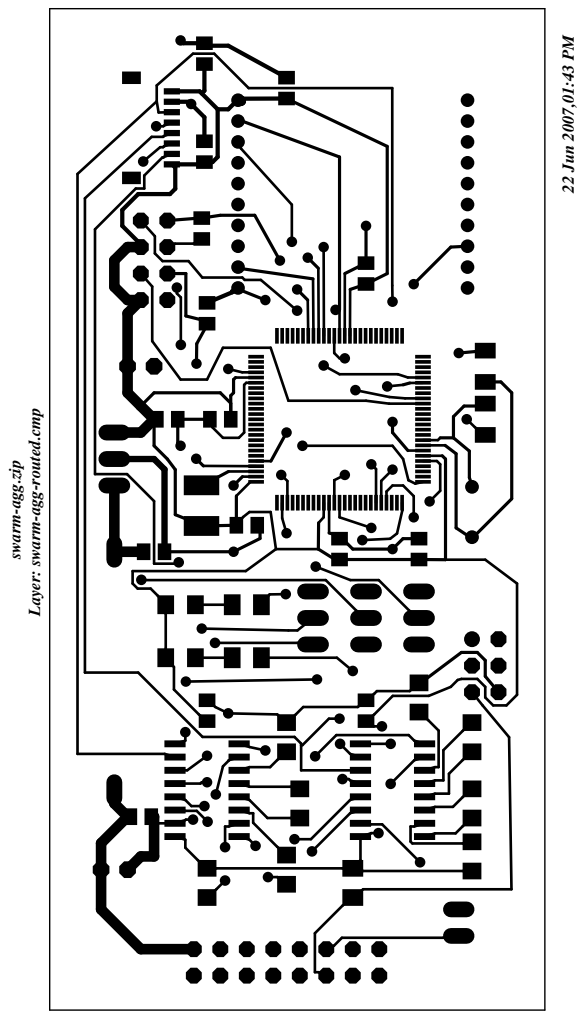
[picture p146: page 1]
22 Jun 2007,01:43 PM

Layer: swarm-agg-routed.cmp

swarm-agg.zip
