orbswarm/orbswarm-svn/pcb/aggregator/gerber-plots/lb.pdf

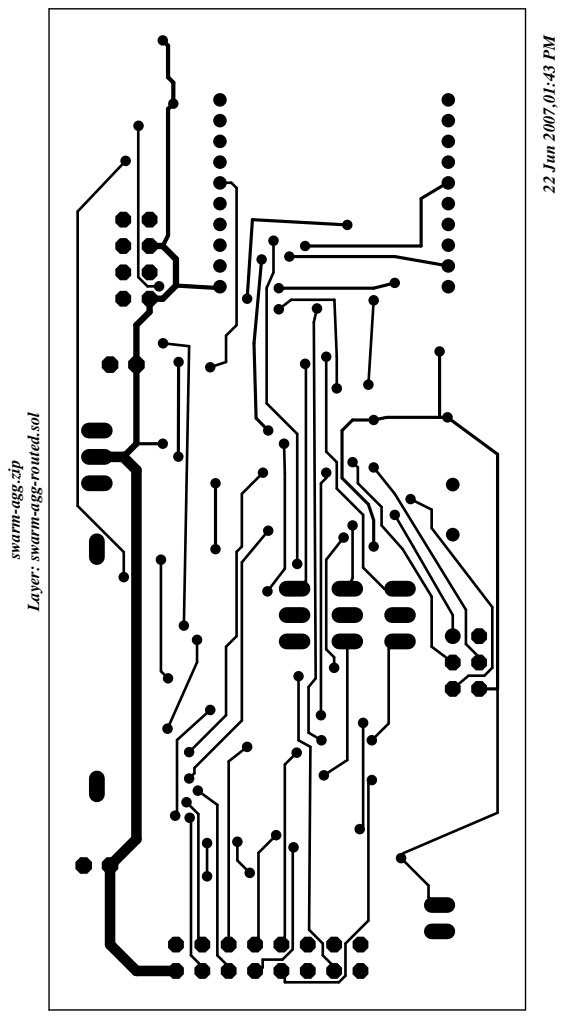
[picture p147: page 1]
22 Jun 2007,01:43 PM

Layer: swarm-agg-routed.sol

swarm-agg.zip
