orbswarm/orbswarm-svn/pcb/aggregator/gerber-plots/m1.pdf

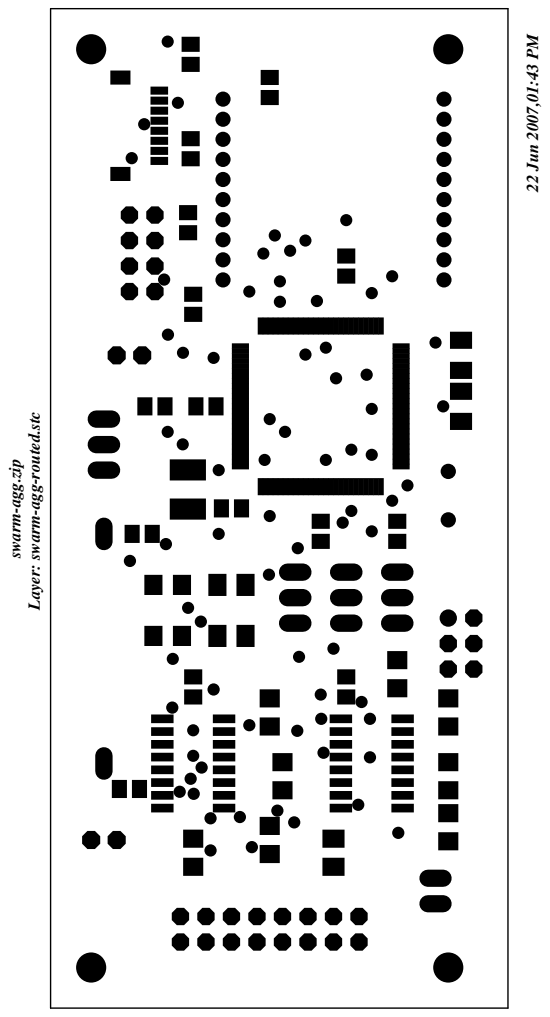
[picture p148: page 1]
22 Jun 2007,01:43 PM

Layer: swarm-agg-routed.stc

swarm-agg.zip
