orbswarm/orbswarm-svn/pcb/aggregator/gerber-plots/m2.pdf

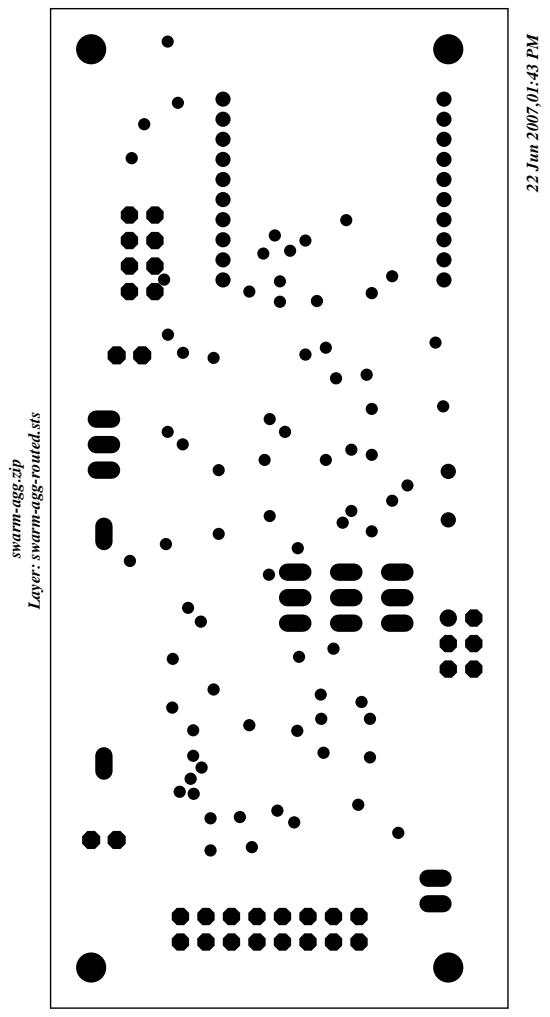
[picture p149: page 1]
22 Jun 2007,01:43 PM

Layer: swarm-agg-routed.sts

swarm-agg.zip
