orbswarm/orbswarm-svn/pcb/aggregator/gerber-plots/s1.pdf

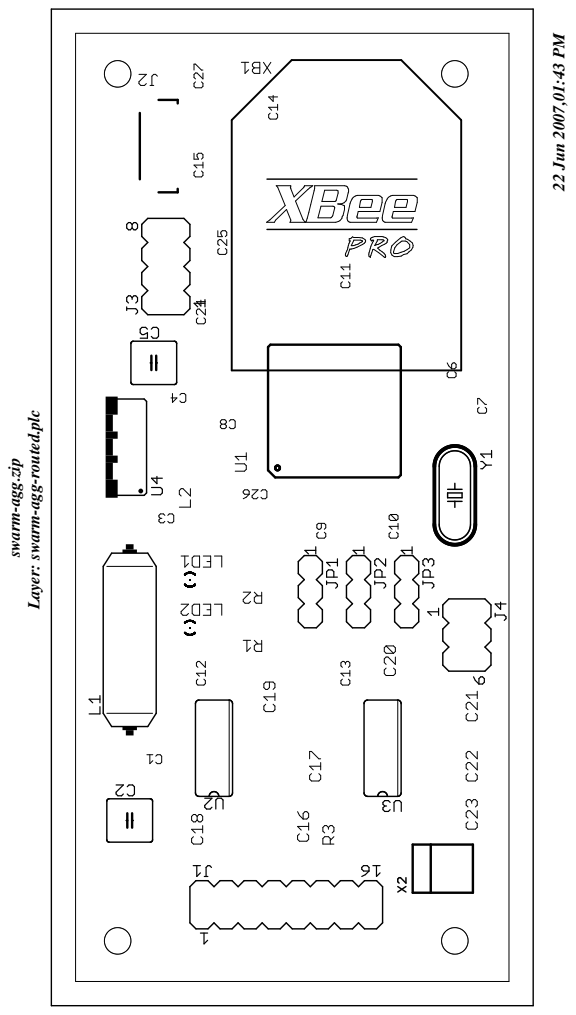
[picture p150: page 1]
22 Jun 2007,01:43 PM

Layer: swarm-agg-routed.plc

swarm-agg.zip
