orbswarm/orbswarm-svn/remote/old-xmit/Xmit_Schematic.pdf

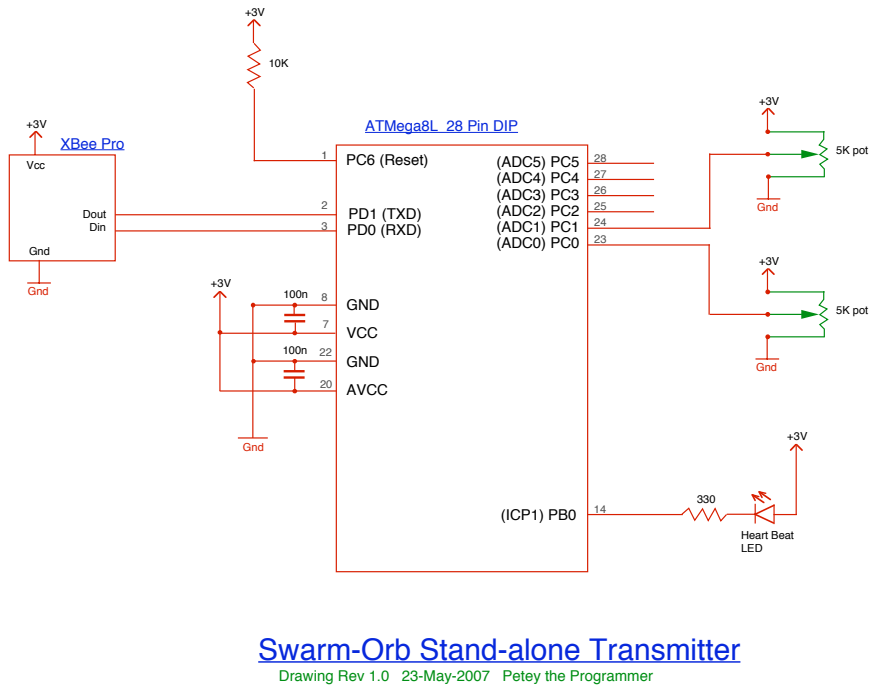
[picture p151: page 1]
Gnd; 5K pot; (ADC5) PC5 (ADC4) PC4 (ADC3) PC3 (ADC2) PC2 (ADC1) PC1 (ADC0) PC0; PC6 (Reset); GND; VCC; AVCC; (ICP1) PB0; Heart Beat LED; PD1 (TXD) PD0 (RXD); ATMega8L 28 Pin DIP; Vcc; Dout Din; XBee Pro

Swarm-Orb Stand-alone Transmitter

Drawing Rev 1.0 23-May-2007 Petey the Programmer
