orbswarm/orbswarm-svn/pcb/Illuminator/RevD/ORBSWARM.pdf

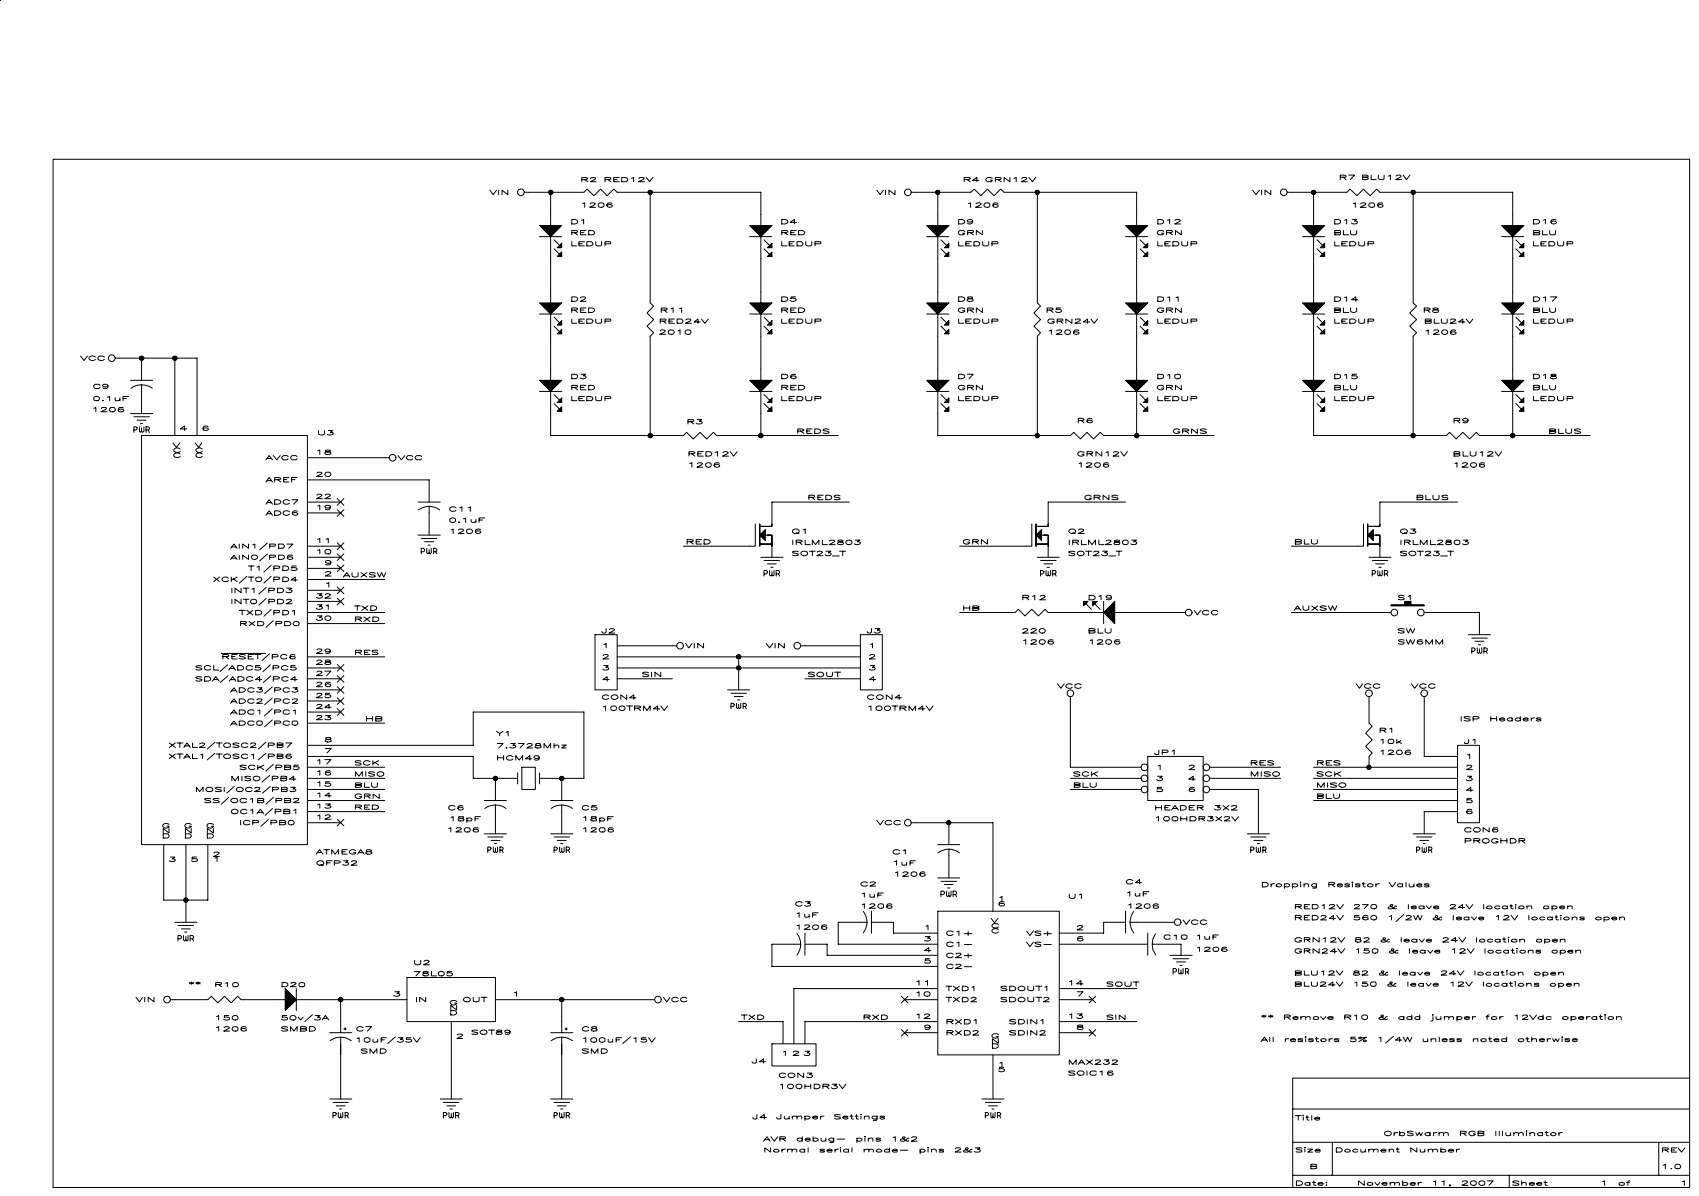
[picture p152: page 1]
