orbswarm/orbswarm-svn/pcb/Illuminator/RevC/ORBSWARM.pdf

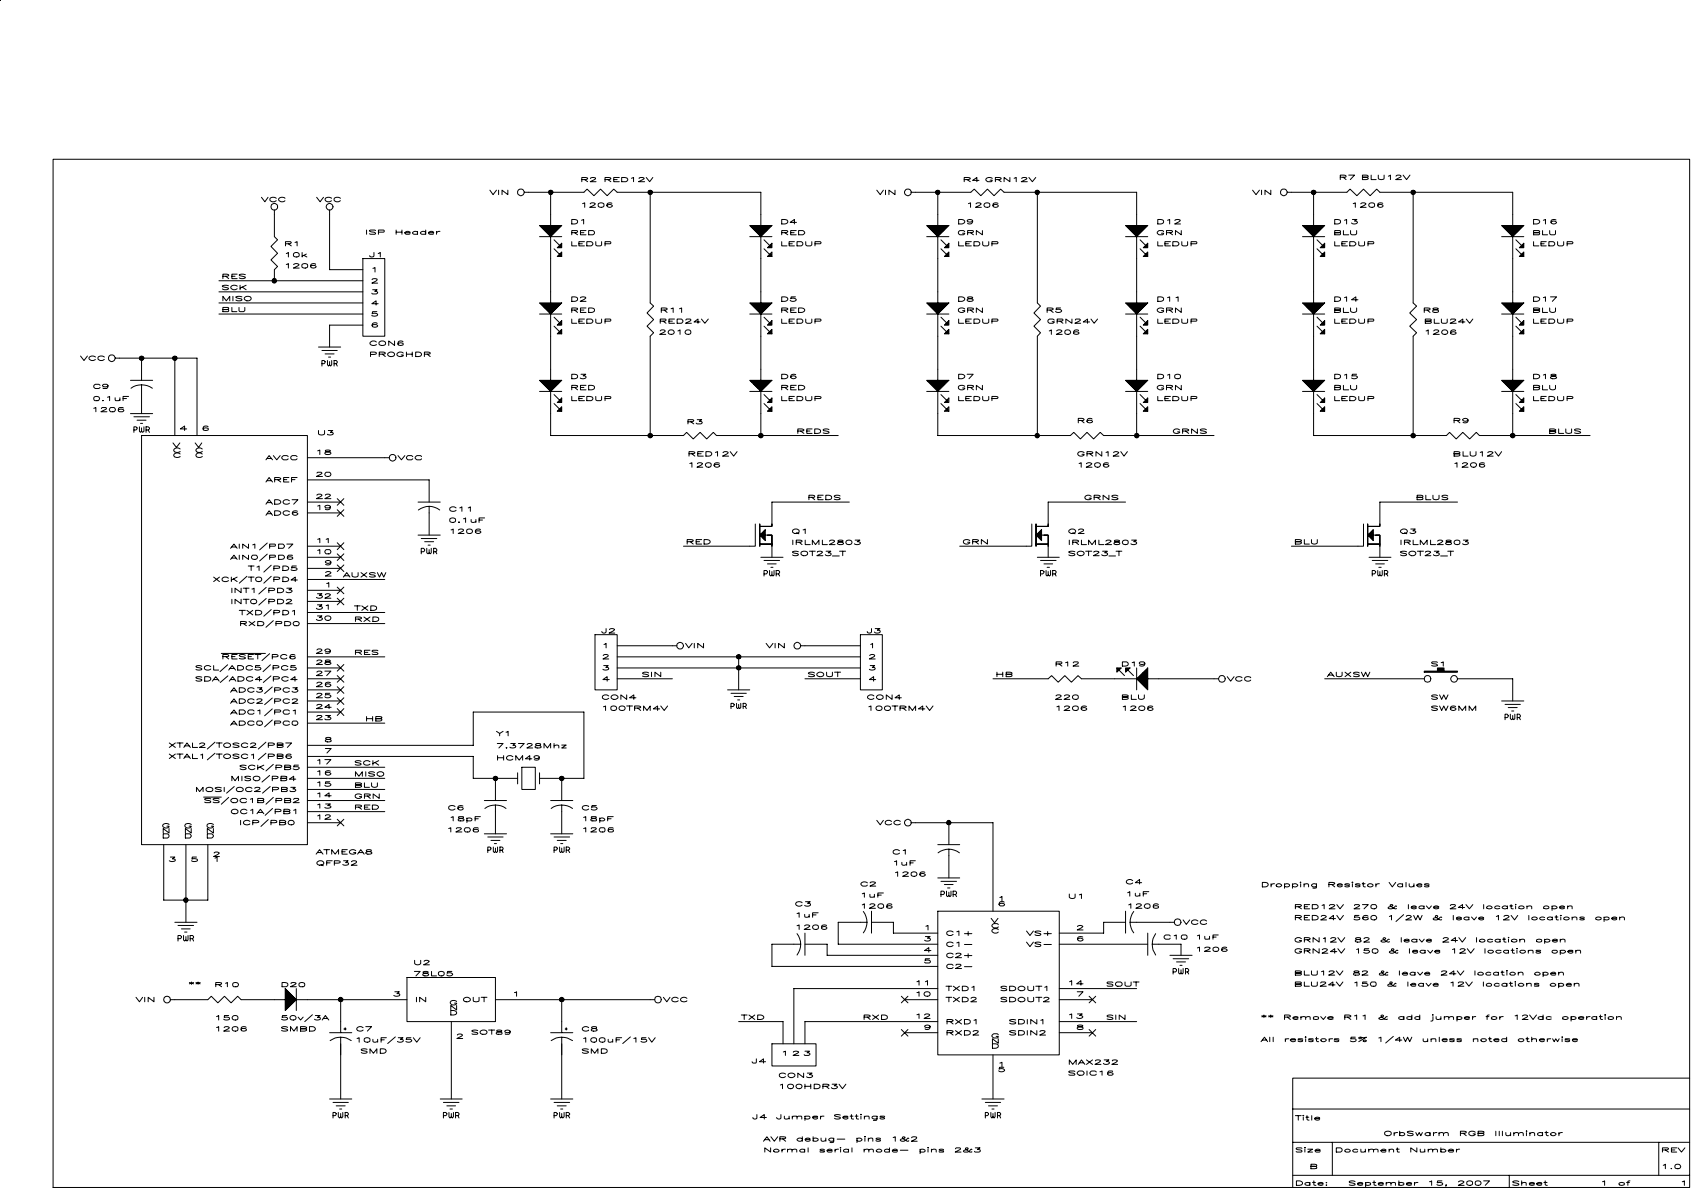
[picture p153: page 1]
