orbswarm/orbswarm-svn/pcb/Illuminator/RevB/ORBSWARM.pdf

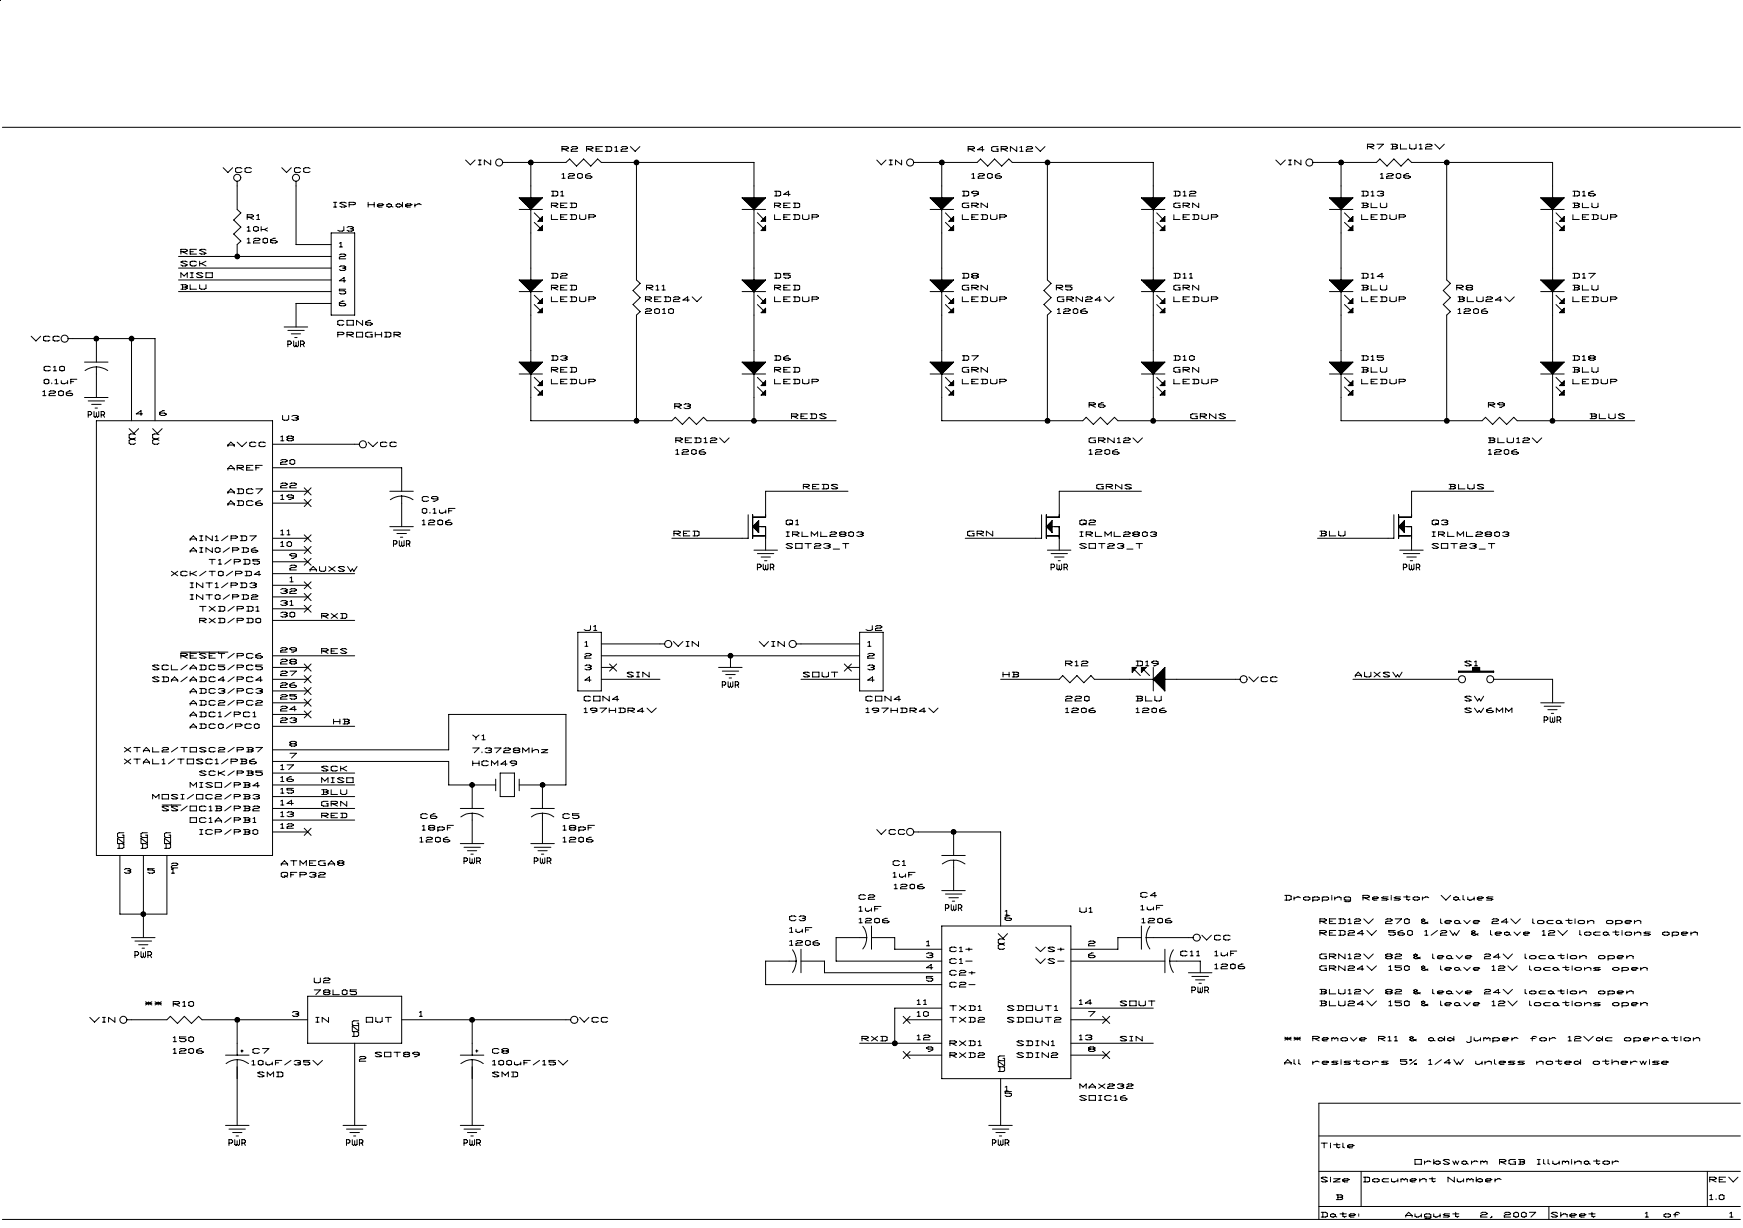
[picture p154: page 1]
