orbswarm/orbswarm-svn/pcb/Illuminator/RevA/ORBSWARM.pdf

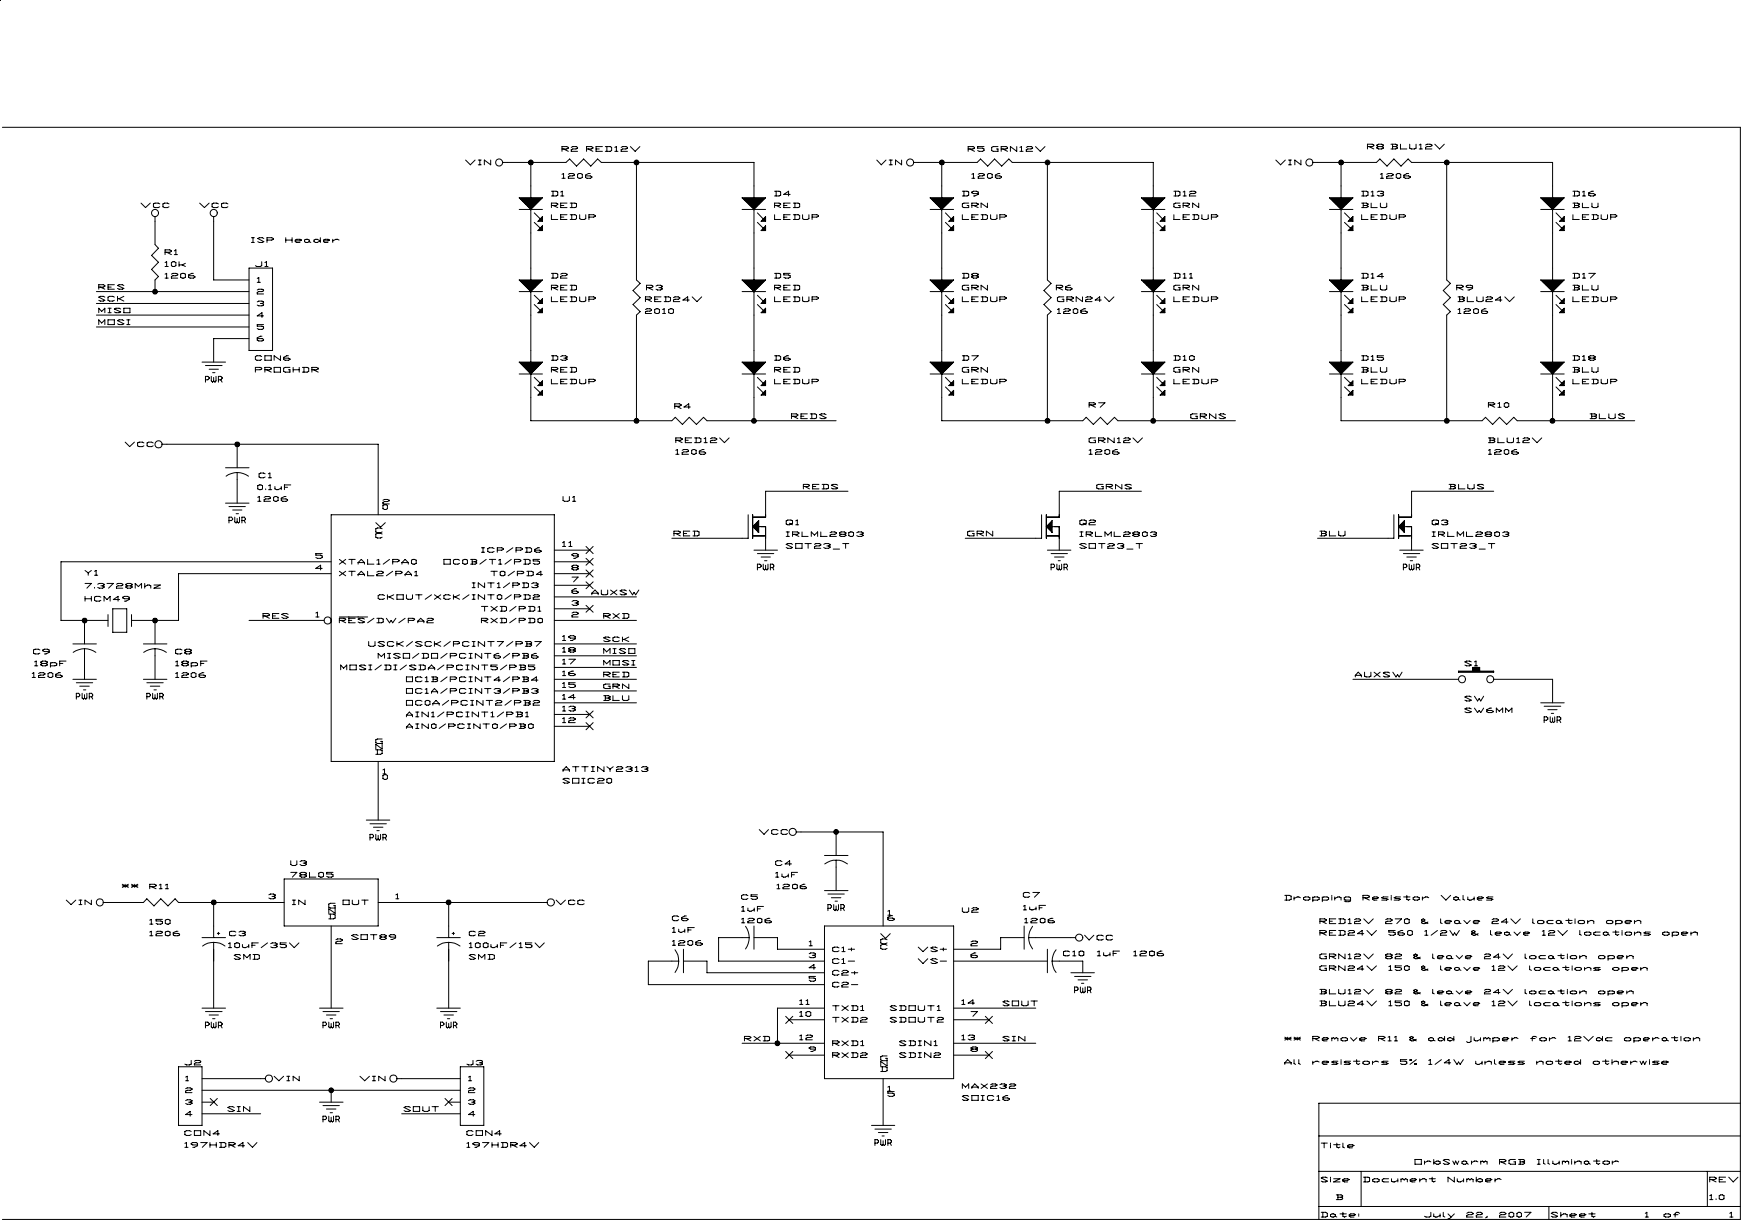
[picture p155: page 1]
