orbswarm/orbswarm-svn/dboard/atmega168/motor.c

// ---------------------------------------------------------------------
//
//	File: motor.c
//      SWARM Orb
//      Motor controller functions for SWARM Orb http://www.orbswarm.com
//
//	Refactored by Jonathan (Head Rotor at rotorbrain.com)
//      Original Version by Petey the Programmer  Date: 30-April-2007
// -----------------------------------------------------------------------

// This is the EEPROM address to store the motor PID coefficients
#define MOTOR_EEPROM	1

// Output 2 channels of PWM on PortB Pins 1&2
// Ouput 2 sets of control lines (Dir/Disable) on Port D 4:5 & 6:7
// Main Drive motor is setup as PID controlled continuous rotation (main drive)
// Steering Motor is setup as a Servo with a position sensing feedback pot.

#include <avr/io.h>
#include <stdlib.h>
#include <avr/eeprom.h>
#include "UART.h"
#include "a2d.h"
#include "putstr.h"
#include "encoder.h"
#include "motor.h"

// Hardware connections to H-Bridge controllers
// These are chip dependant port pins
// For ATMega8 OC1A is PortB:1, OC1B is PortB:2
//
// Speed Control Direction/Disable Pins are Port D4:5 & D6:7
//
//		PortB:1 = PWM Pin for Motor1
//		PortD:4 = Direction Pin for Motor1
//		PortD:5 = Disable Pin for Motor1 - Set High to disable H-Bridge
//
//		PortB:2 = PWM Pin for Motor2
//		PortD:6 = Direction Pin for Motor2
//		PortD:7 = Disable Pin for Motor2 - Set High to disable H-Bridge

// ------- New H-Bridge Hardware - OSSC --
// Switches PWM from non-inverted to inverted output when reversing directions.

#define MOTOR1_FORWARD()  PORTD &= ~_BV(PIND4); TCCR1A &= ~_BV(COM1B0); TCCR1A |= _BV(COM1B1)
#define MOTOR1_REVERSE()  PORTD |= _BV(PIND4); TCCR1A |= (_BV(COM1B0) | _BV(COM1B1))
#define MOTOR1_DISABLE() PORTD |= _BV(PIND5)
#define MOTOR1_ENABLE()  PORTD &= ~_BV(PIND5)
#define MOTOR1_BRAKE()   TCCR1A &= ~_BV(COM1B1)

#define MOTOR2_FORWARD() PORTD &= ~_BV(PIND6); TCCR1A &= ~_BV(COM1A0); TCCR1A |= _BV(COM1A1)
#define MOTOR2_REVERSE() PORTD |= _BV(PIND6); TCCR1A |= (_BV(COM1A0) | _BV(COM1A1))
#define MOTOR2_DISABLE() PORTD |= _BV(PIND7)
#define MOTOR2_ENABLE()  PORTD &= ~_BV(PIND7)
#define MOTOR2_BRAKE()   TCCR1A &= ~_BV(COM1A1)



static short iSum = 0;

extern volatile uint8_t Drive_Debug_Output;
extern volatile unsigned char doing_Speed_control;

extern volatile uint32_t odometer;
extern volatile short encoder1_speed;
extern volatile unsigned short encoder1_dir;

/* Static Vars */
static motor_control_block drive;
static motor_control_block steer;


/* Prototype */
void Motor_clear_mcb( motor_control_block *m );


// main feedback loop for speed control

void Drive_Servo_Task(void)
{
  short speedError;
  short drivePWM;
  int16_t p_term, d_term, i_term;

  // close enough to motionless
  if(abs(drive.targetSpeed) <= drive.dead_band){
    drive.targetSpeed = 0;
    Set_Motor1_PWM(0, FORWARD);
    return;
  }


  // get current speed
  drive.currentSpeed = encoder1_speed;

  // calculate error term
  speedError = drive.targetSpeed - drive.currentSpeed;
  // if currentSpeed is less than target, speed up:  positive PWM
  // if currentSpeed is more than target, slow down: negative PWM


  if (abs(speedError) < drive.dead_band) {
    // we are close enough to desired speed
    // don't change anything

    if (Drive_Debug_Output == 1)
      putstr("DRIVE speed OK ");
    return;
  }

  //if here, error is significant; change PWM to decrease it

  // calculate proportional term
  p_term = speedError * drive.Kp;

  // calculate derivative term
  d_term = drive.Kd * (drive.lastSpeedError - speedError);
  drive.lastSpeedError = speedError;

  // sum to integrate steering error
  iSum += speedError;

  //  and limit runaway
  limit(&iSum,-drive.intLimit,drive.intLimit);

  i_term = drive.Ki*iSum;
  i_term = i_term /8; //  (divide by 4) to scale

  drivePWM = p_term + d_term + i_term;
  drivePWM = drivePWM / 32; //  (divide to scale)

  drive.currentPWM = drivePWM;



  // If Debug Log is turned on, output PID data until position is stable
  if (Drive_Debug_Output == 1) {
    putstr("DRIVEspd targ curr ");
    putS16(drive.targetSpeed);
    putS16(drive.currentSpeed);
    putstr(" DrivePWM: ");
    putS16(drivePWM);
    putstr("  P,I,D: ");
    putS16(p_term);
    putS16(i_term);
    putS16(d_term);
    putstr(" int ");
    putS16(iSum);
    putstr("\r\n");
  }


  // use computed PWM to drive the motor
  // check current limit here -- reduce power if so?



  if (drivePWM < 0) {
    drive.currentDirection = REVERSE;
    drivePWM = abs(drivePWM);
  }
  else
    drive.currentDirection = FORWARD;

  if(drivePWM < drive.minPWM){
    drivePWM = drive.minPWM;
    if (Drive_Debug_Output)
      putstr("DRIVE under min\n");
  }

  // take care of absolute min and max
  // make sure arg2 < arg3
  limit( &drivePWM, drive.minPWM, drive.maxPWM);

  // limit change of drive: make sure arg2 < arg3
  limit( &drivePWM, drive.lastPWM - drive.deltaAccel,
	 drive.lastPWM + drive.deltaAccel);

  Set_Motor1_PWM((unsigned char) drivePWM, drive.currentDirection );

  //if(drive.currentDirection == FORWARD)
  //  Set_Motor1_PWM( drivePWM, drive.currentDirection );
  //else
  //    Set_Motor1_PWM(0, FORWARD );

  drive.lastPWM = (unsigned char)drivePWM;

}


// ----------------------------------------------------------------------
// Init Pulse Width Modulation hardware for Speed Controllers.
// Output 2 channels of PWM on PortB Pins 1&2
// Ouput 2 sets of control lines (Fwd/Rev) on Port D 4:5 & 6:7
// Main Drive motor is setup as PID controlled continous rotation (drive)
// Steering Motor is setup as a Servo with a position sensing feedback pot.

void Motor_PWM_Init(void)
{
  Motor_clear_mcb( &drive );		// Only drive uses Motor Control Block

  // Set Port Direction bits (1=Output) and enable PWM pins and timers

  DDRB |= (_BV(PINB1) | _BV(PINB2));							// PWM Pins
  DDRD |= (_BV(PIND4) | _BV(PIND5) | _BV(PIND6) | _BV(PIND7));	// Direction control pins

  MOTOR1_DISABLE();	// Disable before starting PWM
  MOTOR2_DISABLE();	// Set Disable Pins High to turn OFF H-Bridge

  TCCR1A |= (_BV(COM1A0) | _BV(COM1A1));	// Set OC1A on compare match
  TCCR1A |= (_BV(COM1B0) | _BV(COM1B1));	// Set OC1B on compare match

  TCCR1A |= _BV(WGM10);		// PWM Mode 2 ==> 8 Bit phase correct

  TCCR1B |= _BV(CS10);		// 1 prescale = 28.9 kHz PWM @ 14.7 MHz

  // Make sure motors are stopped
  Set_Motor1_PWM(0, FORWARD);
  Set_Motor2_PWM(0, FORWARD);
}

// --------------------------------------------------------
// Initialize the motor control blocks

void Motor_clear_mcb( motor_control_block *m )
{
	m->currentDirection = FORWARD;
	m->targetSpeed = 0;
	m->currentSpeed = 0;
	m->currentPWM = 0;
	m->lastSpeedError = 0;

// iTerm PID
	m->Kp = 25;
	m->Ki = 4;
	m->Kd = 10;
	m->dead_band = 3;
	m->deltaAccel = 100;
	m->minPWM = 10;
	m->maxPWM = 150;
	m->intLimit = 4000;
	m->maxCurrent = 20;
}

// ---------------------------------------------------------------------
// Special care must be taken writing to these 16 bit PWM registers.
// High byte must be written first.
// OCR1A and OCR1B swapped to reflect daughterboard

void write_drivePWM( unsigned char value )
{
	OCR1BH = 0;
	OCR1BL = value;
}

void write_steerPWM( unsigned char value )
{
	OCR1AH = 0;
	OCR1AL = value;
}


// Setup speed control PID
// This is also used to setup velocity control

void Set_Drive_Speed(short t)
{

    drive.targetSpeed = t;
}


// ----------------------------------------------------------------------
// Sets the Duty Cycle and direction of motor 1 - Main Drive Motor
// This routine is tied to specific Speed Control Hardware - OSSC
// Input pwm = 0..255


void Set_Motor1_PWM(unsigned char pwm, signed char direction)
{


  drive.currentDirection = direction;
  drive.currentPWM = pwm;

  if (pwm == 0)			// STOP - Turn off PWM
    {
      MOTOR1_DISABLE();
      write_drivePWM( 0 );

    }
  else
    {
      if (direction == FORWARD)
	{
	  MOTOR1_FORWARD();  // setup direction pin & non-inverted PWM
	  write_drivePWM( pwm );	// Set PWM as 16 bit value

	  //	  putstr("\n SforwardPWM: ");
	  //	  putS16((unsigned short)pwm);

	}
      else // direction == REVERSE
	{
	  MOTOR1_REVERSE();		// setup direction pin & inverted PWM
	  write_drivePWM( pwm );		// Set PWM as 16 bit value
	  //putstr("\n SreversePWM: ");
	  //putS16((unsigned short)pwm);
	}
      MOTOR1_ENABLE();
    }
}

// ----------------------------------------------------------------------
// Sets the Duty Cycle and direction of motor 2 - Steering Motor
// Input pwm = 0..255

void Set_Motor2_PWM(unsigned char pwm, signed char direction)
{
  if (pwm == 0)		// STOP - Turn off PWM
    {
      MOTOR2_DISABLE();
      write_steerPWM( 0 );
    }
  else
    {
      if(direction == FORWARD)
	{
	  MOTOR2_FORWARD();
	  write_steerPWM( pwm );	// Set PWM as 16 bit value
	}
      else // direction == REVERSE
	{
	  MOTOR2_REVERSE();
	  write_steerPWM( pwm );	// Set PWM as 16 bit value
	}
      MOTOR2_ENABLE();
    }
}


// ----------------------------------------------------------------------
// Setup the Gain factors via the Cmd line for testing & tuning.


void Drive_set_intLimit(short s){
  drive.intLimit = s;
}

void Drive_set_min(unsigned char c)
{
  drive.minPWM = c;
}
void Drive_set_max(unsigned char c)
{
  drive.maxPWM = c;
}
void Drive_set_dead_band(short s)
{
  drive.dead_band = s;
}

void Drive_set_integrator(short s)
{
  iSum = s;
}

void Drive_set_Kp(char c)
{
  drive.Kp = c;
}

void Drive_set_Ki(char c)
{
  drive.Ki = c;
}

void Drive_set_Kd(char c)
{
  drive.Kd = c;
}



// return motor status
void Get_Drive_Status(void)
{
  short theData;
  putstr("DTarget: ");
  putS16(drive.targetSpeed);
  putstr("\r\n Dcurrent:");
  putS16(encoder1_speed);
  putstr("\r\n curPWM ");
  putS16(drive.currentPWM);
  putstr("\r\n odo ");
  putS16((unsigned short)odometer);
  putstr("\r\nIsense:");
  theData = A2D_read_channel(CURRENT_SENSE_CHANNEL);
  putS16(theData);
  putstr("\r\n");
}
// ------------------------------------------------------------------------
// Dump motor data to serial port for feedback / debug / testing / tuning

void Motor_dump_data(void)
{
  short theData;
  putstr("Drive: (targ cur PWM) ");
  putS16(drive.targetSpeed);
  putS16(encoder1_speed);
  putS16(drive.currentPWM);
  putstr(" odo ");
  putS16((unsigned short)odometer);
  putstr("  PID:");
  putS16(drive.Kp);
  putS16(drive.Ki);
  putS16(drive.Kd);
  putstr("  ISense: ");
  theData = A2D_read_channel(CURRENT_SENSE_CHANNEL);
  putS16(theData);

  //  putstr("\r\n");
  putstr("\n       dead minP maxP delA");
  putS16(drive.dead_band);
  putS16(drive.minPWM);
  putS16(drive.maxPWM);
  putS16(drive.deltaAccel);
  putstr("\r\n");
}

// -----------------------------------------------------------------------

void Motor_save_PID_settings()
{
  char checksum = 0;
  checksum = (char)drive.Kp + (char)drive.Ki + (char)drive.Kd;
  eeprom_write_byte( MOTOR_EEPROM, (char)drive.Kp );
  eeprom_write_byte( MOTOR_EEPROM+1, (char)drive.Ki );
  eeprom_write_byte( MOTOR_EEPROM+2, (char)drive.Kd );
  eeprom_write_byte( MOTOR_EEPROM+3, checksum );

}

// ----------------------------------------------------------------------

void Motor_read_PID_settings()
{
  char v1,v2,v3,checksum;

  v1 = eeprom_read_byte( MOTOR_EEPROM );
  v2 = eeprom_read_byte( MOTOR_EEPROM+1 );
  v3 = eeprom_read_byte( MOTOR_EEPROM+2 );
  checksum = eeprom_read_byte( MOTOR_EEPROM+3 );

  putstr("Init Drive PID");
  if ((v1 + v2 + v3) == checksum)
    {	// checksum is OK - load values into motor control block
      drive.Kp = v1;
      drive.Ki = v2;
      drive.Kd = v3;
    }
  else
    putstr(" no cksum, defaults");
    putstr("\r\n");
}
// make sure minVal < maxVal (!)
short limit( short *v, short minVal, short maxVal)
{
	if (*v < minVal) *v = minVal;
	if (*v > maxVal) *v = maxVal;
	return *v;
}
