orbswarm/orbswarm-svn/remote/soundlist.h

int nfiles = 43;
char *soundlist[] =
{
"00208072", 			/* low bell */
"00681727",			/* high bell */
"02355482",		/* robot fx */
"05126045", 			/* robot fx */
"06973087",
"13534851",
"3755858",		/* musical interlude */
"11909292",			/* FM musical interlude */
"07863621",			/* vintage fx */
"08857788",
"09939968",
"19986384",
"13534851",	/* electric buzz */
"19986384",	/* eek */
"00808229", /*/orbsounds/FX/chimes/clock-bong.aiff*/
"07152985", /*/orbsounds/FX/chimes/clock-cuckoo.aiff*/
"41455851", /*/orbsounds/FX/chimes/DC_b3.aif*/
"55061608", /*/orbsounds/FX/chimes/DC_c2a.aif*/
"91316603", /*/orbsounds/FX/chimes/DC_e1a.aif*/
"48574905", /*/orbsounds/FX/chimes/DC_e3a.aif*/
"46258284", /*/orbsounds/FX/chimes/giantbell*/
"22651637", /*/orbsounds/FX/chimes/Harp.wav*/
"78817926", /*/orbsounds/FX/chimes/clock-clang.aiff*/
"76493399", /*/orbsounds/FX/chimes/LostInSpace_disappear.wav*/
"21259669", /*/orbsounds/FX/chimes/samantha.wav*/
"03739832", /*/orbsounds/FX/city/factorywhistle.wav*/
"08839452", /*/orbsounds/FX/city/Police_Siren.wav*/
"86771575", /*/orbsounds/FX/etc/bubblebrew.wav*/
"17562495", /*/orbsounds/FX/etc/doortrek2.wav*/
"23128989", /*/orbsounds/FX/etc/HalloweenOrgan*/
"46933574", /*/orbsounds/FX/etc/Radiotune2.wav*/
"29319371", /*/orbsounds/FX/pastoral/Birds2.aif*/
"73399011", /*/orbsounds/FX/pastoral/Cicada3.wav*/
"91171946", /*/orbsounds/FX/pastoral/Geese.wav*/
"37443050", /*/orbsounds/FX/pastoral/Hen_3.wav*/
"62114576", /*/orbsounds/FX/trek/06Materialization*/
"81121123", /*/orbsounds/FX/trek/17MainViewingScreen*/
"79477413", /*/orbsounds/FX/trek/69ShuttlecraftInterior*/
"85686752", /*/orbsounds/Markafiles/Xandoru_Wavs_to_Convert/Tuvan/tuvan_15489_djgriffin_tibetan_chant_4_colargol.aif*/
"07341872", /*/orbsounds/Markafiles/Xandoru_Wavs_to_Convert/Tuvan/tuvan_21208_djgriffin_low_chant_dry_1.aif*/
"44149708", /*/orbsounds/Markafiles/Xandoru_Wavs_to_Convert/Tuvan/tuvan_19040_djgriffin_kumi1_04.aif*/
"15115014", /*/orbsounds/MultiChannelSongs/Pythagorus/Pythagorus_4Dff.aif*/
"88849171", /*/orbsounds/MultiChannelSongs/Pythagorus/Pythagorus_3Bells.aif*/
  "\0"};
