orbswarm/orbswarm-svn/(commit log)

2007-05-01 Added IMU formatted output
2007-05-01 Changed format of IMU output
2007-05-07 Changed name to Motor Control Unit (MCU), added Schematic
2007-05-16 Fix bug in IMU.c
    [IMU.c]
2007-06-02 Fix Timer0 settings
2007-06-12 Added rudimentary logging and new steering PID params
2007-06-12 Initial checkin of unmodified Kalman Filter code with Makefile.ts tailored for 7200 board.
2007-06-15 Initial schematic checkin
    [swarm-agg1.brd, swarm-agg1.sch]
2007-06-15 Created PCB directory for circuit board designs
    [daughterboard.brd, daughterboard.sch]
2007-06-15 deleted conflicting pcb subdir
    [daughterboard.brd, daughterboard.sch]
2007-06-15 added daughterboard to PCB directory
    [daughterboard.brd, daughterboard.sch]
2007-06-15 added schematic pdf
2007-06-17 addition of pid tuner, but controller current not working
2007-06-18 Update with proper capacitor packages and bypass where needed
    [swarm-agg1.sch]
2007-06-19 improvments to pid tuner interface.
2007-06-19 Possibly the final set of changes
    [swarm-agg1.sch]
2007-06-19 An initial attempt at autoroute
    [swarm-agg1.brd]
2007-06-20 New autoroute attempts - 640 on top now
    [swarm-agg1a.brd]
2007-06-20 reordered contollers in pid tuner and change sign on contoller
2007-06-20 Initial Checkin-- General spu utilities for the swarm project. First routine is for toggling the spus onboard led's.
2007-06-20 Added defines for led toggle routine
2007-06-21 New versions of spu.cc and spuserial.cc spuserial.c tcflush had problems with com4, com5 so I nuked it spu.cc serves as pipe between com4, com5
    [swarmserial.cc]
2007-06-21 added "dboard" -- avr code for SPU daughterboard motor controller
    New include file global.h defines processor clock frequency
    New #defines in uart.h to support multiple clock frequencies
    Changed pin definitions to support daughterboard
2007-06-21 Fix Aref
    [swarm-agg1.sch]
2007-06-21 Autorouted after manual
    [swarm-agg1-ar.brd]
2007-06-21 with manual route
    [swarm-agg1.brd]
2007-06-21 added routed version of aggregator pcb
    [swarm-agg-routed.brd]
2007-06-22 Fixed DRC, made vias round
    [swarm-agg-routed.brd]
2007-06-22 New design rules for agg PCB
2007-06-22 Gerber files
2007-06-24 Gerber plots as pulled back from FreeDFM
2007-06-24 Pinlist for 640 on aggregator board
    [640pinlist.xls]
2007-06-26 New stuff in spu. Updates to spu.c: it's now a tunnel between com2 and com4 (the daughterboard). New COM port test commands readcom and writecom to sanity-check. spuutils now debugged, plus new funct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
    [swarmspuutils.cc]
2007-06-26 Added hbridge rev0 files (not done yet...soon)
    [SWARM-OSMC.brd, SWARM-OSMC.sch]
2007-06-26 Added rev1 boards -- two bugs fixed MISO MOSI swapped in serial programming header added 1k voltage conversion resistor to com4 ttl levels assorted prettiness
    [daughterboard.brd, daughterboard.sch]
2007-06-26 implementations for FSM XBee parser, aggregator queue etc.
    [640pinlist.xls]
2007-06-26 More revisions
    [SWARM-OSMC.brd, SWARM-OSMC.sch]
2007-06-27 new version supports IMU
2007-06-30 added missing prototype
2007-07-01 added prototype for spulog
2007-07-02 Updates to mothernode dashboard Updates to MCU inc. new steering PID routine
2007-07-04 factored PID controll into seperate library, small improvements to the system.
2007-07-11 almost done with hbridge!
    [SWARM-OSMC.brd, SWARM-OSMC.sch]
2007-07-17 Hoo boy. Major major rewrite. Many bugs fixed. New speed control, debugging. Not yet tested with hardware so beware....
    [IMU.c, IMU.h, a2d.c, encoder.c, encoder.h, main.c, motor.c, motor.h]
2007-07-21 Sent to fab today... fingers crossed!
    [SWARM-OSMC.brd, SWARM-OSMC.sch]
2007-07-25 Switched makefile compiler from nativecc to cygwincc
2007-07-25 Added a file remotely
    [OrbIlluminatorBOM.xls]
2007-07-25 Added items remotely
    S:\PROJECTS\ORBSWARM\ORBSWARM.SCH
    [ORBSWARM.SCH]
2007-07-26 Removed file/folder
    [OrbIlluminatorBOM.xls]
2007-07-26 Added items remotely
    E:\OrbIlluminatorBOM.xls
    [OrbIlluminatorBOM.xls]
2007-07-26 Updated motor controller API added mainloop.cc: framework for SPU main loop with 10hz timer.
2007-07-29 fixed makefile to reflect new spu/test dir; fixed some typos in includes
    [dashboard.py, swarmdefines.h, swarmspuutils.cc]
2007-08-03 Added sound module control files from Pete Burnright code; changed frequencies from fixed internal 8MHz oscillator to external 7.372 MHz crystal, and all associated speeds.
    [UART.c, UART.h, USI_UART.c, USI_UART_config.h, main.c, putstr.c]
2007-08-04 moving old stuff in motorController to ./prototype
2007-08-05 Adding Specialist framework for choreography module.
    -Simran
2007-08-05 Moved remotely
    [OrbIlluminatorBOM.xls]
2007-08-05 Uploading Eagle PCB project for Sound Module, including eps, sch and brd, all for the first time. -mark
    [SoundModule.brd, SoundModule.sch]
2007-08-06 fixed a small parsing bug
    [swarmspuutils.cc]
2007-08-06 minor sound module rev
    [SoundModule.brd, SoundModule.sch]
2007-08-06 another minor
    [SoundModule.brd, SoundModule.sch]
2007-08-06 Updates to schematic and board, per Jon's review.
    [SoundModule.brd, SoundModule.sch]
2007-08-06 added a missing semi colon
    [swarmdefines.h]
2007-08-06 Includes gerbers for FreeDRC check with AdvancedCircuits
    [SoundModule.brd, SoundModule.sch]
2007-08-07 How DARE you PANELIZE my DAUGHTERBOARD!!!
    [GMdboard.cfg, daughterboard.brd, daughterboard.sch]
2007-08-07 Added items remotely
    C:\ORCADDOS\PROJECTS\SWARM2\Output\LAYER1.GRB
    C:\ORCADDOS\PROJECTS\SWARM2\Output\LAYER4.GRB
    C:\ORCADDOS\PROJECTS\SWARM2\Output\MASK1.GRB
    C:\ORCADDOS\PROJECTS\SWARM2\Output\MASK4.GRB
    C:\ORCADDOS\PROJECTS\SWARM2\Output\ORBSWARM.NCD
    C:\ORCADDOS\PROJECTS\SWARM2\Output\ORBSWARM.pdf
    C:\ORCADDOS\PROJECTS\SWARM2\Output\SILK1.GRB
    C:\ORCADDOS\PROJECTS\SWARM2\Output\SILK4.GRB
    C:\ORCADDOS\PROJECTS\SWARM2\Output\SWARM2.zip
    C:\ORCADDOS\PROJECTS\SWARM2\Output\ORBSWARM.SCH
    [ORBSWARM.SCH]
2007-08-07 Initial implementation of logging. spumond and mainloop now log some basic status messages to /tmp/$SPULOG, with /tmp being the RAM disk. Future debugging messages should use this instead of printf o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
    [mainloop.cc]
2007-08-08 added new kalman filter directory
2007-08-08 re-added old kalman filter directory
2007-08-09 updated kalman numerical issues
    [kalman.c, kalmanswarm.c]
2007-08-09 updated kalman filter
2007-08-09 Added in functions to convert IMU data from millivolts to m/sec^2. These have been tested under a test harness in spu/test
2007-08-10 Corrected imuAccelToSI and imuYawToSI routines. These actually give reasonably accurate values now. ---dillo
    [swarmspuutils.cc]
2007-08-10 Test rig for IMU parsing and voltage->m/sec^2 conversion routines. This actually works now. ---'dillo
2007-08-10 minor changes
    [SPUbulkhead.dxf]
2007-08-11 Illuminator code works, including ultra-crude PWM.
2007-08-11 fixed a gps data strtok error
    [mainloop.cc]
2007-08-11 refactored GPS. IMU out of swarmspuutils
2007-08-12 Added a couple of util method signatures
2007-08-12 removed some print statements and added a - sign to the heading value.
2007-08-12 resolve conflicts for mainloop.cc
    [mainloop.cc]
2007-08-13 addition of sonar_test.cc test program, changes to adconverter.h, adconverter.cc read and decode sonar values.
2007-08-13 Added parse motor status incl. odometer
2007-08-13 added code for battery voltage measurement/inclusion of val in ad values struct
2007-08-13 Added timeline display to the mothernode/java code: - timeline files control the choreography, and will direct the color, sound, and motion of the orbs. - the timeline display goes below the arena, s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
    Right now only the timeline file reader and display are
    working. the events don't yet actually control anything.
    Simran
2007-08-13 added battery voltage out to genSpuDump()
2007-08-14 fixed a minor conflict
    [swarmdefines.h]
2007-08-14 Final SoundModule PCB info
    [BOM.xls]
2007-08-15 uncommented print statement for debugging
2007-08-15 replaced calls to strtok with strtok_r because it is safer. Added back in packetizing call for SPU_DUMP case.
    [mainloop.cc]
2007-08-15 replaced calls to strtok with strtok_r because it is safer.
    [swarmspuutils.cc]
2007-08-16 added motor data to gen spu dump
2007-08-17 SPU Bulkhead: Added Corel Draw file that was created based on DXF of 8/16/2007 for lasercutting
2007-08-19 Added orb address filtering of messages code
2007-08-19 - Integrated ColorScheme specialist into timeline - got PARAMETER events working on timeline. - Integrated RandomSongSpecialist into timeline, but it doesn't work yet: it seems to be wanting its own 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
    -Simran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
    [OrbIo.java]
2007-08-20 added joystick glue to swarmcon hooked up joysticks to timeline leitmotifs.
2007-08-20 fix for joystick button
2007-08-20 Implemented color changing attached to joystick button 2: left/right increments/decrements hue up/down " " value
2007-08-21 added Motor Controller verbocity level and io commands
2007-08-21 updated joystick support and motor control commands -trebor
2007-08-21 tweaks & twiddles on timeline and sound stuff. added button triggered event mechanism added timelines for all my multichannel songs and a couple fo the random songs
2007-08-22 commented out a printf
2007-08-23 Last minute twiddling. - fade colors explicitly to the orbs instead of using the on-board commands - attempt to get TriggerEvents working -- but they haven't succeeded yet. - added toggles to change 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
2007-08-23 Expect scripts for cross-platform copying and perm-setting of SPU binaries. These are designed for uploading files to the TS7260 embedded Linux board.
2007-08-23 More trigger work: - parametrized buttons: triggered events now affect only the orb they are triggered from - fixed the one-based, zero-based skew (joystick button numbers are zero-based, but their l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
2007-08-23 adding a Chimes timeline that assigns different chimes to different buttons.
2007-08-23 more twiddles to the trigger stuff -- can clear events on a button. and more elaboration to the Chimes timeline.
2007-08-24 put in JoyStick to orb mapping crossbar in case we need to adjust the mapping
2007-08-24 Alternative parser for AV and motor system with test data. This probably needs a bit more torture testing WRT state and half-chunks of messages, but it works with the included test files.
2007-08-24 Fix for re-assembling messages that break across a buffer. Now if a buffer contains half a message, it will keep state between buffers so it will be able to process the other half. Added comments des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
2007-08-28 replicating Jonathan's Hack: the parser isn't picking up all the commands, so we keep track of the current power/steer state of each orb, and send them every 100ms.
2007-09-05 Lots of changes done on-playa to get things going, twiddle the power settings, etc.
2007-09-10 Some code cleanup after playa: - implemented framework for setting swarmcon constants in a properties file at startup . put power_range, steering_range, and timeline size constants into framework. - 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
2007-09-11 Added items remotely
    S:\PROJECTS\SWARM2\Output\LAYER1.GRB
    S:\PROJECTS\SWARM2\Output\LAYER4.GRB
    S:\PROJECTS\SWARM2\Output\MASK1.GRB
    S:\PROJECTS\SWARM2\Output\MASK4.GRB
    S:\PROJECTS\SWARM2\Output\ORBSWARM.NCD
    S:\PROJECTS\SWARM2\Output\ORBSWARM.pdf
    S:\PROJECTS\SWARM2\Output\ORBSWARM.SCH
    S:\PROJECTS\SWARM2\Output\SILK1.GRB
    S:\PROJECTS\SWARM2\Output\SILK4.GRB
    S:\PROJECTS\SWARM2\Output\Swarm3.zip
    [ORBSWARM.SCH]
2007-09-13 Added items remotely
    S:\PROJECTS\SWARM2\Output\Orbswarm.NCD
    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
    [ORBSWARM.SCH]
2007-09-13 Added items remotely
    S:\OrbIlluminatorBOMRevC.xls
    [OrbIlluminatorBOMRevC.xls]
2007-09-16 Added items remotely
    C:\ORCADDOS\PROJECTS\SWARM2\Output\Orbswarm.NCD
    C:\ORCADDOS\PROJECTS\SWARM2\Output\Swarm3.zip
    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
    [ORBSWARM.SCH]
2007-09-19 Rev1 of motor controller pcb
    [SWARM-OSMC.brd, SWARM-OSMC.sch]
2007-09-19 Added new tabbed pane to the SwarmCon UI: - a tab for the color scheme & generative music controls - a new tab for some motion controls. . just power range and steering range for now.
2007-09-20 Second cut at parser using flex
2007-09-26 Toggles for controlling: - multiple motion commands: whether we send the current joystick position every n milliseconds (jonathan's hacque!) - multiple sound commands: repeat the sound commands to en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
    These all are in the config file and have toggles in the UI.
    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
2007-09-28 - automated the start/stop of python usb joystick process - multyjoy.py is stored in the jar file and started automatically - replaced the joystick data files in /tmp/ with stdin/stdout on python pro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
    [OrbIo.java]
2007-09-28 fixes done while testing Jon's new light board & parser on tuesday.
    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
2007-09-28 - reconnected joystick button and axis change events to the timeline (whoops). - changed steeringRefreshDelay to commandRefreshDelay and actually USED the value. :) -trebor
2007-11-17 Added items remotely
    C:\Documents and Settings\Rick Lellinger\Desktop\OrbIlluminatorBOMRevD.xls
    [OrbIlluminatorBOMRevD.xls]
2007-11-17 Added items remotely
    C:\ORCADDOS\PROJECTS\SWARM3\ORBSWARM.SCH
    [ORBSWARM.SCH]
2007-12-08 another test program and the uart utils
2007-12-10 UART code cleanup
2007-12-11 UART interface finished and tested. Working on the application code
2007-12-12 never block in interrupt handlers
2007-12-13 more elegant implementation of mutex by suspending interrupts
2007-12-13 another test case
2007-12-13 added critical sections to the spu and xbee asynch UART queues to enable us is to drop the oldest entry when the Q is full for a push() operation
2007-12-17 gps code and test case
2007-12-18 gps test case and bug fix
    [gps.c]
2008-02-13 Initial check-in of simplified remote board. Based off the original daughterboard schematic from pcb/daughterboard/rev1
    [remote.brd, remote.sch]
2008-02-13 Added XBeePro module and applied +3V to R1IN and R1OUT and R2OUT on MAX232 ---Dillo
    [remote.brd, remote.sch]
2008-02-13 Moved bypass CAP C12 to XBeePro which needs it.
    [remote.brd, remote.sch]
2008-02-13 Added ICSP back in. Dillo
    [remote.brd, remote.sch]
2008-02-15 Added sound module schematic in pdf format
2008-02-20 modifications to kalman filter
2008-02-29 modified kalman filter
2008-03-26 minor optimisations,reverted serial.c to old
    [dispatcher.c, serial.c]
2008-04-06 Region-based events for the timeline.
    These are events that get triggered when an orb enters or exits a particular region.
    Right now the simulation-based orb coordinates are used to determine when an orb is in a region.
    When the GPS data is accurate, then the regions will be triggered on the actual locations!
    (this particular code doesn't care which coordinates it gets -- it works the same either way).
    Regions are declared in the timeline file. We currently support rectangular regions specified
    with cartesian coordinates, in meters. Plus or minus relative to the origin. In the simulation, the
    origin is the lower left, so negative coordinates don't show up. In real life, we'll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
2008-04-08 new TemporaryColor specialist for region-based events: - when the event starts, it remembers the current color of any orbs it's affecting - then fades to the target color - then when the event stops,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
    This can be useful to make timelines in which a region changes the color of orbs that enter it,
    but they revert to their old color when they leave. You could also use this on button-triggered
    eve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
2008-04-23 more documentation on pinouts
    [640pinlist.xls]
2008-05-24 updated imuutils
2008-05-25 imu integration and gronkulator
2008-05-26 added de-bias to imuutils
2008-07-03 fixes and refactorings for GPS stuff
    [dispatcher.c, gpsutils.c, imuutils.c, swarmdefines.h, testharness.c]
2008-07-03 Velocity encoder support from Dillo.
2008-07-07 Doing blocked i/o to talk to the daughter board
2008-07-09 shaft encoder fixes
2008-07-16 serial fix - roll our own blocking read
    [dispatcher.c, gpsutils.c, serial.c, serial.h]
2008-07-18 updated imu messages
2008-07-18 updated imuutils for new imu message
2008-07-19 updated IMU.c
2008-07-19 Added items remotely
    \\.PSF\OrcadProjects\SWARM4\ORBSWARM.SCH
    [ORBSWARM.SCH]
2008-07-20 updated imu orientation
2008-07-21 kalman filter updates
2008-07-22 motor control tested
2008-07-22 updated kalman filter in dispatcher
2008-07-26 kalman filter output file
2008-07-26 fixed bugs in dispather.c
    [dispatcher.c]
2008-07-26 Fixed bad formatting of kalman output and cleaned up compiler warnings
    [dispatcher.c, feedback.c, gpsutils.h, kalmanswarm.h, matmath.c, serial.c, swarmdefines.h]
2008-07-28 mike and jon's fixes from first semi-scessful autonomy run
    [dispatcher.c, feedback.c, kalmanswarm.c]
2008-07-28 sign error in feedback.c and other bug fixes
    [dispatcher.c, feedback.c]
2008-08-06 bug fixes - fixed PMTK messages
    [main.c, spu.c]
2008-08-10 added SPI code
2008-08-11 SPI code initial cut
2008-08-11 yaw rate interface
2008-08-12 corrected yaw init
2008-08-15 spi update
2008-08-15 kalman filter
2008-08-15 changed LED com port, new spumond
2008-08-18 Updated makefiles to make "joypatcher" -- dispatcher w/o motor control
2008-08-19 lots of untested code - don't ask
    [640pinlist.xls]
2008-08-22 bug fixes from Mike, new spu messages for survey and origin
    [dispatcher.c, gronkulator.c, swarmdefines.h]
2008-08-22 origin msg fix, cntl params, test data
    [dispatcher.c, feedback.c]
2008-09-07 updated system to use in Angle class, which is currently included in the util.jar libarary.
2008-09-21 refactored pathing to smooth independant of scale. added a headroom point if need to give the orb some room to turn to a behind target. increased continouse path resolution to produce better yaw rate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
2009-03-16 compliation fix and test data
    [dispatcher.c, feedback.c, gronkulator.c, queues.h]
2010-07-16 changed println() to log in swarmcon package
2010-08-29 added filtering of items in store
2010-09-13 fixed copy bug and added an insert-all action
